EveAaA/DEBUG_SmartCar_main/DEBUG_SmartCar_PCB/DEBUG_DRV8701_MotorDriver/PCB参考布局布线图.jpg

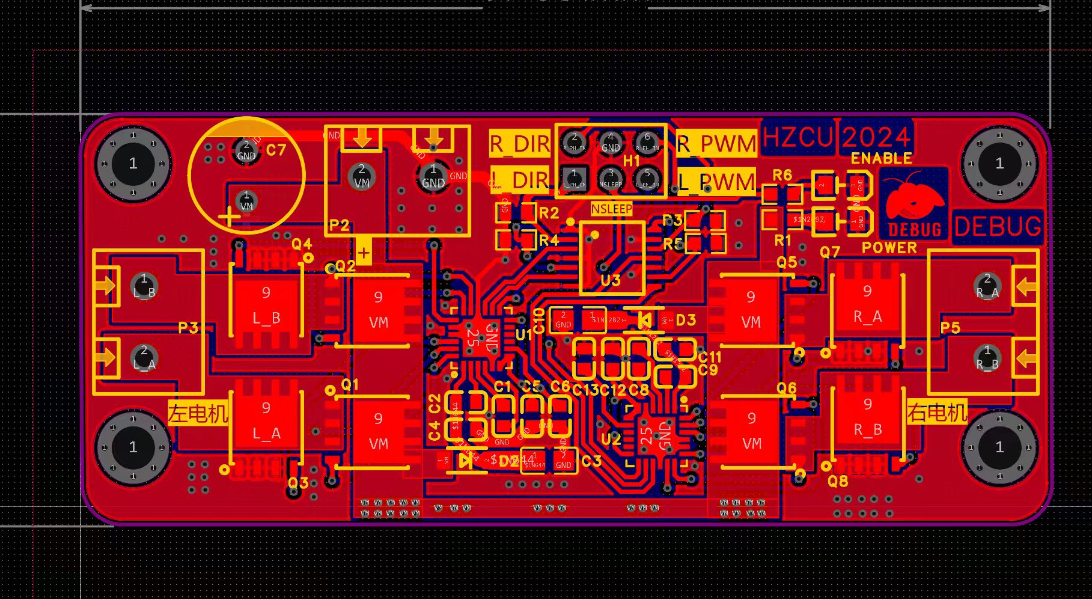
DEBUG_SmartCar_PCB/DEBUG_DRV8701_MotorDriver/PCB参考布局布线图.jpg
