EveAaA/DEBUG_SmartCar_main/DEBUG_SmartCar_PCB/DEBUG_SmartCar_MotherBoard_V4/引脚分配v1.3.xlsx

总钻风摄像头 | TXD | C29 | 3.3v
 | RXD | C28
 | PCLK | B20
 | VSY | B22
 | D0-D7 | B31-B24
正交编码器LF | A相 | C2 | 3.3v
 | B相 | C24
正交编码器LB | A相 | B16 | 3.3v
 | B相 | B17
正交编码器RF | A相 | C0 | 3.3v
 | B相 | C1
正交编码器RB | A相 | C3 | 3.3v
 | B相 | C25
IMU660RA | SCK | C23 | 3.3v
 | MOSI | C22
 | MISO | C21
 | CS | C20
 | INT | 悬空
 | NC | 悬空
单排针TFT1.8屏幕 | SCK | B0 | 3.3v
 | MOSI | B1
 | RST | B2
 | DC | C19
 | CS | B3
 | BL | C18
电机LF | DIR | C11
 | PWM | D12
电机RF | DIR | C31
 | PWM | D13
电机LB | DIR | C30
 | PWM | D15
电机RB | DIR | C27
 | PWM | D14
蓝牙模块 | TX(UART8) | D17 | 5v
 | RX | D16
 | RTS | D26
openart mini 1 | TX(UART1) | B13 | 5v
 | RX | B12
openart mini 2 | TX(UART4) | C17
 | RX | C16
openart mini 3 | TX(UART2) | B19
 | RX | B18
openart mini 4 | TX(UART3) | C9
 | RX | C8
DLB | SCL | B9 | 5v
 | SDA | B10
 | XS | D4
 | INT | B15
舵机1 左边 | PWM | D0 | 8v
舵机2 右边 | PWM | D1
舵机3 机械臂 | PWM | D2
舵机4 机械臂 | PWM | D3
舵机5 旋转 | PWM | B11
舵机6 开门 | PWM | C6
旋转编码器 A | INPUT | B23
旋转编码器 B | INPUT | B14
旋转编码器 D | INPUT | C26
有源蜂鸣器 | OUTPUT | B21 | 5v
电磁铁 1 | OUTPUT | C26
电磁铁 2 | OUTPUT | C12
电磁铁 3 | OUTPUT | C14
电磁铁 4 | OUTPUT | C15
电磁铁 5 | OUTPUT | C13
电磁铁 6 | OUTPUT | D27
