EveAaA/DEBUG_SmartCar_main/DEBUG_SmartCar_Vision/Src/PLAN_A_MT9V034/README.md

总钻风图像像素148 * 80

基本思路
1.高斯滤波
2.sobel边缘梯度提取
2.对梯度高斯加权 (harris角点检测思路)
3.非极大值抑制
4.对超过阈值角点做标记

算法未优化, 未整合

####
总风钻总体思路

实时检测获取跑道两侧图像梯度信息
若有多个置信度高的角点在某一侧, 即
小车往某一侧跑(也需要跑个死距离)

####
