EveAaA/DEBUG_SmartCar_main/DEBUG_SmartCar_Vision/MCX_DEBUG/project/mdk/Objects/mcx_vision_board.htm

# Static Call Graph for image .\Objects\mcx_vision_board.axf

#<CALLGRAPH># ARM Linker, 6190004: Last Updated: Tue Aug 6 01:49:51 2024

### Maximum Stack Usage = 1968 bytes + Unknown(Functions without stacksize, Cycles, Untraceable Function Pointers)

### Call chain for Maximum Stack Depth:

_printf_f ⇒ _printf_fp_dec ⇒ _printf_fp_dec_real ⇒ _fp_digits ⇒ _btod_main ⇒ _btod_common ⇒ _btod_pow ⇒ _btod_mul

### Functions with no stack information

- Reset_Handler
- ADC0_DriverIRQHandler
- ADC1_DriverIRQHandler
- BSP32_DriverIRQHandler
- BusFault_Handler
- CAN0_DriverIRQHandler
- CAN1_DriverIRQHandler
- CDOG0_DriverIRQHandler
- CDOG1_DriverIRQHandler
- CMC0_DriverIRQHandler
- CTI0_DriverIRQHandler
- DAC0_DriverIRQHandler
- DAC1_DriverIRQHandler
- DAC2_DriverIRQHandler
- DebugMon_Handler
- DefaultISR
- ELS_DriverIRQHandler
- ELS_ERR_DriverIRQHandler
- EMVSIM0_DriverIRQHandler
- EMVSIM1_DriverIRQHandler
- ENC0_COMPARE_DriverIRQHandler
- ENC0_HOME_DriverIRQHandler
- ENC0_IDX_DriverIRQHandler
- ENC0_WDG_SAB_DriverIRQHandler
- ENC1_COMPARE_DriverIRQHandler
- ENC1_HOME_DriverIRQHandler
- ENC1_IDX_DriverIRQHandler
- ENC1_WDG_SAB_DriverIRQHandler
- ERM_MULTI_BIT_ERROR_DriverIRQHandler
- ERM_SINGLE_BIT_ERROR_DriverIRQHandler
- ETB0_DriverIRQHandler
- ETHERNET_DriverIRQHandler
- ETHERNET_MACLP_DriverIRQHandler
- ETHERNET_PMT_DriverIRQHandler
- EWM0_DriverIRQHandler
- FLEXPWM0_FAULT_DriverIRQHandler
- FLEXPWM0_RELOAD_ERROR_DriverIRQHandler
- FLEXPWM0_SUBMODULE0_DriverIRQHandler
- FLEXPWM0_SUBMODULE1_DriverIRQHandler
- FLEXPWM0_SUBMODULE2_DriverIRQHandler
- FLEXPWM0_SUBMODULE3_DriverIRQHandler
- FLEXPWM1_FAULT_DriverIRQHandler
- FLEXPWM1_RELOAD_ERROR_DriverIRQHandler
- FLEXPWM1_SUBMODULE0_DriverIRQHandler
- FLEXPWM1_SUBMODULE1_DriverIRQHandler
- FLEXPWM1_SUBMODULE2_DriverIRQHandler
- FLEXPWM1_SUBMODULE3_DriverIRQHandler
- FLEXSPI0_DriverIRQHandler
- FMU0_DriverIRQHandler
- Freqme_DriverIRQHandler
- GDET_DriverIRQHandler
- GPIO00_DriverIRQHandler
- GPIO01_DriverIRQHandler
- GPIO10_DriverIRQHandler
- GPIO11_DriverIRQHandler
- GPIO20_DriverIRQHandler
- GPIO21_DriverIRQHandler
- GPIO30_DriverIRQHandler
- GPIO31_DriverIRQHandler
- GPIO40_DriverIRQHandler
- GPIO41_DriverIRQHandler
- GPIO50_DriverIRQHandler
- GPIO51_DriverIRQHandler
- HSCMP0_DriverIRQHandler
- HSCMP1_DriverIRQHandler
- HSCMP2_DriverIRQHandler
- I3C0_DriverIRQHandler
- I3C1_DriverIRQHandler
- ITRC0_DriverIRQHandler
- LPTMR0_DriverIRQHandler
- LPTMR1_DriverIRQHandler
- MAILBOX_DriverIRQHandler
- MRT0_DriverIRQHandler
- MemManage_Handler
- NPU_DriverIRQHandler
- OR_DriverIRQHandler
- OS_EVENT_DriverIRQHandler
- PDM_EVENT_DriverIRQHandler
- PINT0_DriverIRQHandler
- PKC_DriverIRQHandler
- PKC_ERR_DriverIRQHandler
- PORT_EFT_DriverIRQHandler
- PQ_DriverIRQHandler
- PUF_DriverIRQHandler
- RTC_DriverIRQHandler
- Reserved65_DriverIRQHandler
- Reserved80_DriverIRQHandler
- Reserved81_DriverIRQHandler
- Reserved85_DriverIRQHandler
- SAI0_DriverIRQHandler
- SAI1_DriverIRQHandler
- SCG_DriverIRQHandler
- SCT0_DriverIRQHandler
- SEC_HYPERVISOR_CALL_DriverIRQHandler
- SEC_VIO_DriverIRQHandler
- SINC_FILTER_DriverIRQHandler
- SM3_DriverIRQHandler
- SMARTDMA_DriverIRQHandler
- SPC_DriverIRQHandler
- SecureFault_Handler
- TRNG0_DriverIRQHandler
- TSI_END_OF_SCAN_DriverIRQHandler
- TSI_OUT_OF_SCAN_DriverIRQHandler
- USB0_DCD_DriverIRQHandler
- USB0_FS_DriverIRQHandler
- USB1_HS_DriverIRQHandler
- USB1_HS_PHY_DriverIRQHandler
- UTICK0_DriverIRQHandler
- UsageFault_Handler
- VBAT0_DriverIRQHandler
- WUU_DriverIRQHandler
- WWDT0_DriverIRQHandler
- WWDT1_DriverIRQHandler
- NMI_Handler
- SVC_Handler
- PendSV_Handler
- SysTick_Handler
- OR_IRQHandler
- EDMA_0_CH0_IRQHandler
- EDMA_0_CH1_IRQHandler
- EDMA_0_CH2_IRQHandler
- EDMA_0_CH3_IRQHandler
- EDMA_0_CH4_IRQHandler
- EDMA_0_CH5_IRQHandler
- EDMA_0_CH6_IRQHandler
- EDMA_0_CH7_IRQHandler
- EDMA_0_CH8_IRQHandler
- EDMA_0_CH9_IRQHandler
- EDMA_0_CH10_IRQHandler
- EDMA_0_CH11_IRQHandler
- EDMA_0_CH12_IRQHandler
- EDMA_0_CH13_IRQHandler
- EDMA_0_CH14_IRQHandler
- EDMA_0_CH15_IRQHandler
- UTICK0_IRQHandler
- MRT0_IRQHandler
- CTIMER0_IRQHandler
- CTIMER1_IRQHandler
- SCT0_IRQHandler
- CTIMER2_IRQHandler
- LP_FLEXCOMM0_IRQHandler
- LP_FLEXCOMM1_IRQHandler
- LP_FLEXCOMM2_IRQHandler
- LP_FLEXCOMM3_IRQHandler
- LP_FLEXCOMM6_IRQHandler
- LP_FLEXCOMM7_IRQHandler
- LP_FLEXCOMM8_IRQHandler
- LP_FLEXCOMM9_IRQHandler
- ADC0_IRQHandler
- ADC1_IRQHandler
- PINT0_IRQHandler
- PDM_EVENT_IRQHandler
- Reserved65_IRQHandler
- USB0_FS_IRQHandler
- USB0_DCD_IRQHandler
- RTC_IRQHandler
- MAILBOX_IRQHandler
- CTIMER3_IRQHandler
- CTIMER4_IRQHandler
- OS_EVENT_IRQHandler
- FLEXSPI0_IRQHandler
- SAI0_IRQHandler
- SAI1_IRQHandler
- USDHC0_IRQHandler
- CAN0_IRQHandler
- CAN1_IRQHandler
- Reserved80_IRQHandler
- Reserved81_IRQHandler
- USB1_HS_PHY_IRQHandler
- USB1_HS_IRQHandler
- SEC_HYPERVISOR_CALL_IRQHandler
- Reserved85_IRQHandler
- PLU_IRQHandler
- Freqme_IRQHandler
- SEC_VIO_IRQHandler
- ELS_IRQHandler
- PKC_IRQHandler
- PUF_IRQHandler
- PQ_IRQHandler
- EDMA_1_CH0_IRQHandler
- EDMA_1_CH1_IRQHandler
- EDMA_1_CH2_IRQHandler
- EDMA_1_CH3_IRQHandler
- EDMA_1_CH4_IRQHandler
- EDMA_1_CH5_IRQHandler
- EDMA_1_CH6_IRQHandler
- EDMA_1_CH7_IRQHandler
- EDMA_1_CH8_IRQHandler
- EDMA_1_CH9_IRQHandler
- EDMA_1_CH10_IRQHandler
- EDMA_1_CH11_IRQHandler
- EDMA_1_CH12_IRQHandler
- EDMA_1_CH13_IRQHandler
- EDMA_1_CH14_IRQHandler
- EDMA_1_CH15_IRQHandler
- CDOG0_IRQHandler
- CDOG1_IRQHandler
- I3C0_IRQHandler
- I3C1_IRQHandler
- NPU_IRQHandler
- GDET_IRQHandler
- VBAT0_IRQHandler
- EWM0_IRQHandler
- TSI_END_OF_SCAN_IRQHandler
- TSI_OUT_OF_SCAN_IRQHandler
- EMVSIM0_IRQHandler
- EMVSIM1_IRQHandler
- FLEXIO_IRQHandler
- DAC0_IRQHandler
- DAC1_IRQHandler
- DAC2_IRQHandler
- HSCMP0_IRQHandler
- HSCMP1_IRQHandler
- HSCMP2_IRQHandler
- FLEXPWM0_RELOAD_ERROR_IRQHandler
- FLEXPWM0_FAULT_IRQHandler
- FLEXPWM0_SUBMODULE0_IRQHandler
- FLEXPWM0_SUBMODULE1_IRQHandler
- FLEXPWM0_SUBMODULE2_IRQHandler
- FLEXPWM0_SUBMODULE3_IRQHandler
- FLEXPWM1_RELOAD_ERROR_IRQHandler
- FLEXPWM1_FAULT_IRQHandler
- FLEXPWM1_SUBMODULE0_IRQHandler
- FLEXPWM1_SUBMODULE1_IRQHandler
- FLEXPWM1_SUBMODULE2_IRQHandler
- FLEXPWM1_SUBMODULE3_IRQHandler
- ENC0_COMPARE_IRQHandler
- ENC0_HOME_IRQHandler
- ENC0_WDG_SAB_IRQHandler
- ENC0_IDX_IRQHandler
- ENC1_COMPARE_IRQHandler
- ENC1_HOME_IRQHandler
- ENC1_WDG_SAB_IRQHandler
- ENC1_IDX_IRQHandler
- ITRC0_IRQHandler
- BSP32_IRQHandler
- ELS_ERR_IRQHandler
- PKC_ERR_IRQHandler
- ERM_SINGLE_BIT_ERROR_IRQHandler
- ERM_MULTI_BIT_ERROR_IRQHandler
- FMU0_IRQHandler
- ETHERNET_IRQHandler
- ETHERNET_PMT_IRQHandler
- ETHERNET_MACLP_IRQHandler
- SINC_FILTER_IRQHandler
- LPTMR0_IRQHandler
- LPTMR1_IRQHandler
- SCG_IRQHandler
- SPC_IRQHandler
- WUU_IRQHandler
- PORT_EFT_IRQHandler
- ETB0_IRQHandler
- SM3_IRQHandler
- TRNG0_IRQHandler
- WWDT0_IRQHandler
- WWDT1_IRQHandler
- CMC0_IRQHandler
- CTI0_IRQHandler
- Abs
- Activation
- Add
- BatchMulAdd
- BitTransformation
- CallKernel
- CallKernelWrapper
- CastInt16ToInt8
- CastInt8ToInt16
- Conv1DStandard
- Conv2DAtrous
- Conv2DDepthwiseNeutron16x16Kernel3x3
- Conv2DDepthwiseV1
- Conv2DDepthwiseV2
- Conv2DPointwise
- Conv2DStandardV1
- Conv2DStandardV2
- Conv2DStandardV3
- DebugLog
- EXEC
- FullyConnected
- GetKernelArgSz
- GetKernelArgSzWrapper
- GetMaxArgSz
- GlobalAvgPool
- GlobalMaxPool
- InvokeDebugLogCallback
- MaxPool
- MemCpy
- MirrorPad
- MulInt16
- NeutronFirmwareTraceInit
- NeutronMicroInstrPost
- NeutronMicroInstrPre
- Pad
- Sequence
- Slice
- TfLiteIntArrayEqual
- TfLiteIntArrayGetSizeInBytes
- TfLiteTypeGetName
- Upsample2DV1
- MicroPrintf(char const*, ...)
- VMicroPrintf(char const*, std::__va_list)
- AbortImpl()
- flatbuffers::Vector⟨long⟩ const* flatbuffers::Table::GetPointer⟨flatbuffers::Vector⟨long⟩ const*⟩(unsigned short)
- tflite::PadPrepare(TfLiteContext*, TfLiteNode*)
- tflite::ParseSlice(tflite::Operator const*, tflite::ErrorReporter*, tflite::BuiltinDataAllocator*, void**)
- tflite::PrepareAdd(TfLiteContext*, TfLiteNode*)
- tflite::AlignSizeUp(unsigned int, unsigned int)
- tflite::ParseConv2D(tflite::Operator const*, tflite::ErrorReporter*, tflite::BuiltinDataAllocator*, void**)
- tflite::ElementCount(TfLiteIntArray const&)
- tflite::MicroContext::AllocateTempInputTensor(TfLiteNode const*, int)
- tflite::MicroContext::AllocateTempOutputTensor(TfLiteNode const*, int)
- tflite::ParseSoftmax(tflite::Operator const*, tflite::ErrorReporter*, tflite::BuiltinDataAllocator*, void**)
- tflite::Register_ADD()
- tflite::Register_PAD()
- tflite::tensor_utils::UnpackDenseInt4IntoInt8(signed char const*, int, signed char*)
- tflite::ErrorReporter::Report(char const*, ...)
- tflite::ParseQuantize(tflite::Operator const*, tflite::ErrorReporter*, tflite::BuiltinDataAllocator*, void**)
- tflite::reference_ops::ProcessBroadcastShapes(tflite::RuntimeShape const&, tflite::RuntimeShape const&, tflite::ArithmeticParams*)
- void tflite::reference_ops::BroadcastAddRecursiveDimensions⟨float⟩(int, unsigned int*, unsigned int*, unsigned int*, unsigned int*, unsigned int*, unsigned int*, float, float, float const*, float const*, float*)
- void tflite::reference_ops::BroadcastAddRecursiveDimensions⟨long⟩(int, unsigned int*, unsigned int*, unsigned int*, unsigned int*, unsigned int*, unsigned int*, long, long, long const*, long const*, long*)
- void tflite::reference_ops::BroadcastAddRecursiveDimensions⟨short⟩(tflite::ArithmeticParams const&, int, unsigned int*, unsigned int*, unsigned int*, unsigned int*, unsigned int*, unsigned int*, short const*, short const*, short*)
- tflite::reference_ops::MaxPool(tflite::PoolParams const&, tflite::RuntimeShape const&, float const*, tflite::RuntimeShape const&, float*)
- void tflite::reference_ops::PadImpl⟨signed char, signed char⟩(tflite::PadParams const&, tflite::RuntimeShape const&, signed char const*, signed char const*, tflite::RuntimeShape const&, signed char*)
- void tflite::reference_ops::PadImpl⟨float, float⟩(tflite::PadParams const&, tflite::RuntimeShape const&, float const*, float const*, tflite::RuntimeShape const&, float*)
- void tflite::reference_ops::PadImpl⟨long, long⟩(tflite::PadParams const&, tflite::RuntimeShape const&, long const*, long const*, tflite::RuntimeShape const&, long*)
- void tflite::reference_ops::PadImpl⟨short, short⟩(tflite::PadParams const&, tflite::RuntimeShape const&, short const*, short const*, tflite::RuntimeShape const&, short*)
- tflite::AlignPointerUp(unsigned char*, unsigned int)
- tflite::DequantizeEval(TfLiteContext*, TfLiteNode*)
- tflite::DequantizeInit(TfLiteContext*, char const*, unsigned int)
- tflite::GetBuiltinCode(tflite::OperatorCode const*)
- tflite::GetTensorShape(TfLiteTensor const*)
- tflite::HaveSameShapes(TfLiteTensor const*, TfLiteTensor const*)
- tflite::MicroAllocator::AllocateVariables(tflite::SubGraph const*, TfLiteEvalTensor*, long const*)
- tflite::MicroAllocator::AllocateTempBuffer(unsigned int, unsigned int)
- tflite::MicroAllocator::DeallocateTempBuffer(unsigned char*)
- tflite::MicroAllocator::IsAllTempDeallocated()
- tflite::MicroAllocator::ResetTempAllocations()
- tflite::MicroAllocator::StartModelAllocation(tflite::Model const*)
- tflite::MicroAllocator::FinishModelAllocation(tflite::Model const*, tflite::SubgraphAllocations*, tflite::ScratchBufferHandle**)
- tflite::MicroAllocator::InitScratchBufferData()
- tflite::MicroAllocator::CommitStaticMemoryPlan(tflite::Model const*, tflite::SubgraphAllocations*, tflite::ScratchBufferHandle*)
- tflite::MicroAllocator::GetBuiltinDataAllocator()
- tflite::MicroAllocator::AllocatePersistentBuffer(unsigned int)
- tflite::MicroAllocator::AllocateTempTfLiteTensor(tflite::Model const*, tflite::SubgraphAllocations const*, int, int)
- tflite::MicroAllocator::GetScratchBufferRequests()
- tflite::MicroAllocator::AllocateTfLiteEvalTensors(tflite::Model const*, tflite::SubgraphAllocations*)
- tflite::MicroAllocator::DeallocateTempTfLiteTensor(TfLiteTensor*)
- tflite::MicroAllocator::RequestScratchBufferInArena(unsigned int, int, int*)
- tflite::MicroAllocator::AllocateNodeAndRegistrations(tflite::Model const*, tflite::SubgraphAllocations*)
- tflite::MicroAllocator::AllocateScratchBufferHandles(tflite::ScratchBufferHandle**, unsigned int)
- tflite::MicroAllocator::FinishPrepareNodeAllocations(int)
- tflite::MicroAllocator::AllocatePersistentTfLiteTensor(tflite::Model const*, tflite::SubgraphAllocations const*, int, int)
- tflite::MicroAllocator::PopulateTfLiteTensorFromFlatbuffer(tflite::Model const*, TfLiteTensor*, int, int, bool)
- tflite::MicroAllocator::AllocatePersistentTfLiteTensorInternal()
- tflite::MicroAllocator::Create(tflite::SingleArenaBufferAllocator*, tflite::MicroMemoryPlanner*)
- tflite::MicroAllocator::Create(unsigned char*, unsigned int, tflite::MemoryPlannerType)
- tflite::MicroAllocator::~MicroAllocator__deallocating()
- tflite::MicroAllocator::~MicroAllocator()
- tflite::MicroAllocator::~MicroAllocator__sub_object()
- tflite::PoolingPrepare(TfLiteContext*, TfLiteNode*)
- tflite::Register_SLICE()
- tflite::ConvParamsFloat(TfLiteConvParams const&, tflite::OpDataConv const&)
- tflite::ParseDequantize(tflite::Operator const*, tflite::ErrorReporter*, tflite::BuiltinDataAllocator*, void**)
- tflite::AlignPointerDown(unsigned char*, unsigned int)
- tflite::MicroInterpreter::AllocateTensors()
- tflite::MicroInterpreter::PrepareNodeAndRegistrationDataFromFlatbuffer()
- tflite::MicroInterpreter::Init(tflite::MicroProfilerInterface*)
- tflite::MicroInterpreter::Reset()
- tflite::MicroInterpreter::input(unsigned int)
- tflite::MicroInterpreter::Invoke()
- tflite::MicroInterpreter::output(unsigned int)
- tflite::MicroInterpreter::MicroInterpreter(tflite::Model const*, tflite::MicroOpResolver const&, unsigned char*, unsigned int, tflite::MicroResourceVariables*, tflite::MicroProfilerInterface*, bool)
- tflite::MicroInterpreter::MicroInterpreter__sub_object(tflite::Model const*, tflite::MicroOpResolver const&, unsigned char*, unsigned int, tflite::MicroResourceVariables*, tflite::MicroProfilerInterface*, bool)
- tflite::MicroInterpreter::~MicroInterpreter()
- tflite::MicroInterpreter::~MicroInterpreter__sub_object()
- tflite::Register_CONV_2D()
- tflite::Register_SOFTMAX()
- tflite::TfLiteTypeSizeOf(TfLiteType, unsigned int*)
- tflite::ConvertTensorType(tflite::TensorType, TfLiteType*)
- tflite::ConvertTensorType(tflite::TensorType, TfLiteType*, tflite::ErrorReporter*)
- tflite::DequantizePrepare(TfLiteContext*, TfLiteNode*)
- tflite::Register_QUANTIZE()
- tflite::MicroErrorReporter::Report(char const*, std::__va_list)
- tflite::MicroErrorReporter::~MicroErrorReporter__deallocating()
- tflite::MicroErrorReporter::~MicroErrorReporter()
- tflite::MicroErrorReporter::~MicroErrorReporter__sub_object()
- tflite::MicroMemoryPlanner::PrintMemoryPlan()
- tflite::MicroMemoryPlanner::Init(unsigned char*, int)
- tflite::MicroMemoryPlanner::AddBuffer(int, int, int, int)
- tflite::ParseConcatenation(tflite::Operator const*, tflite::ErrorReporter*, tflite::BuiltinDataAllocator*, void**)
- tflite::QuantizeMultiplier(double, long*, int*)
- tflite::ReverseSortInPlace(int*, int*, int)
- tflite::CalculateOpDataConv(TfLiteContext*, TfLiteNode*, TfLiteConvParams const&, int, int, int, int, int, int, TfLiteType, tflite::OpDataConv*)
- tflite::ConvParamsQuantized(TfLiteConvParams const&, tflite::OpDataConv const&)
- tflite::GreedyMemoryPlanner::GetBufferCount()
- tflite::GreedyMemoryPlanner::PrintMemoryPlan()
- tflite::GreedyMemoryPlanner::GetOffsetForBuffer(int, int*)
- tflite::GreedyMemoryPlanner::GetMaximumMemorySize()
- tflite::GreedyMemoryPlanner::CalculateOffsetsIfNeeded()
- tflite::GreedyMemoryPlanner::NextSimultaneouslyActiveBuffer(tflite::GreedyMemoryPlanner::ListEntry const*, int, int)
- tflite::GreedyMemoryPlanner::Init(unsigned char*, int)
- tflite::GreedyMemoryPlanner::AddBuffer(int, int, int)
- tflite::GreedyMemoryPlanner::AddBuffer(int, int, int, int)
- tflite::GreedyMemoryPlanner::GreedyMemoryPlanner()
- tflite::GreedyMemoryPlanner::GreedyMemoryPlanner__sub_object()
- tflite::GreedyMemoryPlanner::~GreedyMemoryPlanner__deallocating()
- tflite::GreedyMemoryPlanner::~GreedyMemoryPlanner()
- tflite::GreedyMemoryPlanner::~GreedyMemoryPlanner__sub_object()
- tflite::LinearMemoryPlanner::GetBufferCount()
- tflite::LinearMemoryPlanner::GetOffsetForBuffer(int, int*)
- tflite::LinearMemoryPlanner::GetMaximumMemorySize()
- tflite::LinearMemoryPlanner::AddBuffer(int, int, int)
- tflite::LinearMemoryPlanner::LinearMemoryPlanner()
- tflite::LinearMemoryPlanner::LinearMemoryPlanner__sub_object()
- tflite::LinearMemoryPlanner::~LinearMemoryPlanner__deallocating()
- tflite::LinearMemoryPlanner::~LinearMemoryPlanner()
- tflite::LinearMemoryPlanner::~LinearMemoryPlanner__sub_object()
- tflite::MaxPoolingEvalFloat(TfLiteContext*, TfLiteNode*, TfLitePoolParams*, tflite::OpDataPooling const*, TfLiteEvalTensor const*, TfLiteEvalTensor*)
- tflite::Register_DEQUANTIZE()
- tflite::ScopedMicroProfiler::~ScopedMicroProfiler()
- tflite::ScopedMicroProfiler::~ScopedMicroProfiler__sub_object()
- tflite::CalculateInputRadius(int, int, int)
- tflite::NumSubgraphOperators(tflite::Model const*, int)
- tflite::NumSubgraphOperators(tflite::SubGraph const*)
- tflite::ParseDepthwiseConv2D(tflite::Operator const*, tflite::ErrorReporter*, tflite::BuiltinDataAllocator*, void**)
- tflite::Register_MAX_POOL_2D()
- tflite::AllocationInfoBuilder::ValidateSubgraph(tflite::SubGraph const*, TfLiteEvalTensor*)
- tflite::AllocationInfoBuilder::FreeAllocationInfo()
- tflite::AllocationInfoBuilder::CreateAllocationInfo(int)
- tflite::AllocationInfoBuilder::MarkAllocationLifetimes(int, tflite::internal::ScratchBufferRequest*, tflite::ScratchBufferHandle*, tflite::SubgraphAllocations*)
- tflite::AllocationInfoBuilder::GetOfflinePlannedOffsets(long const**)
- tflite::AllocationInfoBuilder::InitializeAllocationInfo(long const*, tflite::SubgraphAllocations*)
- tflite::AllocationInfoBuilder::MarkSubgraphLifetimesIfNecessary(tflite::Operator const*, tflite::internal::ScratchBufferRequest*, tflite::ScratchBufferHandle*, tflite::SubgraphAllocations*)
- tflite::EvalQuantizeReference(TfLiteContext*, TfLiteNode*)
- tflite::GetMicroErrorReporter()
- tflite::MicroContextGetTensor(TfLiteContext const*, int)
- tflite::MicroInterpreterGraph::NumSubgraphs()
- tflite::MicroInterpreterGraph::FreeSubgraphs()
- tflite::MicroInterpreterGraph::InitSubgraphs()
- tflite::MicroInterpreterGraph::InvokeSubgraph(int)
- tflite::MicroInterpreterGraph::ResetSubgraphs()
- tflite::MicroInterpreterGraph::GetSubgraphInput(int, int)
- tflite::MicroInterpreterGraph::PrepareSubgraphs()
- tflite::MicroInterpreterGraph::GetSubgraphOutput(int, int)
- tflite::MicroInterpreterGraph::NumSubgraphInputs(int)
- tflite::MicroInterpreterGraph::NumSubgraphOutputs(int)
- tflite::MicroInterpreterGraph::GetResourceVariables()
- tflite::MicroInterpreterGraph::ResetVariableTensors()
- tflite::MicroInterpreterGraph::SetSubgraphAllocations(tflite::SubgraphAllocations*)
- tflite::MicroInterpreterGraph::MicroInterpreterGraph(TfLiteContext*, tflite::Model const*, tflite::MicroAllocator*, tflite::MicroResourceVariables*)
- tflite::MicroInterpreterGraph::MicroInterpreterGraph__sub_object(TfLiteContext*, tflite::Model const*, tflite::MicroAllocator*, tflite::MicroResourceVariables*)
- tflite::MicroInterpreterGraph::~MicroInterpreterGraph__deallocating()
- tflite::MicroInterpreterGraph::~MicroInterpreterGraph()
- tflite::MicroInterpreterGraph::~MicroInterpreterGraph__sub_object()
- tflite::reference_integer_ops::AddFunc(signed char, signed char, tflite::ArithmeticParams const&)
- tflite::BytesRequiredForTensor(tflite::Tensor const&, unsigned int*, unsigned int*)
- tflite::CalculateOpDataPooling(TfLiteContext const*, TfLitePoolParams const*, TfLiteTensor const*, TfLiteTensor const*, tflite::OpDataPooling*)
- tflite::CalculateSoftmaxParams(TfLiteContext*, TfLiteTensor const*, TfLiteTensor*, TfLiteSoftmaxParams const*, tflite::SoftmaxParams*)
- tflite::MicroResourceVariables::ResetAll()
- tflite::Register_CONCATENATION()
- tflite::EnumNameBuiltinOperator(tflite::BuiltinOperator)
- tflite::MicroInterpreterContext::GetEvalTensor(int)
- tflite::MicroInterpreterContext::GetScratchBuffer(int)
- tflite::MicroInterpreterContext::external_context()
- tflite::MicroInterpreterContext::AllocateTempBuffer(unsigned int, unsigned int)
- tflite::MicroInterpreterContext::SetInterpreterState(tflite::MicroInterpreterContext::InterpreterState)
- tflite::MicroInterpreterContext::DeallocateTempBuffer(unsigned char*)
- tflite::MicroInterpreterContext::set_external_context(void*)
- tflite::MicroInterpreterContext::SetScratchBufferHandles(tflite::ScratchBufferHandle*)
- tflite::MicroInterpreterContext::AllocatePersistentBuffer(unsigned int)
- tflite::MicroInterpreterContext::AllocateTempTfLiteTensor(int)
- tflite::MicroInterpreterContext::DeallocateTempTfLiteTensor(TfLiteTensor*)
- tflite::MicroInterpreterContext::RequestScratchBufferInArena(unsigned int, int*)
- tflite::MicroInterpreterContext::graph()
- tflite::MicroInterpreterContext::MicroInterpreterContext(tflite::MicroAllocator*, tflite::Model const*, tflite::MicroInterpreterGraph*)
- tflite::MicroInterpreterContext::MicroInterpreterContext__sub_object(tflite::MicroAllocator*, tflite::Model const*, tflite::MicroInterpreterGraph*)
- tflite::MicroInterpreterContext::~MicroInterpreterContext__deallocating()
- tflite::MicroInterpreterContext::~MicroInterpreterContext()
- tflite::MicroInterpreterContext::~MicroInterpreterContext__sub_object()
- tflite::CallBuiltinParseFunction(TfLiteStatus (*)(tflite::Operator const*, tflite::ErrorReporter*, tflite::BuiltinDataAllocator*, void**), tflite::Operator const*, tflite::BuiltinDataAllocator*, void**)
- tflite::DepthwiseConvParamsFloat(TfLiteDepthwiseConvParams const&, tflite::OpDataConv const&)
- tflite::PrepareQuantizeReference(TfLiteContext*, TfLiteNode*)
- tflite::PreprocessSoftmaxScaling(double, double, int, long*, int*)
- tflite::GetRegistrationFromOpCode(tflite::OperatorCode const*, tflite::MicroOpResolver const&, TFLMRegistration const**)
- tflite::MicroContextGetEvalTensor(TfLiteContext const*, int)
- tflite::MicroContextReportOpError(TfLiteContext*, char const*, ...)
- tflite::ParseResizeNearestNeighbor(tflite::Operator const*, tflite::ErrorReporter*, tflite::BuiltinDataAllocator*, void**)
- tflite::Register_DEPTHWISE_CONV_2D()
- tflite::SingleArenaBufferAllocator::AllocateTemp(unsigned int, unsigned int)
- tflite::SingleArenaBufferAllocator::ResizeBuffer(unsigned char*, unsigned int, unsigned int)
- tflite::SingleArenaBufferAllocator::DeallocateTemp(unsigned char*)
- tflite::SingleArenaBufferAllocator::IsAllTempDeallocated()
- tflite::SingleArenaBufferAllocator::ResetTempAllocations()
- tflite::SingleArenaBufferAllocator::AllocateResizableBuffer(unsigned int, unsigned int)
- tflite::SingleArenaBufferAllocator::AllocatePersistentBuffer(unsigned int, unsigned int)
- tflite::SingleArenaBufferAllocator::DeallocateResizableBuffer(unsigned char*)
- tflite::SingleArenaBufferAllocator::ReserveNonPersistentOverlayMemory(unsigned int, unsigned int)
- tflite::SingleArenaBufferAllocator::Create(unsigned char*, unsigned int)
- tflite::SingleArenaBufferAllocator::SingleArenaBufferAllocator(unsigned char*, unsigned char*)
- tflite::SingleArenaBufferAllocator::SingleArenaBufferAllocator__sub_object(unsigned char*, unsigned char*)
- tflite::SingleArenaBufferAllocator::SingleArenaBufferAllocator(unsigned char*, unsigned int)
- tflite::SingleArenaBufferAllocator::SingleArenaBufferAllocator__sub_object(unsigned char*, unsigned int)
- tflite::SingleArenaBufferAllocator::~SingleArenaBufferAllocator__deallocating()
- tflite::SingleArenaBufferAllocator::~SingleArenaBufferAllocator()
- tflite::SingleArenaBufferAllocator::~SingleArenaBufferAllocator__sub_object()
- tflite::TfLiteEvalTensorByteLength(TfLiteEvalTensor const*, unsigned int*)
- tflite::CalculateOpDataDepthwiseConv(TfLiteContext*, TfLiteNode*, TfLiteDepthwiseConvParams const&, int, int, int, int, int, int, TfLiteType, tflite::OpDataConv*)
- tflite::MicroContextGetScratchBuffer(TfLiteContext*, int)
- bool tflite::ReduceDimensionsForBroadcast⟨6⟩(tflite::RuntimeShape const&, tflite::RuntimeShape const&, unsigned int*, unsigned int*, unsigned int*)
- tflite::MultiplyByQuantizedMultiplier(long, long, int)
- tflite::MicroContextGetExternalContext(TfLiteContext*, TfLiteExternalContextType)
- tflite::GetQuantizedConvolutionMultipler(TfLiteContext*, TfLiteTensor const*, TfLiteTensor const*, TfLiteTensor*, double*)
- tflite::GetQuantizedConvolutionMultipler(TfLiteContext*, TfLiteTensor const*, TfLiteTensor const*, TfLiteTensor const*, TfLiteTensor*, double*)
- tflite::QuantizeMultiplierGreaterThanOne(double, long*, int*)
- tflite::Register_RESIZE_NEAREST_NEIGHBOR()
- tflite::CalculateActivationRangeQuantized(TfLiteContext*, TfLiteFusedActivation, TfLiteTensor*, long*, long*)
- tflite::FlatBufferVectorToTfLiteTypeArray(flatbuffers::Vector⟨float⟩ const*)
- tflite::FlatBufferVectorToTfLiteTypeArray(flatbuffers::Vector⟨long⟩ const*)
- tflite::QuantizeMultiplierSmallerThanOneExp(double, long*, int*)
- tflite::MicroContextAllocatePersistentBuffer(TfLiteContext*, unsigned int)
- tflite::PopulateConvolutionQuantizationParams(TfLiteContext*, TfLiteTensor const*, TfLiteTensor const*, TfLiteTensor const*, TfLiteTensor*, TfLiteFusedActivation const&, long*, int*, long*, long*, long*, long*, int)
- tflite::MicroContextRequestScratchBufferInArena(TfLiteContext*, unsigned int, int*)
- tflite::micro::RegisterOp(void* (*)(TfLiteContext*, char const*, unsigned int), TfLiteStatus (*)(TfLiteContext*, TfLiteNode*), TfLiteStatus (*)(TfLiteContext*, TfLiteNode*), void (*)(TfLiteContext*, void*), void (*)(TfLiteContext*, void*))
- tflite::micro::GetEvalInput(TfLiteContext const*, TfLiteNode const*, int)
- tflite::micro::GetEvalOutput(TfLiteContext const*, TfLiteNode const*, int)
- tflite::micro::GetTensorShape(TfLiteEvalTensor const*)
- tflite::micro::RuntimePaddingType(TfLitePadding)
- tflite::micro::MakeUnpackedInt4Tensor(TfLiteContext*, int, TfLiteEvalTensor const*)
- tflite::EvalAdd(TfLiteContext*, TfLiteNode*)
- tflite::InitAdd(TfLiteContext*, char const*, unsigned int)
- tflite::ParseAdd(tflite::Operator const*, tflite::ErrorReporter*, tflite::BuiltinDataAllocator*, void**)
- tflite::ParsePad(tflite::Operator const*, tflite::ErrorReporter*, tflite::BuiltinDataAllocator*, void**)
- tflite::internal::GetFlatbufferTensorBuffer(tflite::Tensor const&, flatbuffers::Vector⟨flatbuffers::Offset⟨tflite::Buffer⟩⟩ const*)
- tflite::internal::InitializeTfLiteTensorFromFlatbuffer(tflite::IPersistentBufferAllocator*, tflite::INonPersistentBufferAllocator*, bool, tflite::Tensor const&, flatbuffers::Vector⟨flatbuffers::Offset⟨tflite::Buffer⟩⟩ const*, TfLiteTensor*)
- tflite::internal::InitializeTfLiteEvalTensorFromFlatbuffer(tflite::Tensor const&, flatbuffers::Vector⟨flatbuffers::Offset⟨tflite::Buffer⟩⟩ const*, TfLiteEvalTensor*)
- tflite::ParsePool(tflite::Operator const*, tflite::ErrorReporter*, tflite::BuiltinDataAllocator*, void**)
- flatbuffers::Table::GetOptionalFieldOffset(unsigned short) const
- signed char flatbuffers::Table::GetField⟨signed char⟩(unsigned short, signed char) const
- float flatbuffers::Table::GetField⟨float⟩(unsigned short, float) const
- unsigned char flatbuffers::Table::GetField⟨unsigned char⟩(unsigned short, unsigned char) const
- long flatbuffers::Table::GetField⟨long⟩(unsigned short, long) const
- tflite::MicroAllocator::used_bytes() const
- tflite::GreedyMemoryPlanner::preserves_all_tensors() const
- tflite::GreedyMemoryPlanner::DoesEntryOverlapInTime(tflite::GreedyMemoryPlanner::ListEntry const*, int, int) const
- tflite::LinearMemoryPlanner::preserves_all_tensors() const
- tflite::QuantizationParameters::zero_point() const
- tflite::QuantizationParameters::scale() const
- tflite::SingleArenaBufferAllocator::GetAvailableMemory(unsigned int) const
- tflite::SingleArenaBufferAllocator::GetPersistentUsedBytes() const
- tflite::SingleArenaBufferAllocator::GetOverlayMemoryAddress() const
- tflite::SingleArenaBufferAllocator::GetNonPersistentUsedBytes() const
- tflite::Model::subgraphs() const
- tflite::Tensor::is_variable() const
- tflite::Tensor::type() const
- tflite::Operator::builtin_options() const
- tflite::Operator::builtin_options_type() const
- tflite::SubGraph::tensors() const
- non-virtual thunk to tflite::SingleArenaBufferAllocator::AllocatePersistentBuffer(unsigned int, unsigned int)
- non-virtual thunk to tflite::SingleArenaBufferAllocator::~SingleArenaBufferAllocator__deallocating()
- non-virtual thunk to tflite::SingleArenaBufferAllocator::~SingleArenaBufferAllocator()
- non-virtual thunk to tflite::SingleArenaBufferAllocator::GetPersistentUsedBytes() const
- __wfe
- addTraceToBuffer
- arm_convolve_1_x_n_s8
- arm_convolve_1_x_n_s8_get_buffer_size
- arm_convolve_1x1_s8
- arm_convolve_1x1_s8_fast
- arm_convolve_fast_s16
- arm_convolve_s16
- arm_convolve_s8
- arm_convolve_s8_get_buffer_size
- arm_convolve_wrapper_s16
- arm_convolve_wrapper_s16_get_buffer_size
- arm_convolve_wrapper_s8
- arm_convolve_wrapper_s8_get_buffer_size
- arm_depthwise_conv_3x3_s8
- arm_depthwise_conv_s16
- arm_depthwise_conv_s8
- arm_depthwise_conv_s8_opt
- arm_depthwise_conv_s8_opt_get_buffer_size
- arm_depthwise_conv_wrapper_s8
- arm_depthwise_conv_wrapper_s8_get_buffer_size
- arm_elementwise_add_s16
- arm_elementwise_add_s8
- arm_max_pool_s16
- arm_max_pool_s8
- arm_nn_mat_mult_kernel_s16
- arm_nn_mat_mult_kernel_s8_s16
- arm_nn_mat_mult_nt_t_s8
- arm_nn_softmax_common_s8
- arm_q7_to_q15_with_offset
- arm_s8_to_s16_unordered_with_offset
- arm_softmax_s16
- arm_softmax_s8
- arm_softmax_s8_s16
- driverAlloc
- driverFree
- getTime
- neutronDeinit
- neutronFwInit
- neutronFwInterpreter
- neutronInit
- neutronModelPrepare
- neutronModelUnprepare
- neutronRunBlocking
- neutronSetTrace
- neutron_done
- neutron_exec
- privateNeutronDeinit
- privateNeutronInit
- privateNeutronModelPrepare
- privateNeutronModelUnprepare
- privateNeutronRunBlocking
- privateNeutronSetTrace
- relocateData
- traceEvent
- validateArgsSz
- tflite::(anonymous namespace)::MicroBuiltinDataAllocator::Allocate(unsigned int, unsigned int)
- tflite::(anonymous namespace)::MicroBuiltinDataAllocator::Deallocate(void*)
- tflite::(anonymous namespace)::MicroBuiltinDataAllocator::~MicroBuiltinDataAllocator__deallocating()
- tflite::(anonymous namespace)::MicroBuiltinDataAllocator::~MicroBuiltinDataAllocator()
- tflite::MicroInterpreter::inputs_size() const (.isra.0)
- tflite::MicroInterpreter::outputs_size() const (.isra.0)
- (anonymous namespace)::VDebugLog(char const*, ...) (.constprop.0)
- tflite::(anonymous namespace)::ConvertPadding(tflite::Padding)
- tflite::(anonymous namespace)::SafeBuiltinDataAllocator::BuiltinDataDeleter::operator()(void*) (.isra.0)
- void tflite::reference_integer_ops::BroadcastAddRecursiveDimensions⟨signed char⟩(tflite::ArithmeticParams const&, int, unsigned int*, unsigned int*, unsigned int*, unsigned int*, unsigned int*, unsigned int*, signed char const*, signed char const*, signed char*, void (*)(tflite::ArithmeticParams const&), signed char (*)(signed char, signed char, tflite::ArithmeticParams const&)) (.isra.0)
- tflite::(anonymous namespace)::EvalAddQuantizedInt8(TfLiteContext*, TfLiteNode*, TfLiteAddParams*, tflite::(anonymous namespace)::OpData const*, TfLiteEvalTensor const*, TfLiteEvalTensor const*, TfLiteEvalTensor*) (.constprop.0)
- tflite::(anonymous namespace)::EvalAddQuantizedInt16(TfLiteContext*, TfLiteNode*, TfLiteAddParams*, tflite::(anonymous namespace)::OpData const*, TfLiteEvalTensor const*, TfLiteEvalTensor const*, TfLiteEvalTensor*) (.constprop.0)
- tflite::(anonymous namespace)::EvalAdd(TfLiteContext*, TfLiteNode*, TfLiteAddParams*, tflite::(anonymous namespace)::OpData const*, TfLiteEvalTensor const*, TfLiteEvalTensor const*, TfLiteEvalTensor*) (.constprop.0)
- tflite::(anonymous namespace)::Init(TfLiteContext*, char const*, unsigned int)
- tflite::(anonymous namespace)::Prepare(TfLiteContext*, TfLiteNode*)
- void tflite::(anonymous namespace)::EvalUnquantized⟨long long⟩(TfLiteContext*, TfLiteNode*)
- void tflite::(anonymous namespace)::EvalUnquantized⟨bool⟩(TfLiteContext*, TfLiteNode*)
- void tflite::(anonymous namespace)::EvalUnquantized⟨signed char⟩(TfLiteContext*, TfLiteNode*)
- void tflite::(anonymous namespace)::EvalUnquantized⟨short⟩(TfLiteContext*, TfLiteNode*)
- void tflite::(anonymous namespace)::EvalUnquantized⟨long⟩(TfLiteContext*, TfLiteNode*)
- void tflite::(anonymous namespace)::EvalUnquantized⟨float⟩(TfLiteContext*, TfLiteNode*)
- tflite::(anonymous namespace)::Eval(TfLiteContext*, TfLiteNode*)
- tflite::(anonymous namespace)::Init(TfLiteContext*, char const*, unsigned int)
- tflite::(anonymous namespace)::Prepare(TfLiteContext*, TfLiteNode*)
- tflite::(anonymous namespace)::EvalQuantizedPerChannel16x8(TfLiteContext*, TfLiteNode*, TfLiteConvParams const&, tflite::(anonymous namespace)::OpData const&, TfLiteEvalTensor const*, TfLiteEvalTensor const*, TfLiteEvalTensor const*, TfLiteEvalTensor*) (.constprop.0)
- tflite::(anonymous namespace)::EvalQuantizedPerChannel(TfLiteContext*, TfLiteNode*, TfLiteConvParams const&, tflite::(anonymous namespace)::OpData const&, TfLiteEvalTensor const*, TfLiteEvalTensor const*, TfLiteEvalTensor const*, TfLiteEvalTensor*) (.constprop.0)
- void tflite::reference_integer_ops::ConvPerChannel⟨long⟩(tflite::ConvParams const&, long const*, long const*, tflite::RuntimeShape const&, short const*, tflite::RuntimeShape const&, signed char const*, tflite::RuntimeShape const&, long const*, tflite::RuntimeShape const&, short*) (.isra.0)
- tflite::(anonymous namespace)::Eval(TfLiteContext*, TfLiteNode*)
- tflite::(anonymous namespace)::Init(TfLiteContext*, char const*, unsigned int)
- tflite::(anonymous namespace)::Prepare(TfLiteContext*, TfLiteNode*)
- tflite::(anonymous namespace)::EvalQuantizedPerChannel16x8(TfLiteContext*, TfLiteNode*, TfLiteDepthwiseConvParams const&, tflite::(anonymous namespace)::OpData const&, TfLiteEvalTensor const*, TfLiteEvalTensor const*, TfLiteEvalTensor const*, TfLiteEvalTensor*) (.constprop.0)
- tflite::(anonymous namespace)::EvalQuantizedPerChannel(TfLiteContext*, TfLiteNode*, TfLiteDepthwiseConvParams const&, tflite::(anonymous namespace)::OpData const&, TfLiteEvalTensor const*, TfLiteEvalTensor const*, TfLiteEvalTensor const*, TfLiteEvalTensor*) (.constprop.0)
- tflite::(anonymous namespace)::Eval(TfLiteContext*, TfLiteNode*)
- tflite::(anonymous namespace)::Init(TfLiteContext*, char const*, unsigned int)
- tflite::(anonymous namespace)::Eval(TfLiteContext*, TfLiteNode*)
- tflite::(anonymous namespace)::Init(TfLiteContext*, char const*, unsigned int)
- tflite::(anonymous namespace)::MaxPrepare(TfLiteContext*, TfLiteNode*)
- tflite::(anonymous namespace)::MaxEvalQuantized(TfLiteContext*, TfLiteNode const*, TfLitePoolParams const*, tflite::(anonymous namespace)::OpData const&, TfLiteEvalTensor const*, TfLiteEvalTensor*) (.constprop.0.isra.0)
- tflite::(anonymous namespace)::MaxEval(TfLiteContext*, TfLiteNode*)
- tflite::(anonymous namespace)::Init(TfLiteContext*, char const*, unsigned int)
- tflite::(anonymous namespace)::Prepare(TfLiteContext*, TfLiteNode*)
- tflite::(anonymous namespace)::Eval(TfLiteContext*, TfLiteNode*)
- tflite::(anonymous namespace)::Prepare(TfLiteContext*, TfLiteNode*)
- tflite::(anonymous namespace)::Eval(TfLiteContext*, TfLiteNode*)
- tflite::(anonymous namespace)::Init(TfLiteContext*, char const*, unsigned int)
- tflite::(anonymous namespace)::SoftmaxEval(TfLiteContext*, TfLiteNode*)
- tflite::(anonymous namespace)::Prepare(TfLiteContext*, TfLiteNode*)
- tflite::(anonymous namespace)::OpNameFromRegistration(TFLMRegistration const*)
- .LTHUNK3
- .LTHUNK2
- tflite::(anonymous namespace)::Quantize(TfLiteContext*, float, long, float, long&)
- tflite::CalculateSoftmaxParams(TfLiteContext*, TfLiteTensor const*, TfLiteTensor*, TfLiteSoftmaxParams const*, tflite::SoftmaxParams*) (.part.0)
- tflite::(anonymous namespace)::InitializeLutForInt16(TfLiteContext*, TfLiteTensor const*, TfLiteTensor*, tflite::SoftmaxParams*)

### Mutually Recursive functions

- std::__2::__forward_list_node⟨yolo::image::Detection, void*⟩* std::__2::forward_list⟨yolo::image::Detection, std::__2::allocator⟨yolo::image::Detection⟩⟩::__sort⟨yolo::DetectorPostProcess::GetNetworkBoxes(yolo::object_detection::Network&, int, int, float, std::__2::forward_list⟨yolo::image::Detection, std::__2::allocator⟨yolo::image::Detection⟩⟩&)::$_1⟩(std::__2::__forward_list_node⟨yolo::image::Detection, void*⟩*, int, yolo::DetectorPostProcess::GetNetworkBoxes(yolo::object_detection::Network&, int, int, float, std::__2::forward_list⟨yolo::image::Detection, std::__2::allocator⟨yolo::image::Detection⟩⟩&)::$_1&) ⇒ std::__2::__forward_list_node⟨yolo::image::Detection, void*⟩* std::__2::forward_list⟨yolo::image::Detection, std::__2::allocator⟨yolo::image::Detection⟩⟩::__sort⟨yolo::DetectorPostProcess::GetNetworkBoxes(yolo::object_detection::Network&, int, int, float, std::__2::forward_list⟨yolo::image::Detection, std::__2::allocator⟨yolo::image::Detection⟩⟩&)::$_1⟩(std::__2::__forward_list_node⟨yolo::image::Detection, void*⟩*, int, yolo::DetectorPostProcess::GetNetworkBoxes(yolo::object_detection::Network&, int, int, float, std::__2::forward_list⟨yolo::image::Detection, std::__2::allocator⟨yolo::image::Detection⟩⟩&)::$_1&)
- std::__2::__forward_list_node⟨yolo::image::Detection, void*⟩* std::__2::forward_list⟨yolo::image::Detection, std::__2::allocator⟨yolo::image::Detection⟩⟩::__sort⟨yolo::image::CalculateNMS(std::__2::forward_list⟨yolo::image::Detection, std::__2::allocator⟨yolo::image::Detection⟩⟩&, int, float)::$_0⟩(std::__2::__forward_list_node⟨yolo::image::Detection, void*⟩*, int, yolo::image::CalculateNMS(std::__2::forward_list⟨yolo::image::Detection, std::__2::allocator⟨yolo::image::Detection⟩⟩&, int, float)::$_0&) ⇒ std::__2::__forward_list_node⟨yolo::image::Detection, void*⟩* std::__2::forward_list⟨yolo::image::Detection, std::__2::allocator⟨yolo::image::Detection⟩⟩::__sort⟨yolo::image::CalculateNMS(std::__2::forward_list⟨yolo::image::Detection, std::__2::allocator⟨yolo::image::Detection⟩⟩&, int, float)::$_0⟩(std::__2::__forward_list_node⟨yolo::image::Detection, void*⟩*, int, yolo::image::CalculateNMS(std::__2::forward_list⟨yolo::image::Detection, std::__2::allocator⟨yolo::image::Detection⟩⟩&, int, float)::$_0&)
- tflite::AllocationInfoBuilder::MarkSubgraphLifetimesIfNecessary(tflite::Operator const*, tflite::internal::ScratchBufferRequest*, tflite::ScratchBufferHandle*, tflite::SubgraphAllocations*) ⇒ tflite::AllocationInfoBuilder::MarkAllocationLifetimes(int, tflite::internal::ScratchBufferRequest*, tflite::ScratchBufferHandle*, tflite::SubgraphAllocations*)
- void tflite::reference_ops::BroadcastAddRecursiveDimensions⟨long⟩(int, unsigned int*, unsigned int*, unsigned int*, unsigned int*, unsigned int*, unsigned int*, long, long, long const*, long const*, long*) ⇒ void tflite::reference_ops::BroadcastAddRecursiveDimensions⟨long⟩(int, unsigned int*, unsigned int*, unsigned int*, unsigned int*, unsigned int*, unsigned int*, long, long, long const*, long const*, long*)
- void tflite::reference_ops::BroadcastAddRecursiveDimensions⟨float⟩(int, unsigned int*, unsigned int*, unsigned int*, unsigned int*, unsigned int*, unsigned int*, float, float, float const*, float const*, float*) ⇒ void tflite::reference_ops::BroadcastAddRecursiveDimensions⟨float⟩(int, unsigned int*, unsigned int*, unsigned int*, unsigned int*, unsigned int*, unsigned int*, float, float, float const*, float const*, float*)
- void tflite::reference_ops::BroadcastAddRecursiveDimensions⟨short⟩(tflite::ArithmeticParams const&, int, unsigned int*, unsigned int*, unsigned int*, unsigned int*, unsigned int*, unsigned int*, short const*, short const*, short*) ⇒ void tflite::reference_ops::BroadcastAddRecursiveDimensions⟨short⟩(tflite::ArithmeticParams const&, int, unsigned int*, unsigned int*, unsigned int*, unsigned int*, unsigned int*, unsigned int*, short const*, short const*, short*)
- void tflite::reference_integer_ops::BroadcastAddRecursiveDimensions⟨signed char⟩(tflite::ArithmeticParams const&, int, unsigned int*, unsigned int*, unsigned int*, unsigned int*, unsigned int*, unsigned int*, signed char const*, signed char const*, signed char*, void (*)(tflite::ArithmeticParams const&), signed char (*)(signed char, signed char, tflite::ArithmeticParams const&)) (.isra.0) ⇒ void tflite::reference_integer_ops::BroadcastAddRecursiveDimensions⟨signed char⟩(tflite::ArithmeticParams const&, int, unsigned int*, unsigned int*, unsigned int*, unsigned int*, unsigned int*, unsigned int*, signed char const*, signed char const*, signed char*, void (*)(tflite::ArithmeticParams const&), signed char (*)(signed char, signed char, tflite::ArithmeticParams const&)) (.isra.0)
- LPUART_Deinit ⇒ LPUART_Deinit

### Function Pointers

- ADC0_DriverIRQHandler from startup_mcxn947_cm33_core0.o(.text) referenced from startup_mcxn947_cm33_core0.o(.text)
- ADC0_IRQHandler from startup_mcxn947_cm33_core0.o(.text) referenced from startup_mcxn947_cm33_core0.o(.isr_vector)
- ADC1_DriverIRQHandler from startup_mcxn947_cm33_core0.o(.text) referenced from startup_mcxn947_cm33_core0.o(.text)
- ADC1_IRQHandler from startup_mcxn947_cm33_core0.o(.text) referenced from startup_mcxn947_cm33_core0.o(.isr_vector)
- BOARD_SDCardGetDetectStatus from sdmmc_config.o(.text.BOARD_SDCardGetDetectStatus) referenced 2 times from sdmmc_config.o(.text.BOARD_SD_Config)
- BOARD_SDCardPowerControl from sdmmc_config.o(.text.BOARD_SDCardPowerControl) referenced 2 times from sdmmc_config.o(.text.BOARD_SD_Config)
- BSP32_DriverIRQHandler from startup_mcxn947_cm33_core0.o(.text) referenced from startup_mcxn947_cm33_core0.o(.text)
- BSP32_IRQHandler from startup_mcxn947_cm33_core0.o(.text) referenced from startup_mcxn947_cm33_core0.o(.isr_vector)
- BusFault_Handler from startup_mcxn947_cm33_core0.o(.text) referenced from startup_mcxn947_cm33_core0.o(.isr_vector)
- CAN0_DriverIRQHandler from startup_mcxn947_cm33_core0.o(.text) referenced from startup_mcxn947_cm33_core0.o(.text)
- CAN0_IRQHandler from startup_mcxn947_cm33_core0.o(.text) referenced from startup_mcxn947_cm33_core0.o(.isr_vector)
- CAN1_DriverIRQHandler from startup_mcxn947_cm33_core0.o(.text) referenced from startup_mcxn947_cm33_core0.o(.text)
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
- I3C0_IRQHandler from startup_mcxn947_cm33_core0.o(.text) referenced from startup_mcxn947_cm33_core0.o(.isr_vector)
- I3C1_DriverIRQHandler from startup_mcxn947_cm33_core0.o(.text) referenced from startup_mcxn947_cm33_core0.o(.text)
- I3C1_IRQHandler from startup_mcxn947_cm33_core0.o(.text) referenced from startup_mcxn947_cm33_core0.o(.isr_vector)
- ITRC0_DriverIRQHandler from startup_mcxn947_cm33_core0.o(.text) referenced from startup_mcxn947_cm33_core0.o(.text)
- ITRC0_IRQHandler from startup_mcxn947_cm33_core0.o(.text) referenced from startup_mcxn947_cm33_core0.o(.isr_vector)
- LPSPI_MasterUserCallback from zf_device_ips200.o(.text.LPSPI_MasterUserCallback) referenced 2 times from zf_device_ips200.o(.text.ips200_init)
- LPTMR0_DriverIRQHandler from startup_mcxn947_cm33_core0.o(.text) referenced from startup_mcxn947_cm33_core0.o(.text)
- LPTMR0_IRQHandler from startup_mcxn947_cm33_core0.o(.text) referenced from startup_mcxn947_cm33_core0.o(.isr_vector)
- LPTMR1_DriverIRQHandler from startup_mcxn947_cm33_core0.o(.text) referenced from startup_mcxn947_cm33_core0.o(.text)
- LPTMR1_IRQHandler from startup_mcxn947_cm33_core0.o(.text) referenced from startup_mcxn947_cm33_core0.o(.isr_vector)
- LP_FLEXCOMM0_DriverIRQHandler from fsl_lpflexcomm.o(.text.LP_FLEXCOMM0_DriverIRQHandler) referenced from startup_mcxn947_cm33_core0.o(.text)
- LP_FLEXCOMM0_IRQHandler from startup_mcxn947_cm33_core0.o(.text) referenced from startup_mcxn947_cm33_core0.o(.isr_vector)
- LP_FLEXCOMM1_DriverIRQHandler from fsl_lpflexcomm.o(.text.LP_FLEXCOMM1_DriverIRQHandler) referenced from startup_mcxn947_cm33_core0.o(.text)
- LP_FLEXCOMM1_IRQHandler from startup_mcxn947_cm33_core0.o(.text) referenced from startup_mcxn947_cm33_core0.o(.isr_vector)
- LP_FLEXCOMM2_DriverIRQHandler from fsl_lpflexcomm.o(.text.LP_FLEXCOMM2_DriverIRQHandler) referenced from startup_mcxn947_cm33_core0.o(.text)
- LP_FLEXCOMM2_IRQHandler from startup_mcxn947_cm33_core0.o(.text) referenced from startup_mcxn947_cm33_core0.o(.isr_vector)
- LP_FLEXCOMM3_DriverIRQHandler from fsl_lpflexcomm.o(.text.LP_FLEXCOMM3_DriverIRQHandler) referenced from startup_mcxn947_cm33_core0.o(.text)
- LP_FLEXCOMM3_IRQHandler from startup_mcxn947_cm33_core0.o(.text) referenced from startup_mcxn947_cm33_core0.o(.isr_vector)
- LP_FLEXCOMM4_DriverIRQHandler from fsl_lpflexcomm.o(.text.LP_FLEXCOMM4_DriverIRQHandler) referenced from startup_mcxn947_cm33_core0.o(.text)
- LP_FLEXCOMM4_IRQHandler from zf_board_init.o(.text.LP_FLEXCOMM4_IRQHandler) referenced from startup_mcxn947_cm33_core0.o(.isr_vector)
- LP_FLEXCOMM5_DriverIRQHandler from fsl_lpflexcomm.o(.text.LP_FLEXCOMM5_DriverIRQHandler) referenced from startup_mcxn947_cm33_core0.o(.text)
- LP_FLEXCOMM5_IRQHandler from zf_driver_uart.o(.text.LP_FLEXCOMM5_IRQHandler) referenced from startup_mcxn947_cm33_core0.o(.isr_vector)
- LP_FLEXCOMM6_DriverIRQHandler from fsl_lpflexcomm.o(.text.LP_FLEXCOMM6_DriverIRQHandler) referenced from startup_mcxn947_cm33_core0.o(.text)
- LP_FLEXCOMM6_IRQHandler from startup_mcxn947_cm33_core0.o(.text) referenced from startup_mcxn947_cm33_core0.o(.isr_vector)
- LP_FLEXCOMM7_DriverIRQHandler from fsl_lpflexcomm.o(.text.LP_FLEXCOMM7_DriverIRQHandler) referenced from startup_mcxn947_cm33_core0.o(.text)
- LP_FLEXCOMM7_IRQHandler from startup_mcxn947_cm33_core0.o(.text) referenced from startup_mcxn947_cm33_core0.o(.isr_vector)
- LP_FLEXCOMM8_DriverIRQHandler from fsl_lpflexcomm.o(.text.LP_FLEXCOMM8_DriverIRQHandler) referenced from startup_mcxn947_cm33_core0.o(.text)
- LP_FLEXCOMM8_IRQHandler from startup_mcxn947_cm33_core0.o(.text) referenced from startup_mcxn947_cm33_core0.o(.isr_vector)
- LP_FLEXCOMM9_DriverIRQHandler from fsl_lpflexcomm.o(.text.LP_FLEXCOMM9_DriverIRQHandler) referenced from startup_mcxn947_cm33_core0.o(.text)
- LP_FLEXCOMM9_IRQHandler from startup_mcxn947_cm33_core0.o(.text) referenced from startup_mcxn947_cm33_core0.o(.isr_vector)
- MAILBOX_DriverIRQHandler from startup_mcxn947_cm33_core0.o(.text) referenced from startup_mcxn947_cm33_core0.o(.text)
- MAILBOX_IRQHandler from startup_mcxn947_cm33_core0.o(.text) referenced from startup_mcxn947_cm33_core0.o(.isr_vector)
- MRT0_DriverIRQHandler from startup_mcxn947_cm33_core0.o(.text) referenced from startup_mcxn947_cm33_core0.o(.text)
- MRT0_IRQHandler from startup_mcxn947_cm33_core0.o(.text) referenced from startup_mcxn947_cm33_core0.o(.isr_vector)
- MemManage_Handler from startup_mcxn947_cm33_core0.o(.text) referenced from startup_mcxn947_cm33_core0.o(.isr_vector)
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
- WUU_DriverIRQHandler from startup_mcxn947_cm33_core0.o(.text) referenced from startup_mcxn947_cm33_core0.o(.text)
- WUU_IRQHandler from startup_mcxn947_cm33_core0.o(.text) referenced from startup_mcxn947_cm33_core0.o(.isr_vector)
- WWDT0_DriverIRQHandler from startup_mcxn947_cm33_core0.o(.text) referenced from startup_mcxn947_cm33_core0.o(.text)
- WWDT0_IRQHandler from startup_mcxn947_cm33_core0.o(.text) referenced from startup_mcxn947_cm33_core0.o(.isr_vector)
- WWDT1_DriverIRQHandler from startup_mcxn947_cm33_core0.o(.text) referenced from startup_mcxn947_cm33_core0.o(.text)
- WWDT1_IRQHandler from startup_mcxn947_cm33_core0.o(.text) referenced from startup_mcxn947_cm33_core0.o(.isr_vector)
- _GLOBAL__sub_I_zf_model_process.cpp from zf_model_process.o(.text._GLOBAL__sub_I_zf_model_process.cpp) referenced from zf_model_process.o(.init_array)
- yolo::DetectorPostProcess::DoPostProcess() from yolo_post_processing.o(.text._ZN4yolo19DetectorPostProcess13DoPostProcessEv) referenced from yolo_post_processing.o(.rodata._ZTVN4yolo19DetectorPostProcessE)
- yolo::DetectorPostProcess::~DetectorPostProcess__deallocating() from yolo_post_processing.o(.text._ZN4yolo19DetectorPostProcessD0Ev) referenced from yolo_post_processing.o(.rodata._ZTVN4yolo19DetectorPostProcessE)
- yolo::DetectorPostProcess::~DetectorPostProcess__sub_object() from yolo_post_processing.o(.text._ZN4yolo19DetectorPostProcessD2Ev) referenced from yolo_post_processing.o(.rodata._ZTVN4yolo19DetectorPostProcessE)
- tflite::PadPrepare(TfLiteContext*, TfLiteNode*) from pad.o(.text._ZN6tflite10PadPrepareEP13TfLiteContextP10TfLiteNode) referenced from pad.o(.text._ZN6tflite12Register_PADEv)
- tflite::ParseSlice(tflite::Operator const*, tflite::ErrorReporter*, tflite::BuiltinDataAllocator*, void**) from flatbuffer_conversions.o(.text._ZN6tflite10ParseSliceEPKNS_8OperatorEPNS_13ErrorReporterEPNS_20BuiltinDataAllocatorEPPv) referenced 2 times from model_ops_npu.o(.text._Z20MODEL_GetOpsResolverv)
- tflite::PrepareAdd(TfLiteContext*, TfLiteNode*) from add.o(.text._ZN6tflite10PrepareAddEP13TfLiteContextP10TfLiteNode) referenced from add.o(.text._ZN6tflite12Register_ADDEv)
- tflite::ParseConv2D(tflite::Operator const*, tflite::ErrorReporter*, tflite::BuiltinDataAllocator*, void**) from flatbuffer_conversions.o(.text._ZN6tflite11ParseConv2DEPKNS_8OperatorEPNS_13ErrorReporterEPNS_20BuiltinDataAllocatorEPPv) referenced 2 times from model_ops_npu.o(.text._Z20MODEL_GetOpsResolverv)
- tflite::ParseSoftmax(tflite::Operator const*, tflite::ErrorReporter*, tflite::BuiltinDataAllocator*, void**) from flatbuffer_conversions.o(.text._ZN6tflite12ParseSoftmaxEPKNS_8OperatorEPNS_13ErrorReporterEPNS_20BuiltinDataAllocatorEPPv) referenced 2 times from model_ops_npu.o(.text._Z20MODEL_GetOpsResolverv)
- tflite::(anonymous namespace)::MaxPrepare(TfLiteContext*, TfLiteNode*) from pooling.o(.text._ZN6tflite12_GLOBAL__N_110MaxPrepareEP13TfLiteContextP10TfLiteNode) referenced from pooling.o(.text._ZN6tflite20Register_MAX_POOL_2DEv)
- tflite::(anonymous namespace)::SoftmaxEval(TfLiteContext*, TfLiteNode*) from softmax.o(.text._ZN6tflite12_GLOBAL__N_111SoftmaxEvalEP13TfLiteContextP10TfLiteNode) referenced from softmax.o(.text._ZN6tflite16Register_SOFTMAXEv)
- tflite::(anonymous namespace)::MicroBuiltinDataAllocator::Deallocate(void*) from micro_allocator.o(.text._ZN6tflite12_GLOBAL__N_125MicroBuiltinDataAllocator10DeallocateEPv) referenced from micro_allocator.o(.rodata._ZTVN6tflite12_GLOBAL__N_125MicroBuiltinDataAllocatorE)
- tflite::(anonymous namespace)::MicroBuiltinDataAllocator::Allocate(unsigned int, unsigned int) from micro_allocator.o(.text._ZN6tflite12_GLOBAL__N_125MicroBuiltinDataAllocator8AllocateEjj) referenced from micro_allocator.o(.rodata._ZTVN6tflite12_GLOBAL__N_125MicroBuiltinDataAllocatorE)
- tflite::(anonymous namespace)::MicroBuiltinDataAllocator::~MicroBuiltinDataAllocator__deallocating() from micro_allocator.o(.text._ZN6tflite12_GLOBAL__N_125MicroBuiltinDataAllocatorD0Ev) referenced from micro_allocator.o(.rodata._ZTVN6tflite12_GLOBAL__N_125MicroBuiltinDataAllocatorE)
- tflite::(anonymous namespace)::MicroBuiltinDataAllocator::~MicroBuiltinDataAllocator() from micro_allocator.o(.text._ZN6tflite12_GLOBAL__N_125MicroBuiltinDataAllocatorD0Ev) referenced from micro_allocator.o(.rodata._ZTVN6tflite12_GLOBAL__N_125MicroBuiltinDataAllocatorE)
- tflite::(anonymous namespace)::Eval(TfLiteContext*, TfLiteNode*) from pad.o(.text._ZN6tflite12_GLOBAL__N_14EvalEP13TfLiteContextP10TfLiteNode) referenced from pad.o(.text._ZN6tflite12Register_PADEv)
- tflite::(anonymous namespace)::Eval(TfLiteContext*, TfLiteNode*) from slice.o(.text._ZN6tflite12_GLOBAL__N_14EvalEP13TfLiteContextP10TfLiteNode) referenced from slice.o(.text._ZN6tflite14Register_SLICEEv)
- tflite::(anonymous namespace)::Eval(TfLiteContext*, TfLiteNode*) from conv.o(.text._ZN6tflite12_GLOBAL__N_14EvalEP13TfLiteContextP10TfLiteNode) referenced from conv.o(.text._ZN6tflite16Register_CONV_2DEv)
- tflite::(anonymous namespace)::Eval(TfLiteContext*, TfLiteNode*) from concatenation.o(.text._ZN6tflite12_GLOBAL__N_14EvalEP13TfLiteContextP10TfLiteNode) referenced from concatenation.o(.text._ZN6tflite22Register_CONCATENATIONEv)
- tflite::(anonymous namespace)::Eval(TfLiteContext*, TfLiteNode*) from neutron.o(.text._ZN6tflite12_GLOBAL__N_14EvalEP13TfLiteContextP10TfLiteNode) referenced 2 times from neutron.o(.text._ZN6tflite22Register_NEUTRON_GRAPHEv)
- tflite::(anonymous namespace)::Eval(TfLiteContext*, TfLiteNode*) from depthwise_conv.o(.text._ZN6tflite12_GLOBAL__N_14EvalEP13TfLiteContextP10TfLiteNode) referenced from depthwise_conv.o(.text._ZN6tflite26Register_DEPTHWISE_CONV_2DEv)
- tflite::(anonymous namespace)::Eval(TfLiteContext*, TfLiteNode*) from resize_nearest_neighbor.o(.text._ZN6tflite12_GLOBAL__N_14EvalEP13TfLiteContextP10TfLiteNode) referenced from resize_nearest_neighbor.o(.text._ZN6tflite32Register_RESIZE_NEAREST_NEIGHBOREv)
- tflite::(anonymous namespace)::Free(TfLiteContext*, void*) from neutron.o(.text._ZN6tflite12_GLOBAL__N_14FreeEP13TfLiteContextPv) referenced 2 times from neutron.o(.text._ZN6tflite22Register_NEUTRON_GRAPHEv)
- tflite::(anonymous namespace)::Init(TfLiteContext*, char const*, unsigned int) from pad.o(.text._ZN6tflite12_GLOBAL__N_14InitEP13TfLiteContextPKcj) referenced from pad.o(.text._ZN6tflite12Register_PADEv)
- tflite::(anonymous namespace)::Init(TfLiteContext*, char const*, unsigned int) from conv.o(.text._ZN6tflite12_GLOBAL__N_14InitEP13TfLiteContextPKcj) referenced from conv.o(.text._ZN6tflite16Register_CONV_2DEv)
- tflite::(anonymous namespace)::Init(TfLiteContext*, char const*, unsigned int) from softmax.o(.text._ZN6tflite12_GLOBAL__N_14InitEP13TfLiteContextPKcj) referenced from softmax.o(.text._ZN6tflite16Register_SOFTMAXEv)
- tflite::(anonymous namespace)::Init(TfLiteContext*, char const*, unsigned int) from quantize.o(.text._ZN6tflite12_GLOBAL__N_14InitEP13TfLiteContextPKcj) referenced from quantize.o(.text._ZN6tflite17Register_QUANTIZEEv)
- tflite::(anonymous namespace)::Init(TfLiteContext*, char const*, unsigned int) from pooling.o(.text._ZN6tflite12_GLOBAL__N_14InitEP13TfLiteContextPKcj) referenced from pooling.o(.text._ZN6tflite20Register_MAX_POOL_2DEv)
- tflite::(anonymous namespace)::Init(TfLiteContext*, char const*, unsigned int) from concatenation.o(.text._ZN6tflite12_GLOBAL__N_14InitEP13TfLiteContextPKcj) referenced from concatenation.o(.text._ZN6tflite22Register_CONCATENATIONEv)
- tflite::(anonymous namespace)::Init(TfLiteContext*, char const*, unsigned int) from neutron.o(.text._ZN6tflite12_GLOBAL__N_14InitEP13TfLiteContextPKcj) referenced 2 times from neutron.o(.text._ZN6tflite22Register_NEUTRON_GRAPHEv)
- tflite::(anonymous namespace)::Init(TfLiteContext*, char const*, unsigned int) from depthwise_conv.o(.text._ZN6tflite12_GLOBAL__N_14InitEP13TfLiteContextPKcj) referenced from depthwise_conv.o(.text._ZN6tflite26Register_DEPTHWISE_CONV_2DEv)
- tflite::(anonymous namespace)::MaxEval(TfLiteContext*, TfLiteNode*) from pooling.o(.text._ZN6tflite12_GLOBAL__N_17MaxEvalEP13TfLiteContextP10TfLiteNode) referenced from pooling.o(.text._ZN6tflite20Register_MAX_POOL_2DEv)
- tflite::(anonymous namespace)::Prepare(TfLiteContext*, TfLiteNode*) from slice.o(.text._ZN6tflite12_GLOBAL__N_17PrepareEP13TfLiteContextP10TfLiteNode) referenced from slice.o(.text._ZN6tflite14Register_SLICEEv)
- tflite::(anonymous namespace)::Prepare(TfLiteContext*, TfLiteNode*) from conv.o(.text._ZN6tflite12_GLOBAL__N_17PrepareEP13TfLiteContextP10TfLiteNode) referenced from conv.o(.text._ZN6tflite16Register_CONV_2DEv)
- tflite::(anonymous namespace)::Prepare(TfLiteContext*, TfLiteNode*) from softmax.o(.text._ZN6tflite12_GLOBAL__N_17PrepareEP13TfLiteContextP10TfLiteNode) referenced from softmax.o(.text._ZN6tflite16Register_SOFTMAXEv)
- tflite::(anonymous namespace)::Prepare(TfLiteContext*, TfLiteNode*) from concatenation.o(.text._ZN6tflite12_GLOBAL__N_17PrepareEP13TfLiteContextP10TfLiteNode) referenced from concatenation.o(.text._ZN6tflite22Register_CONCATENATIONEv)
- tflite::(anonymous namespace)::Prepare(TfLiteContext*, TfLiteNode*) from neutron.o(.text._ZN6tflite12_GLOBAL__N_17PrepareEP13TfLiteContextP10TfLiteNode) referenced 2 times from neutron.o(.text._ZN6tflite22Register_NEUTRON_GRAPHEv)
- tflite::(anonymous namespace)::Prepare(TfLiteContext*, TfLiteNode*) from depthwise_conv.o(.text._ZN6tflite12_GLOBAL__N_17PrepareEP13TfLiteContextP10TfLiteNode) referenced from depthwise_conv.o(.text._ZN6tflite26Register_DEPTHWISE_CONV_2DEv)
- tflite::(anonymous namespace)::Prepare(TfLiteContext*, TfLiteNode*) from resize_nearest_neighbor.o(.text._ZN6tflite12_GLOBAL__N_17PrepareEP13TfLiteContextP10TfLiteNode) referenced from resize_nearest_neighbor.o(.text._ZN6tflite32Register_RESIZE_NEAREST_NEIGHBOREv)
- tflite::ParseQuantize(tflite::Operator const*, tflite::ErrorReporter*, tflite::BuiltinDataAllocator*, void**) from flatbuffer_conversions.o(.text._ZN6tflite13ParseQuantizeEPKNS_8OperatorEPNS_13ErrorReporterEPNS_20BuiltinDataAllocatorEPPv) referenced 2 times from model_ops_npu.o(.text._Z20MODEL_GetOpsResolverv)
- tflite::DequantizeEval(TfLiteContext*, TfLiteNode*) from dequantize.o(.text._ZN6tflite14DequantizeEvalEP13TfLiteContextP10TfLiteNode) referenced from dequantize.o(.text._ZN6tflite19Register_DEQUANTIZEEv)
- tflite::DequantizeInit(TfLiteContext*, char const*, unsigned int) from dequantize.o(.text._ZN6tflite14DequantizeInitEP13TfLiteContextPKcj) referenced from dequantize.o(.text._ZN6tflite19Register_DEQUANTIZEEv)
- tflite::MicroAllocator::AllocateVariables(tflite::SubGraph const*, TfLiteEvalTensor*, long const*) from micro_allocator.o(.text._ZN6tflite14MicroAllocator17AllocateVariablesEPKNS_8SubGraphEP16TfLiteEvalTensorPKl) referenced from micro_allocator.o(.rodata._ZTVN6tflite14MicroAllocatorE)
- tflite::MicroAllocator::AllocateTempBuffer(unsigned int, unsigned int) from micro_allocator.o(.text._ZN6tflite14MicroAllocator18AllocateTempBufferEjj) referenced from micro_allocator.o(.rodata._ZTVN6tflite14MicroAllocatorE)
- tflite::MicroAllocator::DeallocateTempBuffer(unsigned char*) from micro_allocator.o(.text._ZN6tflite14MicroAllocator20DeallocateTempBufferEPh) referenced from micro_allocator.o(.rodata._ZTVN6tflite14MicroAllocatorE)
- tflite::MicroAllocator::IsAllTempDeallocated() from micro_allocator.o(.text._ZN6tflite14MicroAllocator20IsAllTempDeallocatedEv) referenced from micro_allocator.o(.rodata._ZTVN6tflite14MicroAllocatorE)
- tflite::MicroAllocator::ResetTempAllocations() from micro_allocator.o(.text._ZN6tflite14MicroAllocator20ResetTempAllocationsEv) referenced from micro_allocator.o(.rodata._ZTVN6tflite14MicroAllocatorE)
- tflite::MicroAllocator::CommitStaticMemoryPlan(tflite::Model const*, tflite::SubgraphAllocations*, tflite::ScratchBufferHandle*) from micro_allocator.o(.text._ZN6tflite14MicroAllocator22CommitStaticMemoryPlanEPKNS_5ModelEPNS_19SubgraphAllocationsEPNS_19ScratchBufferHandleE) referenced from micro_allocator.o(.rodata._ZTVN6tflite14MicroAllocatorE)
- tflite::MicroAllocator::AllocatePersistentBuffer(unsigned int) from micro_allocator.o(.text._ZN6tflite14MicroAllocator24AllocatePersistentBufferEj) referenced from micro_allocator.o(.rodata._ZTVN6tflite14MicroAllocatorE)
- tflite::MicroAllocator::AllocateTempTfLiteTensor(tflite::Model const*, tflite::SubgraphAllocations const*, int, int) from micro_allocator.o(.text._ZN6tflite14MicroAllocator24AllocateTempTfLiteTensorEPKNS_5ModelEPKNS_19SubgraphAllocationsEii) referenced from micro_allocator.o(.rodata._ZTVN6tflite14MicroAllocatorE)
- tflite::MicroAllocator::AllocateTfLiteEvalTensors(tflite::Model const*, tflite::SubgraphAllocations*) from micro_allocator.o(.text._ZN6tflite14MicroAllocator25AllocateTfLiteEvalTensorsEPKNS_5ModelEPNS_19SubgraphAllocationsE) referenced from micro_allocator.o(.rodata._ZTVN6tflite14MicroAllocatorE)
- tflite::MicroAllocator::DeallocateTempTfLiteTensor(TfLiteTensor*) from micro_allocator.o(.text._ZN6tflite14MicroAllocator26DeallocateTempTfLiteTensorEP12TfLiteTensor) referenced from micro_allocator.o(.rodata._ZTVN6tflite14MicroAllocatorE)
- tflite::MicroAllocator::AllocateNodeAndRegistrations(tflite::Model const*, tflite::SubgraphAllocations*) from micro_allocator.o(.text._ZN6tflite14MicroAllocator28AllocateNodeAndRegistrationsEPKNS_5ModelEPNS_19SubgraphAllocationsE) referenced from micro_allocator.o(.rodata._ZTVN6tflite14MicroAllocatorE)
- tflite::MicroAllocator::AllocateScratchBufferHandles(tflite::ScratchBufferHandle**, unsigned int) from micro_allocator.o(.text._ZN6tflite14MicroAllocator28AllocateScratchBufferHandlesEPPNS_19ScratchBufferHandleEj) referenced from micro_allocator.o(.rodata._ZTVN6tflite14MicroAllocatorE)
- tflite::MicroAllocator::AllocatePersistentTfLiteTensor(tflite::Model const*, tflite::SubgraphAllocations const*, int, int) from micro_allocator.o(.text._ZN6tflite14MicroAllocator30AllocatePersistentTfLiteTensorEPKNS_5ModelEPKNS_19SubgraphAllocationsEii) referenced from micro_allocator.o(.rodata._ZTVN6tflite14MicroAllocatorE)
- tflite::MicroAllocator::PopulateTfLiteTensorFromFlatbuffer(tflite::Model const*, TfLiteTensor*, int, int, bool) from micro_allocator.o(.text._ZN6tflite14MicroAllocator34PopulateTfLiteTensorFromFlatbufferEPKNS_5ModelEP12TfLiteTensoriib) referenced from micro_allocator.o(.rodata._ZTVN6tflite14MicroAllocatorE)
- tflite::MicroAllocator::AllocatePersistentTfLiteTensorInternal() from micro_allocator.o(.text._ZN6tflite14MicroAllocator38AllocatePersistentTfLiteTensorInternalEv) referenced from micro_allocator.o(.rodata._ZTVN6tflite14MicroAllocatorE)
- tflite::MicroAllocator::~MicroAllocator__deallocating() from micro_allocator.o(.text._ZN6tflite14MicroAllocatorD0Ev) referenced from micro_allocator.o(.rodata._ZTVN6tflite14MicroAllocatorE)
- tflite::MicroAllocator::~MicroAllocator() from micro_allocator.o(.text._ZN6tflite14MicroAllocatorD0Ev) referenced from micro_allocator.o(.rodata._ZTVN6tflite14MicroAllocatorE)
- tflite::MicroOpResolver::~MicroOpResolver__sub_object() from model_ops_npu.o(.text._ZN6tflite15MicroOpResolverD2Ev) referenced from model_ops_npu.o(.rodata._ZTVN6tflite22MicroMutableOpResolverILj12EEE)
- tflite::MicroOpResolver::~MicroOpResolver__sub_object() from model_ops_npu.o(.text._ZN6tflite15MicroOpResolverD2Ev) referenced 2 times from model_ops_npu.o(.text._Z20MODEL_GetOpsResolverv)
- tflite::ParseDequantize(tflite::Operator const*, tflite::ErrorReporter*, tflite::BuiltinDataAllocator*, void**) from flatbuffer_conversions.o(.text._ZN6tflite15ParseDequantizeEPKNS_8OperatorEPNS_13ErrorReporterEPNS_20BuiltinDataAllocatorEPPv) referenced 2 times from model_ops_npu.o(.text._Z20MODEL_GetOpsResolverv)
- tflite::MicroInterpreter::~MicroInterpreter() from micro_interpreter.o(.text._ZN6tflite16MicroInterpreterD2Ev) referenced 2 times from model.o(.text.MODEL_Init)
- tflite::DequantizePrepare(TfLiteContext*, TfLiteNode*) from dequantize_common.o(.text._ZN6tflite17DequantizePrepareEP13TfLiteContextP10TfLiteNode) referenced from dequantize.o(.text._ZN6tflite19Register_DEQUANTIZEEv)
- tflite::MicroErrorReporter::Report(char const*, std::__va_list) from micro_error_reporter.o(.text._ZN6tflite18MicroErrorReporter6ReportEPKcSt9__va_list) referenced from micro_error_reporter.o(.rodata._ZTVN6tflite18MicroErrorReporterE)
- tflite::MicroErrorReporter::~MicroErrorReporter__deallocating() from micro_error_reporter.o(.text._ZN6tflite18MicroErrorReporterD0Ev) referenced from micro_error_reporter.o(.rodata._ZTVN6tflite18MicroErrorReporterE)
- tflite::MicroErrorReporter::~MicroErrorReporter() from micro_error_reporter.o(.text._ZN6tflite18MicroErrorReporterD0Ev) referenced from micro_error_reporter.o(.rodata._ZTVN6tflite18MicroErrorReporterE)
- tflite::MicroMemoryPlanner::PrintMemoryPlan() from linear_memory_planner.o(.text._ZN6tflite18MicroMemoryPlanner15PrintMemoryPlanEv) referenced from linear_memory_planner.o(.rodata._ZTVN6tflite19LinearMemoryPlannerE)
- tflite::MicroMemoryPlanner::Init(unsigned char*, int) from linear_memory_planner.o(.text._ZN6tflite18MicroMemoryPlanner4InitEPhi) referenced from linear_memory_planner.o(.rodata._ZTVN6tflite19LinearMemoryPlannerE)
- tflite::MicroMemoryPlanner::AddBuffer(int, int, int, int) from linear_memory_planner.o(.text._ZN6tflite18MicroMemoryPlanner9AddBufferEiiii) referenced from linear_memory_planner.o(.rodata._ZTVN6tflite19LinearMemoryPlannerE)
- tflite::ParseConcatenation(tflite::Operator const*, tflite::ErrorReporter*, tflite::BuiltinDataAllocator*, void**) from flatbuffer_conversions.o(.text._ZN6tflite18ParseConcatenationEPKNS_8OperatorEPNS_13ErrorReporterEPNS_20BuiltinDataAllocatorEPPv) referenced 2 times from model_ops_npu.o(.text._Z20MODEL_GetOpsResolverv)
- tflite::GreedyMemoryPlanner::GetBufferCount() from greedy_memory_planner.o(.text._ZN6tflite19GreedyMemoryPlanner14GetBufferCountEv) referenced from greedy_memory_planner.o(.rodata._ZTVN6tflite19GreedyMemoryPlannerE)
- tflite::GreedyMemoryPlanner::PrintMemoryPlan() from greedy_memory_planner.o(.text._ZN6tflite19GreedyMemoryPlanner15PrintMemoryPlanEv) referenced from greedy_memory_planner.o(.rodata._ZTVN6tflite19GreedyMemoryPlannerE)
- tflite::GreedyMemoryPlanner::GetOffsetForBuffer(int, int*) from greedy_memory_planner.o(.text._ZN6tflite19GreedyMemoryPlanner18GetOffsetForBufferEiPi) referenced from greedy_memory_planner.o(.rodata._ZTVN6tflite19GreedyMemoryPlannerE)
- tflite::GreedyMemoryPlanner::GetMaximumMemorySize() from greedy_memory_planner.o(.text._ZN6tflite19GreedyMemoryPlanner20GetMaximumMemorySizeEv) referenced from greedy_memory_planner.o(.rodata._ZTVN6tflite19GreedyMemoryPlannerE)
- tflite::GreedyMemoryPlanner::Init(unsigned char*, int) from greedy_memory_planner.o(.text._ZN6tflite19GreedyMemoryPlanner4InitEPhi) referenced from greedy_memory_planner.o(.rodata._ZTVN6tflite19GreedyMemoryPlannerE)
- tflite::GreedyMemoryPlanner::AddBuffer(int, int, int) from greedy_memory_planner.o(.text._ZN6tflite19GreedyMemoryPlanner9AddBufferEiii) referenced from greedy_memory_planner.o(.rodata._ZTVN6tflite19GreedyMemoryPlannerE)
- tflite::GreedyMemoryPlanner::AddBuffer(int, int, int, int) from greedy_memory_planner.o(.text._ZN6tflite19GreedyMemoryPlanner9AddBufferEiiii) referenced from greedy_memory_planner.o(.rodata._ZTVN6tflite19GreedyMemoryPlannerE)
- tflite::GreedyMemoryPlanner::~GreedyMemoryPlanner__deallocating() from greedy_memory_planner.o(.text._ZN6tflite19GreedyMemoryPlannerD0Ev) referenced from greedy_memory_planner.o(.rodata._ZTVN6tflite19GreedyMemoryPlannerE)
- tflite::GreedyMemoryPlanner::~GreedyMemoryPlanner() from greedy_memory_planner.o(.text._ZN6tflite19GreedyMemoryPlannerD0Ev) referenced from greedy_memory_planner.o(.rodata._ZTVN6tflite19GreedyMemoryPlannerE)
- tflite::LinearMemoryPlanner::GetBufferCount() from linear_memory_planner.o(.text._ZN6tflite19LinearMemoryPlanner14GetBufferCountEv) referenced from linear_memory_planner.o(.rodata._ZTVN6tflite19LinearMemoryPlannerE)
- tflite::LinearMemoryPlanner::GetOffsetForBuffer(int, int*) from linear_memory_planner.o(.text._ZN6tflite19LinearMemoryPlanner18GetOffsetForBufferEiPi) referenced from linear_memory_planner.o(.rodata._ZTVN6tflite19LinearMemoryPlannerE)
- tflite::LinearMemoryPlanner::GetMaximumMemorySize() from linear_memory_planner.o(.text._ZN6tflite19LinearMemoryPlanner20GetMaximumMemorySizeEv) referenced from linear_memory_planner.o(.rodata._ZTVN6tflite19LinearMemoryPlannerE)
- tflite::LinearMemoryPlanner::AddBuffer(int, int, int) from linear_memory_planner.o(.text._ZN6tflite19LinearMemoryPlanner9AddBufferEiii) referenced from linear_memory_planner.o(.rodata._ZTVN6tflite19LinearMemoryPlannerE)
- tflite::LinearMemoryPlanner::~LinearMemoryPlanner__deallocating() from linear_memory_planner.o(.text._ZN6tflite19LinearMemoryPlannerD0Ev) referenced from linear_memory_planner.o(.rodata._ZTVN6tflite19LinearMemoryPlannerE)
- tflite::LinearMemoryPlanner::~LinearMemoryPlanner() from linear_memory_planner.o(.text._ZN6tflite19LinearMemoryPlannerD0Ev) referenced from linear_memory_planner.o(.rodata._ZTVN6tflite19LinearMemoryPlannerE)
- tflite::ParseDepthwiseConv2D(tflite::Operator const*, tflite::ErrorReporter*, tflite::BuiltinDataAllocator*, void**) from flatbuffer_conversions.o(.text._ZN6tflite20ParseDepthwiseConv2DEPKNS_8OperatorEPNS_13ErrorReporterEPNS_20BuiltinDataAllocatorEPPv) referenced 2 times from model_ops_npu.o(.text._Z20MODEL_GetOpsResolverv)
- tflite::EvalQuantizeReference(TfLiteContext*, TfLiteNode*) from quantize_common.o(.text._ZN6tflite21EvalQuantizeReferenceEP13TfLiteContextP10TfLiteNode) referenced from quantize.o(.text._ZN6tflite17Register_QUANTIZEEv)
- tflite::MicroContextGetTensor(TfLiteContext const*, int) from micro_interpreter.o(.text._ZN6tflite21MicroContextGetTensorEPK13TfLiteContexti) referenced from micro_interpreter.o(.text._ZN6tflite16MicroInterpreter4InitEPNS_22MicroProfilerInterfaceE)
- tflite::MicroInterpreterGraph::NumSubgraphs() from micro_interpreter_graph.o(.text._ZN6tflite21MicroInterpreterGraph12NumSubgraphsEv) referenced from micro_interpreter_graph.o(.rodata._ZTVN6tflite21MicroInterpreterGraphE)
- tflite::MicroInterpreterGraph::FreeSubgraphs() from micro_interpreter_graph.o(.text._ZN6tflite21MicroInterpreterGraph13FreeSubgraphsEv) referenced from micro_interpreter_graph.o(.rodata._ZTVN6tflite21MicroInterpreterGraphE)
- tflite::MicroInterpreterGraph::InitSubgraphs() from micro_interpreter_graph.o(.text._ZN6tflite21MicroInterpreterGraph13InitSubgraphsEv) referenced from micro_interpreter_graph.o(.rodata._ZTVN6tflite21MicroInterpreterGraphE)
- tflite::MicroInterpreterGraph::InvokeSubgraph(int) from micro_interpreter_graph.o(.text._ZN6tflite21MicroInterpreterGraph14InvokeSubgraphEi) referenced from micro_interpreter_graph.o(.rodata._ZTVN6tflite21MicroInterpreterGraphE)
- tflite::MicroInterpreterGraph::ResetSubgraphs() from micro_interpreter_graph.o(.text._ZN6tflite21MicroInterpreterGraph14ResetSubgraphsEv) referenced from micro_interpreter_graph.o(.rodata._ZTVN6tflite21MicroInterpreterGraphE)
- tflite::MicroInterpreterGraph::GetSubgraphInput(int, int) from micro_interpreter_graph.o(.text._ZN6tflite21MicroInterpreterGraph16GetSubgraphInputEii) referenced from micro_interpreter_graph.o(.rodata._ZTVN6tflite21MicroInterpreterGraphE)
- tflite::MicroInterpreterGraph::PrepareSubgraphs() from micro_interpreter_graph.o(.text._ZN6tflite21MicroInterpreterGraph16PrepareSubgraphsEv) referenced from micro_interpreter_graph.o(.rodata._ZTVN6tflite21MicroInterpreterGraphE)
- tflite::MicroInterpreterGraph::GetSubgraphOutput(int, int) from micro_interpreter_graph.o(.text._ZN6tflite21MicroInterpreterGraph17GetSubgraphOutputEii) referenced from micro_interpreter_graph.o(.rodata._ZTVN6tflite21MicroInterpreterGraphE)
- tflite::MicroInterpreterGraph::NumSubgraphInputs(int) from micro_interpreter_graph.o(.text._ZN6tflite21MicroInterpreterGraph17NumSubgraphInputsEi) referenced from micro_interpreter_graph.o(.rodata._ZTVN6tflite21MicroInterpreterGraphE)
- tflite::MicroInterpreterGraph::NumSubgraphOutputs(int) from micro_interpreter_graph.o(.text._ZN6tflite21MicroInterpreterGraph18NumSubgraphOutputsEi) referenced from micro_interpreter_graph.o(.rodata._ZTVN6tflite21MicroInterpreterGraphE)
- tflite::MicroInterpreterGraph::GetResourceVariables() from micro_interpreter_graph.o(.text._ZN6tflite21MicroInterpreterGraph20GetResourceVariablesEv) referenced from micro_interpreter_graph.o(.rodata._ZTVN6tflite21MicroInterpreterGraphE)
- tflite::MicroInterpreterGraph::ResetVariableTensors() from micro_interpreter_graph.o(.text._ZN6tflite21MicroInterpreterGraph20ResetVariableTensorsEv) referenced from micro_interpreter_graph.o(.rodata._ZTVN6tflite21MicroInterpreterGraphE)
- tflite::MicroInterpreterGraph::~MicroInterpreterGraph__deallocating() from micro_interpreter_graph.o(.text._ZN6tflite21MicroInterpreterGraphD0Ev) referenced from micro_interpreter_graph.o(.rodata._ZTVN6tflite21MicroInterpreterGraphE)
- tflite::MicroInterpreterGraph::~MicroInterpreterGraph() from micro_interpreter_graph.o(.text._ZN6tflite21MicroInterpreterGraphD0Ev) referenced from micro_interpreter_graph.o(.rodata._ZTVN6tflite21MicroInterpreterGraphE)
- tflite::reference_integer_ops::AddFunc(signed char, signed char, tflite::ArithmeticParams const&) from add.o(.text._ZN6tflite21reference_integer_ops7AddFuncEaaRKNS_16ArithmeticParamsE) referenced from add.o(.text._ZN6tflite12_GLOBAL__N_120EvalAddQuantizedInt8EP13TfLiteContextP10TfLiteNodeP15TfLiteAddParamsPKNS0_6OpDataEPK16TfLiteEvalTensorSC_PSA_.constprop.0)
- tflite::MicroMutableOpResolver⟨12u⟩::~MicroMutableOpResolver__deallocating() from model_ops_npu.o(.text._ZN6tflite22MicroMutableOpResolverILj12EED0Ev) referenced from model_ops_npu.o(.rodata._ZTVN6tflite22MicroMutableOpResolverILj12EEE)
- tflite::MicroInterpreterContext::GetEvalTensor(int) from micro_interpreter_context.o(.text._ZN6tflite23MicroInterpreterContext13GetEvalTensorEi) referenced from micro_interpreter_context.o(.rodata._ZTVN6tflite23MicroInterpreterContextE)
- tflite::MicroInterpreterContext::GetScratchBuffer(int) from micro_interpreter_context.o(.text._ZN6tflite23MicroInterpreterContext16GetScratchBufferEi) referenced from micro_interpreter_context.o(.rodata._ZTVN6tflite23MicroInterpreterContextE)
- tflite::MicroInterpreterContext::external_context() from micro_interpreter_context.o(.text._ZN6tflite23MicroInterpreterContext16external_contextEv) referenced from micro_interpreter_context.o(.rodata._ZTVN6tflite23MicroInterpreterContextE)
- tflite::MicroInterpreterContext::AllocateTempBuffer(unsigned int, unsigned int) from micro_interpreter_context.o(.text._ZN6tflite23MicroInterpreterContext18AllocateTempBufferEjj) referenced from micro_interpreter_context.o(.rodata._ZTVN6tflite23MicroInterpreterContextE)
- tflite::MicroInterpreterContext::DeallocateTempBuffer(unsigned char*) from micro_interpreter_context.o(.text._ZN6tflite23MicroInterpreterContext20DeallocateTempBufferEPh) referenced from micro_interpreter_context.o(.rodata._ZTVN6tflite23MicroInterpreterContextE)
- tflite::MicroInterpreterContext::set_external_context(void*) from micro_interpreter_context.o(.text._ZN6tflite23MicroInterpreterContext20set_external_contextEPv) referenced from micro_interpreter_context.o(.rodata._ZTVN6tflite23MicroInterpreterContextE)
- tflite::MicroInterpreterContext::AllocatePersistentBuffer(unsigned int) from micro_interpreter_context.o(.text._ZN6tflite23MicroInterpreterContext24AllocatePersistentBufferEj) referenced from micro_interpreter_context.o(.rodata._ZTVN6tflite23MicroInterpreterContextE)
- tflite::MicroInterpreterContext::AllocateTempTfLiteTensor(int) from micro_interpreter_context.o(.text._ZN6tflite23MicroInterpreterContext24AllocateTempTfLiteTensorEi) referenced from micro_interpreter_context.o(.rodata._ZTVN6tflite23MicroInterpreterContextE)
- tflite::MicroInterpreterContext::DeallocateTempTfLiteTensor(TfLiteTensor*) from micro_interpreter_context.o(.text._ZN6tflite23MicroInterpreterContext26DeallocateTempTfLiteTensorEP12TfLiteTensor) referenced from micro_interpreter_context.o(.rodata._ZTVN6tflite23MicroInterpreterContextE)
- tflite::MicroInterpreterContext::RequestScratchBufferInArena(unsigned int, int*) from micro_interpreter_context.o(.text._ZN6tflite23MicroInterpreterContext27RequestScratchBufferInArenaEjPi) referenced from micro_interpreter_context.o(.rodata._ZTVN6tflite23MicroInterpreterContextE)
- tflite::MicroInterpreterContext::graph() from micro_interpreter_context.o(.text._ZN6tflite23MicroInterpreterContext5graphEv) referenced from micro_interpreter_context.o(.rodata._ZTVN6tflite23MicroInterpreterContextE)
- tflite::MicroInterpreterContext::~MicroInterpreterContext__deallocating() from micro_interpreter_context.o(.text._ZN6tflite23MicroInterpreterContextD0Ev) referenced from micro_interpreter_context.o(.rodata._ZTVN6tflite23MicroInterpreterContextE)
- tflite::MicroInterpreterContext::~MicroInterpreterContext() from micro_interpreter_context.o(.text._ZN6tflite23MicroInterpreterContextD0Ev) referenced from micro_interpreter_context.o(.rodata._ZTVN6tflite23MicroInterpreterContextE)
- tflite::PrepareQuantizeReference(TfLiteContext*, TfLiteNode*) from quantize_common.o(.text._ZN6tflite24PrepareQuantizeReferenceEP13TfLiteContextP10TfLiteNode) referenced from quantize.o(.text._ZN6tflite17Register_QUANTIZEEv)
- tflite::MicroContextGetEvalTensor(TfLiteContext const*, int) from micro_interpreter.o(.text._ZN6tflite25MicroContextGetEvalTensorEPK13TfLiteContexti) referenced from micro_interpreter.o(.text._ZN6tflite16MicroInterpreter4InitEPNS_22MicroProfilerInterfaceE)
- tflite::MicroContextReportOpError(TfLiteContext*, char const*, ...) from micro_context.o(.text._ZN6tflite25MicroContextReportOpErrorEP13TfLiteContextPKcz) referenced from micro_interpreter.o(.text._ZN6tflite16MicroInterpreter4InitEPNS_22MicroProfilerInterfaceE)
- tflite::ParseResizeNearestNeighbor(tflite::Operator const*, tflite::ErrorReporter*, tflite::BuiltinDataAllocator*, void**) from flatbuffer_conversions.o(.text._ZN6tflite26ParseResizeNearestNeighborEPKNS_8OperatorEPNS_13ErrorReporterEPNS_20BuiltinDataAllocatorEPPv) referenced 2 times from model_ops_npu.o(.text._Z20MODEL_GetOpsResolverv)
- tflite::SingleArenaBufferAllocator::AllocateTemp(unsigned int, unsigned int) from single_arena_buffer_allocator.o(.text._ZN6tflite26SingleArenaBufferAllocator12AllocateTempEjj) referenced from single_arena_buffer_allocator.o(.rodata._ZTVN6tflite26SingleArenaBufferAllocatorE)
- tflite::SingleArenaBufferAllocator::ResizeBuffer(unsigned char*, unsigned int, unsigned int) from single_arena_buffer_allocator.o(.text._ZN6tflite26SingleArenaBufferAllocator12ResizeBufferEPhjj) referenced from single_arena_buffer_allocator.o(.rodata._ZTVN6tflite26SingleArenaBufferAllocatorE)
- tflite::SingleArenaBufferAllocator::DeallocateTemp(unsigned char*) from single_arena_buffer_allocator.o(.text._ZN6tflite26SingleArenaBufferAllocator14DeallocateTempEPh) referenced from single_arena_buffer_allocator.o(.rodata._ZTVN6tflite26SingleArenaBufferAllocatorE)
- tflite::SingleArenaBufferAllocator::IsAllTempDeallocated() from single_arena_buffer_allocator.o(.text._ZN6tflite26SingleArenaBufferAllocator20IsAllTempDeallocatedEv) referenced from single_arena_buffer_allocator.o(.rodata._ZTVN6tflite26SingleArenaBufferAllocatorE)
- tflite::SingleArenaBufferAllocator::ResetTempAllocations() from single_arena_buffer_allocator.o(.text._ZN6tflite26SingleArenaBufferAllocator20ResetTempAllocationsEv) referenced from single_arena_buffer_allocator.o(.rodata._ZTVN6tflite26SingleArenaBufferAllocatorE)
- tflite::SingleArenaBufferAllocator::AllocateResizableBuffer(unsigned int, unsigned int) from single_arena_buffer_allocator.o(.text._ZN6tflite26SingleArenaBufferAllocator23AllocateResizableBufferEjj) referenced from single_arena_buffer_allocator.o(.rodata._ZTVN6tflite26SingleArenaBufferAllocatorE)
- tflite::SingleArenaBufferAllocator::AllocatePersistentBuffer(unsigned int, unsigned int) from single_arena_buffer_allocator.o(.text._ZN6tflite26SingleArenaBufferAllocator24AllocatePersistentBufferEjj) referenced from single_arena_buffer_allocator.o(.rodata._ZTVN6tflite26SingleArenaBufferAllocatorE)
- tflite::SingleArenaBufferAllocator::DeallocateResizableBuffer(unsigned char*) from single_arena_buffer_allocator.o(.text._ZN6tflite26SingleArenaBufferAllocator25DeallocateResizableBufferEPh) referenced from single_arena_buffer_allocator.o(.rodata._ZTVN6tflite26SingleArenaBufferAllocatorE)
- tflite::SingleArenaBufferAllocator::ReserveNonPersistentOverlayMemory(unsigned int, unsigned int) from single_arena_buffer_allocator.o(.text._ZN6tflite26SingleArenaBufferAllocator33ReserveNonPersistentOverlayMemoryEjj) referenced from single_arena_buffer_allocator.o(.rodata._ZTVN6tflite26SingleArenaBufferAllocatorE)
- tflite::SingleArenaBufferAllocator::~SingleArenaBufferAllocator__deallocating() from single_arena_buffer_allocator.o(.text._ZN6tflite26SingleArenaBufferAllocatorD0Ev) referenced from single_arena_buffer_allocator.o(.rodata._ZTVN6tflite26SingleArenaBufferAllocatorE)
- tflite::SingleArenaBufferAllocator::~SingleArenaBufferAllocator() from single_arena_buffer_allocator.o(.text._ZN6tflite26SingleArenaBufferAllocatorD0Ev) referenced from single_arena_buffer_allocator.o(.rodata._ZTVN6tflite26SingleArenaBufferAllocatorE)
- tflite::MicroContextGetScratchBuffer(TfLiteContext*, int) from micro_interpreter.o(.text._ZN6tflite28MicroContextGetScratchBufferEP13TfLiteContexti) referenced from micro_interpreter.o(.text._ZN6tflite16MicroInterpreter4InitEPNS_22MicroProfilerInterfaceE)
- tflite::MicroContextGetExternalContext(TfLiteContext*, TfLiteExternalContextType) from micro_interpreter.o(.text._ZN6tflite30MicroContextGetExternalContextEP13TfLiteContext25TfLiteExternalContextType) referenced from micro_interpreter.o(.text._ZN6tflite16MicroInterpreter4InitEPNS_22MicroProfilerInterfaceE)
- tflite::MicroContextAllocatePersistentBuffer(TfLiteContext*, unsigned int) from micro_interpreter.o(.text._ZN6tflite36MicroContextAllocatePersistentBufferEP13TfLiteContextj) referenced from micro_interpreter.o(.text._ZN6tflite16MicroInterpreter4InitEPNS_22MicroProfilerInterfaceE)
- tflite::MicroContextRequestScratchBufferInArena(TfLiteContext*, unsigned int, int*) from micro_interpreter.o(.text._ZN6tflite39MicroContextRequestScratchBufferInArenaEP13TfLiteContextjPi) referenced from micro_interpreter.o(.text._ZN6tflite16MicroInterpreter4InitEPNS_22MicroProfilerInterfaceE)
- tflite::EvalAdd(TfLiteContext*, TfLiteNode*) from add.o(.text._ZN6tflite7EvalAddEP13TfLiteContextP10TfLiteNode) referenced from add.o(.text._ZN6tflite12Register_ADDEv)
- tflite::InitAdd(TfLiteContext*, char const*, unsigned int) from add.o(.text._ZN6tflite7InitAddEP13TfLiteContextPKcj) referenced from add.o(.text._ZN6tflite12Register_ADDEv)
- tflite::ParseAdd(tflite::Operator const*, tflite::ErrorReporter*, tflite::BuiltinDataAllocator*, void**) from flatbuffer_conversions.o(.text._ZN6tflite8ParseAddEPKNS_8OperatorEPNS_13ErrorReporterEPNS_20BuiltinDataAllocatorEPPv) referenced 2 times from model_ops_npu.o(.text._Z20MODEL_GetOpsResolverv)
- tflite::ParsePad(tflite::Operator const*, tflite::ErrorReporter*, tflite::BuiltinDataAllocator*, void**) from flatbuffer_conversions.o(.text._ZN6tflite8ParsePadEPKNS_8OperatorEPNS_13ErrorReporterEPNS_20BuiltinDataAllocatorEPPv) referenced 2 times from model_ops_npu.o(.text._Z20MODEL_GetOpsResolverv)
- tflite::ParsePool(tflite::Operator const*, tflite::ErrorReporter*, tflite::BuiltinDataAllocator*, void**) from flatbuffer_conversions.o(.text._ZN6tflite9ParsePoolEPKNS_8OperatorEPNS_13ErrorReporterEPNS_20BuiltinDataAllocatorEPPv) referenced 2 times from model_ops_npu.o(.text._Z20MODEL_GetOpsResolverv)
- tflite::GreedyMemoryPlanner::preserves_all_tensors() const from greedy_memory_planner.o(.text._ZNK6tflite19GreedyMemoryPlanner21preserves_all_tensorsEv) referenced from greedy_memory_planner.o(.rodata._ZTVN6tflite19GreedyMemoryPlannerE)
- tflite::LinearMemoryPlanner::preserves_all_tensors() const from linear_memory_planner.o(.text._ZNK6tflite19LinearMemoryPlanner21preserves_all_tensorsEv) referenced from linear_memory_planner.o(.rodata._ZTVN6tflite19LinearMemoryPlannerE)
- tflite::MicroMutableOpResolver⟨12u⟩::GetOpDataParser(tflite::BuiltinOperator) const from model_ops_npu.o(.text._ZNK6tflite22MicroMutableOpResolverILj12EE15GetOpDataParserENS_15BuiltinOperatorE) referenced from model_ops_npu.o(.rodata._ZTVN6tflite22MicroMutableOpResolverILj12EEE)
- tflite::MicroMutableOpResolver⟨12u⟩::FindOp(tflite::BuiltinOperator) const from model_ops_npu.o(.text._ZNK6tflite22MicroMutableOpResolverILj12EE6FindOpENS_15BuiltinOperatorE) referenced from model_ops_npu.o(.rodata._ZTVN6tflite22MicroMutableOpResolverILj12EEE)
- tflite::MicroMutableOpResolver⟨12u⟩::FindOp(char const*) const from model_ops_npu.o(.text._ZNK6tflite22MicroMutableOpResolverILj12EE6FindOpEPKc) referenced from model_ops_npu.o(.rodata._ZTVN6tflite22MicroMutableOpResolverILj12EEE)
- tflite::SingleArenaBufferAllocator::GetAvailableMemory(unsigned int) const from single_arena_buffer_allocator.o(.text._ZNK6tflite26SingleArenaBufferAllocator18GetAvailableMemoryEj) referenced from single_arena_buffer_allocator.o(.rodata._ZTVN6tflite26SingleArenaBufferAllocatorE)
- tflite::SingleArenaBufferAllocator::GetPersistentUsedBytes() const from single_arena_buffer_allocator.o(.text._ZNK6tflite26SingleArenaBufferAllocator22GetPersistentUsedBytesEv) referenced from single_arena_buffer_allocator.o(.rodata._ZTVN6tflite26SingleArenaBufferAllocatorE)
- tflite::SingleArenaBufferAllocator::GetOverlayMemoryAddress() const from single_arena_buffer_allocator.o(.text._ZNK6tflite26SingleArenaBufferAllocator23GetOverlayMemoryAddressEv) referenced from single_arena_buffer_allocator.o(.rodata._ZTVN6tflite26SingleArenaBufferAllocatorE)
- tflite::SingleArenaBufferAllocator::GetNonPersistentUsedBytes() const from single_arena_buffer_allocator.o(.text._ZNK6tflite26SingleArenaBufferAllocator25GetNonPersistentUsedBytesEv) referenced from single_arena_buffer_allocator.o(.rodata._ZTVN6tflite26SingleArenaBufferAllocatorE)
- std::__2::vector⟨yolo::object_detection::DetectionResult, std::__2::allocator⟨yolo::object_detection::DetectionResult⟩⟩::~vector__sub_object[abi:v16000]() from zf_model_process.o(.text._ZNSt3__26vectorIN4yolo16object_detection15DetectionResultENS_9allocatorIS3_EEED2B6v16000Ev) referenced 2 times from zf_model_process.o(.text._GLOBAL__sub_I_zf_model_process.cpp)
- non-virtual thunk to tflite::SingleArenaBufferAllocator::AllocatePersistentBuffer(unsigned int, unsigned int) from single_arena_buffer_allocator.o(.text._ZThn4_N6tflite26SingleArenaBufferAllocator24AllocatePersistentBufferEjj) referenced from single_arena_buffer_allocator.o(.rodata._ZTVN6tflite26SingleArenaBufferAllocatorE)
- non-virtual thunk to tflite::SingleArenaBufferAllocator::~SingleArenaBufferAllocator__deallocating() from single_arena_buffer_allocator.o(.text._ZThn4_N6tflite26SingleArenaBufferAllocatorD0Ev) referenced from single_arena_buffer_allocator.o(.rodata._ZTVN6tflite26SingleArenaBufferAllocatorE)
- non-virtual thunk to tflite::SingleArenaBufferAllocator::~SingleArenaBufferAllocator() from single_arena_buffer_allocator.o(.text._ZThn4_N6tflite26SingleArenaBufferAllocatorD1Ev) referenced from single_arena_buffer_allocator.o(.rodata._ZTVN6tflite26SingleArenaBufferAllocatorE)
- non-virtual thunk to tflite::SingleArenaBufferAllocator::GetPersistentUsedBytes() const from single_arena_buffer_allocator.o(.text._ZThn4_NK6tflite26SingleArenaBufferAllocator22GetPersistentUsedBytesEv) referenced from single_arena_buffer_allocator.o(.rodata._ZTVN6tflite26SingleArenaBufferAllocatorE)
- __main from __main.o(!!!main) referenced from startup_mcxn947_cm33_core0.o(.text)
- _get_lc_ctype from lc_ctype_c.o(locale$$code) referenced from rt_ctype_table.o(.text)
- _printf_input_char from _printf_char_common.o(.text) referenced from _printf_char_common.o(.text)
- _snputc from _snputc.o(.text) referenced from vsnprintf.o(.text)
- ezh_camera_callback from zf_driver_ezh.o(.text.ezh_camera_callback) referenced 2 times from zf_driver_ezh.o(.text.ezh_start)

### Global Symbols

__main (Thumb, 8 bytes, Stack size 0 bytes, __main.o(!!!main))

[Calls]

- >> __rt_entry
- >> __scatterload

[Address Reference Count : 1]

- startup_mcxn947_cm33_core0.o(.text)

__scatterload (Thumb, 0 bytes, Stack size unknown bytes, __scatter.o(!!!scatter))

[Called By]

- >> __main

__scatterload_rt2 (Thumb, 44 bytes, Stack size unknown bytes, __scatter.o(!!!scatter), UNUSED)

[Calls]

- >> __rt_entry

__scatterload_rt2_thumb_only (Thumb, 0 bytes, Stack size unknown bytes, __scatter.o(!!!scatter), UNUSED)

__scatterload_null (Thumb, 0 bytes, Stack size unknown bytes, __scatter.o(!!!scatter), UNUSED)

__decompress (Thumb, 58 bytes, Stack size unknown bytes, __dczerorl.o(!!dczerorl), UNUSED)

__decompress0 (Thumb, 0 bytes, Stack size unknown bytes, __dczerorl.o(!!dczerorl), UNUSED)

__scatterload_zeroinit (Thumb, 28 bytes, Stack size unknown bytes, __scatter_zi.o(!!handler_zi), UNUSED)

_printf_n (Thumb, 0 bytes, Stack size unknown bytes, _printf_n.o(.ARM.Collect$$_printf_percent$$00000001))

[Calls]

- >> _printf_charcount

_printf_percent (Thumb, 0 bytes, Stack size unknown bytes, _printf_percent.o(.ARM.Collect$$_printf_percent$$00000000))

[Called By]

- >> __printf

_printf_p (Thumb, 0 bytes, Stack size unknown bytes, _printf_p.o(.ARM.Collect$$_printf_percent$$00000002))

[Stack]

- Max Depth = 64 + Unknown Stack Size
- Call Chain = _printf_p ⇒ _printf_hex_ptr ⇒ _printf_longlong_hex ⇒ _printf_int_common ⇒ _printf_post_padding

[Calls]

- >> _printf_hex_ptr

_printf_f (Thumb, 0 bytes, Stack size unknown bytes, _printf_f.o(.ARM.Collect$$_printf_percent$$00000003))

[Stack]

- Max Depth = 1968 + Unknown Stack Size
- Call Chain = _printf_f ⇒ _printf_fp_dec ⇒ _printf_fp_dec_real ⇒ _fp_digits ⇒ _btod_main ⇒ _btod_common ⇒ _btod_pow ⇒ _btod_mul

[Calls]

- >> _printf_fp_dec

_printf_e (Thumb, 0 bytes, Stack size unknown bytes, _printf_e.o(.ARM.Collect$$_printf_percent$$00000004))

[Stack]

- Max Depth = 1968 + Unknown Stack Size
- Call Chain = _printf_e ⇒ _printf_fp_dec ⇒ _printf_fp_dec_real ⇒ _fp_digits ⇒ _btod_main ⇒ _btod_common ⇒ _btod_pow ⇒ _btod_mul

[Calls]

- >> _printf_fp_dec

_printf_g (Thumb, 0 bytes, Stack size unknown bytes, _printf_g.o(.ARM.Collect$$_printf_percent$$00000005))

[Stack]

- Max Depth = 1968 + Unknown Stack Size
- Call Chain = _printf_g ⇒ _printf_fp_dec ⇒ _printf_fp_dec_real ⇒ _fp_digits ⇒ _btod_main ⇒ _btod_common ⇒ _btod_pow ⇒ _btod_mul

[Calls]

- >> _printf_fp_dec

_printf_a (Thumb, 0 bytes, Stack size unknown bytes, _printf_a.o(.ARM.Collect$$_printf_percent$$00000006))

[Stack]

- Max Depth = 112 + Unknown Stack Size
- Call Chain = _printf_a ⇒ _printf_fp_hex ⇒ _printf_fp_hex_real ⇒ _printf_fp_infnan ⇒ _printf_post_padding

[Calls]

- >> _printf_fp_hex

_printf_ll (Thumb, 0 bytes, Stack size unknown bytes, _printf_ll.o(.ARM.Collect$$_printf_percent$$00000007))

_printf_i (Thumb, 0 bytes, Stack size unknown bytes, _printf_i.o(.ARM.Collect$$_printf_percent$$00000008))

[Stack]

- Max Depth = 72 + Unknown Stack Size
- Call Chain = _printf_i ⇒ _printf_int_dec ⇒ _printf_int_common ⇒ _printf_post_padding

[Calls]

- >> _printf_int_dec

_printf_d (Thumb, 0 bytes, Stack size unknown bytes, _printf_d.o(.ARM.Collect$$_printf_percent$$00000009))

[Stack]

- Max Depth = 72 + Unknown Stack Size
- Call Chain = _printf_d ⇒ _printf_int_dec ⇒ _printf_int_common ⇒ _printf_post_padding

[Calls]

- >> _printf_int_dec

_printf_u (Thumb, 0 bytes, Stack size unknown bytes, _printf_u.o(.ARM.Collect$$_printf_percent$$0000000A))

[Stack]

- Max Depth = 72 + Unknown Stack Size
- Call Chain = _printf_u ⇒ _printf_int_dec ⇒ _printf_int_common ⇒ _printf_post_padding

[Calls]

- >> _printf_int_dec

_printf_o (Thumb, 0 bytes, Stack size unknown bytes, _printf_o.o(.ARM.Collect$$_printf_percent$$0000000B))

[Stack]

- Max Depth = 64 + Unknown Stack Size
- Call Chain = _printf_o ⇒ _printf_int_oct ⇒ _printf_longlong_oct ⇒ _printf_int_common ⇒ _printf_post_padding

[Calls]

- >> _printf_int_oct

_printf_x (Thumb, 0 bytes, Stack size unknown bytes, _printf_x.o(.ARM.Collect$$_printf_percent$$0000000C))

[Stack]

- Max Depth = 80 + Unknown Stack Size
- Call Chain = _printf_x ⇒ _printf_int_hex ⇒ _printf_longlong_hex ⇒ _printf_int_common ⇒ _printf_post_padding

[Calls]

- >> _printf_int_hex

_printf_lli (Thumb, 0 bytes, Stack size unknown bytes, _printf_lli.o(.ARM.Collect$$_printf_percent$$0000000D))

[Stack]

- Max Depth = 72 + Unknown Stack Size
- Call Chain = _printf_lli ⇒ _printf_longlong_dec ⇒ _printf_int_common ⇒ _printf_post_padding

[Calls]

- >> _printf_longlong_dec

_printf_lld (Thumb, 0 bytes, Stack size unknown bytes, _printf_lld.o(.ARM.Collect$$_printf_percent$$0000000E))

[Stack]

- Max Depth = 72 + Unknown Stack Size
- Call Chain = _printf_lld ⇒ _printf_longlong_dec ⇒ _printf_int_common ⇒ _printf_post_padding

[Calls]

- >> _printf_longlong_dec

_printf_llu (Thumb, 0 bytes, Stack size unknown bytes, _printf_llu.o(.ARM.Collect$$_printf_percent$$0000000F))

[Stack]

- Max Depth = 72 + Unknown Stack Size
- Call Chain = _printf_llu ⇒ _printf_longlong_dec ⇒ _printf_int_common ⇒ _printf_post_padding

[Calls]

- >> _printf_longlong_dec

_printf_llo (Thumb, 0 bytes, Stack size unknown bytes, _printf_llo.o(.ARM.Collect$$_printf_percent$$00000010))

[Stack]

- Max Depth = 56 + Unknown Stack Size
- Call Chain = _printf_llo ⇒ _printf_ll_oct ⇒ _printf_longlong_oct ⇒ _printf_int_common ⇒ _printf_post_padding

[Calls]

- >> _printf_ll_oct

_printf_llx (Thumb, 0 bytes, Stack size unknown bytes, _printf_llx.o(.ARM.Collect$$_printf_percent$$00000011))

[Stack]

- Max Depth = 64 + Unknown Stack Size
- Call Chain = _printf_llx ⇒ _printf_ll_hex ⇒ _printf_longlong_hex ⇒ _printf_int_common ⇒ _printf_post_padding

[Calls]

- >> _printf_ll_hex

_printf_l (Thumb, 0 bytes, Stack size unknown bytes, _printf_l.o(.ARM.Collect$$_printf_percent$$00000012))

_printf_c (Thumb, 0 bytes, Stack size unknown bytes, _printf_c.o(.ARM.Collect$$_printf_percent$$00000013))

[Stack]

- Max Depth = 40 + Unknown Stack Size
- Call Chain = _printf_c ⇒ _printf_char ⇒ _printf_cs_common ⇒ _printf_str ⇒ _printf_post_padding

[Calls]

- >> _printf_char

_printf_s (Thumb, 0 bytes, Stack size unknown bytes, _printf_s.o(.ARM.Collect$$_printf_percent$$00000014))

[Stack]

- Max Depth = 40 + Unknown Stack Size
- Call Chain = _printf_s ⇒ _printf_string ⇒ _printf_cs_common ⇒ _printf_str ⇒ _printf_post_padding

[Calls]

- >> _printf_string

_printf_lc (Thumb, 0 bytes, Stack size unknown bytes, _printf_lc.o(.ARM.Collect$$_printf_percent$$00000015))

[Stack]

- Max Depth = 88 + Unknown Stack Size
- Call Chain = _printf_lc ⇒ _printf_wchar ⇒ _printf_lcs_common ⇒ _printf_wctomb ⇒ _wcrtomb

[Calls]

- >> _printf_wchar

_printf_ls (Thumb, 0 bytes, Stack size unknown bytes, _printf_ls.o(.ARM.Collect$$_printf_percent$$00000016))

[Stack]

- Max Depth = 88 + Unknown Stack Size
- Call Chain = _printf_ls ⇒ _printf_wstring ⇒ _printf_lcs_common ⇒ _printf_wctomb ⇒ _wcrtomb

[Calls]

- >> _printf_wstring

_printf_percent_end (Thumb, 0 bytes, Stack size unknown bytes, _printf_percent_end.o(.ARM.Collect$$_printf_percent$$00000017))

__rt_lib_init (Thumb, 0 bytes, Stack size unknown bytes, libinit.o(.ARM.Collect$$libinit$$00000000))

[Called By]

- >> __rt_entry_li

__rt_lib_init_fp_1 (Thumb, 0 bytes, Stack size unknown bytes, libinit2.o(.ARM.Collect$$libinit$$00000001))

[Calls]

- >> _fp_init

__rt_lib_init_heap_2 (Thumb, 0 bytes, Stack size unknown bytes, libinit5.o(.ARM.Collect$$libinit$$0000000A))

[Stack]

- Max Depth = 64 + Unknown Stack Size
- Call Chain = __rt_lib_init_heap_2 ⇒ _init_alloc ⇒ __rt_SIGRTMEM ⇒ __rt_SIGRTMEM_inner ⇒ __default_signal_display ⇒ _ttywrch

[Calls]

- >> _init_alloc

__rt_lib_init_preinit_1 (Thumb, 0 bytes, Stack size unknown bytes, libinit2.o(.ARM.Collect$$libinit$$00000006))

__rt_lib_init_relocate_pie_1 (Thumb, 0 bytes, Stack size unknown bytes, libinit2.o(.ARM.Collect$$libinit$$00000004))

__rt_lib_init_heap_1 (Thumb, 0 bytes, Stack size unknown bytes, libinit2.o(.ARM.Collect$$libinit$$0000000C))

__rt_lib_init_lc_common (Thumb, 0 bytes, Stack size unknown bytes, libinit2.o(.ARM.Collect$$libinit$$00000011))

[Calls]

- >> __rt_locale

__rt_lib_init_rand_1 (Thumb, 0 bytes, Stack size unknown bytes, libinit2.o(.ARM.Collect$$libinit$$00000010))

__rt_lib_init_user_alloc_1 (Thumb, 0 bytes, Stack size unknown bytes, libinit2.o(.ARM.Collect$$libinit$$0000000E))

__rt_lib_init_lc_collate_1 (Thumb, 0 bytes, Stack size unknown bytes, libinit2.o(.ARM.Collect$$libinit$$00000013))

__rt_lib_init_lc_ctype_2 (Thumb, 0 bytes, Stack size unknown bytes, libinit2.o(.ARM.Collect$$libinit$$00000014))

[Stack]

- Max Depth = 16 + Unknown Stack Size
- Call Chain = __rt_lib_init_lc_ctype_2 ⇒ _get_lc_ctype ⇒ strcmp

[Calls]

- >> _get_lc_ctype

__rt_lib_init_lc_ctype_1 (Thumb, 0 bytes, Stack size unknown bytes, libinit2.o(.ARM.Collect$$libinit$$00000015))

__rt_lib_init_lc_monetary_1 (Thumb, 0 bytes, Stack size unknown bytes, libinit2.o(.ARM.Collect$$libinit$$00000017))

__rt_lib_init_lc_numeric_2 (Thumb, 0 bytes, Stack size unknown bytes, libinit2.o(.ARM.Collect$$libinit$$00000018))

[Stack]

- Max Depth = 16 + Unknown Stack Size
- Call Chain = __rt_lib_init_lc_numeric_2 ⇒ _get_lc_numeric ⇒ strcmp

[Calls]

- >> _get_lc_numeric

__rt_lib_init_alloca_1 (Thumb, 0 bytes, Stack size unknown bytes, libinit2.o(.ARM.Collect$$libinit$$00000030))

__rt_lib_init_argv_1 (Thumb, 0 bytes, Stack size unknown bytes, libinit2.o(.ARM.Collect$$libinit$$0000002E))

__rt_lib_init_atexit_1 (Thumb, 0 bytes, Stack size unknown bytes, libinit2.o(.ARM.Collect$$libinit$$0000001D))

__rt_lib_init_clock_1 (Thumb, 0 bytes, Stack size unknown bytes, libinit2.o(.ARM.Collect$$libinit$$00000023))

__rt_lib_init_cpp_2 (Thumb, 0 bytes, Stack size unknown bytes, libinit2.o(.ARM.Collect$$libinit$$00000033))

[Stack]

- Max Depth = 16 + Unknown Stack Size
- Call Chain = __rt_lib_init_cpp_2 ⇒ __cpp_initialize__aeabi_

[Calls]

- >> __cpp_initialize__aeabi_

__rt_lib_init_exceptions_1 (Thumb, 0 bytes, Stack size unknown bytes, libinit2.o(.ARM.Collect$$libinit$$00000032))

__rt_lib_init_fp_trap_1 (Thumb, 0 bytes, Stack size unknown bytes, libinit2.o(.ARM.Collect$$libinit$$00000021))

__rt_lib_init_getenv_1 (Thumb, 0 bytes, Stack size unknown bytes, libinit2.o(.ARM.Collect$$libinit$$00000025))

__rt_lib_init_lc_numeric_1 (Thumb, 0 bytes, Stack size unknown bytes, libinit2.o(.ARM.Collect$$libinit$$00000019))

__rt_lib_init_lc_time_1 (Thumb, 0 bytes, Stack size unknown bytes, libinit2.o(.ARM.Collect$$libinit$$0000001B))

__rt_lib_init_signal_1 (Thumb, 0 bytes, Stack size unknown bytes, libinit2.o(.ARM.Collect$$libinit$$0000001F))

__rt_lib_init_stdio_1 (Thumb, 0 bytes, Stack size unknown bytes, libinit2.o(.ARM.Collect$$libinit$$00000027))

__rt_lib_init_cpp_1 (Thumb, 0 bytes, Stack size unknown bytes, libinit2.o(.ARM.Collect$$libinit$$00000034))

__rt_lib_init_return (Thumb, 0 bytes, Stack size unknown bytes, libinit2.o(.ARM.Collect$$libinit$$00000035))

__rt_lib_shutdown (Thumb, 0 bytes, Stack size unknown bytes, libshutdown.o(.ARM.Collect$$libshutdown$$00000000))

[Called By]

- >> abort
- >> __rt_exit_ls

__rt_lib_shutdown_cpp_2 (Thumb, 0 bytes, Stack size unknown bytes, libshutdown2.o(.ARM.Collect$$libshutdown$$00000001))

[Stack]

- Max Depth = 40 + Unknown Stack Size
- Call Chain = __rt_lib_shutdown_cpp_2 ⇒ __cxa_finalize ⇒ free

[Calls]

- >> __cxa_finalize

__rt_lib_shutdown_cpp_1 (Thumb, 0 bytes, Stack size unknown bytes, libshutdown2.o(.ARM.Collect$$libshutdown$$00000002))

__rt_lib_shutdown_fp_trap_1 (Thumb, 0 bytes, Stack size unknown bytes, libshutdown2.o(.ARM.Collect$$libshutdown$$00000007))

__rt_lib_shutdown_heap_1 (Thumb, 0 bytes, Stack size unknown bytes, libshutdown2.o(.ARM.Collect$$libshutdown$$0000000F))

__rt_lib_shutdown_return (Thumb, 0 bytes, Stack size unknown bytes, libshutdown2.o(.ARM.Collect$$libshutdown$$00000010))

__rt_lib_shutdown_signal_1 (Thumb, 0 bytes, Stack size unknown bytes, libshutdown2.o(.ARM.Collect$$libshutdown$$0000000A))

__rt_lib_shutdown_stdio_1 (Thumb, 0 bytes, Stack size unknown bytes, libshutdown2.o(.ARM.Collect$$libshutdown$$00000004))

__rt_lib_shutdown_user_alloc_1 (Thumb, 0 bytes, Stack size unknown bytes, libshutdown2.o(.ARM.Collect$$libshutdown$$0000000C))

__rt_entry (Thumb, 0 bytes, Stack size unknown bytes, __rtentry.o(.ARM.Collect$$rtentry$$00000000))

[Called By]

- >> __main
- >> __scatterload_rt2

__rt_entry_presh_1 (Thumb, 0 bytes, Stack size unknown bytes, __rtentry2.o(.ARM.Collect$$rtentry$$00000002))

__rt_entry_sh (Thumb, 0 bytes, Stack size unknown bytes, __rtentry7.o(.ARM.Collect$$rtentry$$00000007))

__rt_entry_li (Thumb, 0 bytes, Stack size unknown bytes, __rtentry2.o(.ARM.Collect$$rtentry$$0000000A))

[Calls]

- >> __rt_lib_init

__rt_entry_postsh_1 (Thumb, 0 bytes, Stack size unknown bytes, __rtentry2.o(.ARM.Collect$$rtentry$$00000009))

__rt_entry_main (Thumb, 0 bytes, Stack size unknown bytes, __rtentry2.o(.ARM.Collect$$rtentry$$0000000D))

[Stack]

- Max Depth = 1184 + Unknown Stack Size
- Call Chain = __rt_entry_main ⇒ main ⇒ ips200_init ⇒ ips200_set_region ⇒ LPSPI_MasterTransferEDMA ⇒ LPSPI_MasterTransferEDMALite ⇒ EDMA_TcdSetTransferConfig ⇒ EDMA_ConfigChannelSoftwareTCD ⇒ __aeabi_assert ⇒ DbgConsole_Printf ⇒ DbgConsole_Vprintf ⇒ memcpy

[Calls]

- >> main
- >> exit

__rt_entry_postli_1 (Thumb, 0 bytes, Stack size unknown bytes, __rtentry2.o(.ARM.Collect$$rtentry$$0000000C))

__rt_exit (Thumb, 0 bytes, Stack size unknown bytes, rtexit.o(.ARM.Collect$$rtexit$$00000000))

[Called By]

- >> exit

__rt_exit_ls (Thumb, 0 bytes, Stack size unknown bytes, rtexit2.o(.ARM.Collect$$rtexit$$00000003))

[Calls]

- >> __rt_lib_shutdown

__rt_exit_prels_1 (Thumb, 0 bytes, Stack size unknown bytes, rtexit2.o(.ARM.Collect$$rtexit$$00000002))

__rt_exit_exit (Thumb, 0 bytes, Stack size unknown bytes, rtexit2.o(.ARM.Collect$$rtexit$$00000004))

[Calls]

- >> _sys_exit

Reset_Handler (Thumb, 52 bytes, Stack size unknown bytes, startup_mcxn947_cm33_core0.o(.text))
[Address Reference Count : 1]

- startup_mcxn947_cm33_core0.o(.isr_vector)

ADC0_DriverIRQHandler (Thumb, 4 bytes, Stack size unknown bytes, startup_mcxn947_cm33_core0.o(.text))

[Calls]

- >> DefaultISR

[Address Reference Count : 1]

- startup_mcxn947_cm33_core0.o(.text)

ADC1_DriverIRQHandler (Thumb, 4 bytes, Stack size unknown bytes, startup_mcxn947_cm33_core0.o(.text))
[Address Reference Count : 1]

- startup_mcxn947_cm33_core0.o(.text)

BSP32_DriverIRQHandler (Thumb, 4 bytes, Stack size unknown bytes, startup_mcxn947_cm33_core0.o(.text))
[Address Reference Count : 1]

- startup_mcxn947_cm33_core0.o(.text)

BusFault_Handler (Thumb, 4 bytes, Stack size unknown bytes, startup_mcxn947_cm33_core0.o(.text))
[Address Reference Count : 1]

- startup_mcxn947_cm33_core0.o(.isr_vector)

CAN0_DriverIRQHandler (Thumb, 4 bytes, Stack size unknown bytes, startup_mcxn947_cm33_core0.o(.text))
[Address Reference Count : 1]

- startup_mcxn947_cm33_core0.o(.text)

CAN1_DriverIRQHandler (Thumb, 4 bytes, Stack size unknown bytes, startup_mcxn947_cm33_core0.o(.text))
[Address Reference Count : 1]

- startup_mcxn947_cm33_core0.o(.text)

CDOG0_DriverIRQHandler (Thumb, 4 bytes, Stack size unknown bytes, startup_mcxn947_cm33_core0.o(.text))
[Address Reference Count : 1]

- startup_mcxn947_cm33_core0.o(.text)

CDOG1_DriverIRQHandler (Thumb, 4 bytes, Stack size unknown bytes, startup_mcxn947_cm33_core0.o(.text))
[Address Reference Count : 1]

- startup_mcxn947_cm33_core0.o(.text)

CMC0_DriverIRQHandler (Thumb, 4 bytes, Stack size unknown bytes, startup_mcxn947_cm33_core0.o(.text))
[Address Reference Count : 1]

- startup_mcxn947_cm33_core0.o(.text)

CTI0_DriverIRQHandler (Thumb, 4 bytes, Stack size unknown bytes, startup_mcxn947_cm33_core0.o(.text))
[Address Reference Count : 1]

- startup_mcxn947_cm33_core0.o(.text)

DAC0_DriverIRQHandler (Thumb, 4 bytes, Stack size unknown bytes, startup_mcxn947_cm33_core0.o(.text))
[Address Reference Count : 1]

- startup_mcxn947_cm33_core0.o(.text)

DAC1_DriverIRQHandler (Thumb, 4 bytes, Stack size unknown bytes, startup_mcxn947_cm33_core0.o(.text))
[Address Reference Count : 1]

- startup_mcxn947_cm33_core0.o(.text)

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
[Address Reference Count : 1]

- startup_mcxn947_cm33_core0.o(.isr_vector)

TRNG0_IRQHandler (Thumb, 4 bytes, Stack size unknown bytes, startup_mcxn947_cm33_core0.o(.text))
[Address Reference Count : 1]

- startup_mcxn947_cm33_core0.o(.isr_vector)

WWDT0_IRQHandler (Thumb, 4 bytes, Stack size unknown bytes, startup_mcxn947_cm33_core0.o(.text))
[Address Reference Count : 1]

- startup_mcxn947_cm33_core0.o(.isr_vector)

WWDT1_IRQHandler (Thumb, 4 bytes, Stack size unknown bytes, startup_mcxn947_cm33_core0.o(.text))
[Address Reference Count : 1]

- startup_mcxn947_cm33_core0.o(.isr_vector)

CMC0_IRQHandler (Thumb, 4 bytes, Stack size unknown bytes, startup_mcxn947_cm33_core0.o(.text))
[Address Reference Count : 1]

- startup_mcxn947_cm33_core0.o(.isr_vector)

CTI0_IRQHandler (Thumb, 4 bytes, Stack size unknown bytes, startup_mcxn947_cm33_core0.o(.text))
[Address Reference Count : 1]

- startup_mcxn947_cm33_core0.o(.isr_vector)

__aeabi_errno_addr (Thumb, 8 bytes, Stack size 0 bytes, rt_errno_addr_intlibspace.o(.text))

[Called By]

- >> __set_errno
- >> __read_errno

__errno$intlibspace (Thumb, 0 bytes, Stack size 0 bytes, rt_errno_addr_intlibspace.o(.text), UNUSED)

__rt_errno_addr$intlibspace (Thumb, 0 bytes, Stack size 0 bytes, rt_errno_addr_intlibspace.o(.text), UNUSED)

malloc (Thumb, 94 bytes, Stack size 16 bytes, h1_alloc.o(.text))

[Stack]

- Max Depth = 48
- Call Chain = malloc ⇒ __Heap_Full ⇒ __Heap_ProvideMemory ⇒ free

[Calls]

- >> __Heap_Full
- >> __rt_heap_descriptor

[Called By]

- >> operator new(unsigned int)
- >> __aeabi_atexit

free (Thumb, 78 bytes, Stack size 16 bytes, h1_free.o(.text))

[Stack]

- Max Depth = 16
- Call Chain = free

[Calls]

- >> __rt_heap_descriptor

[Called By]

- >> operator delete(void*)
- >> driverFree
- >> __Heap_ProvideMemory
- >> __cxa_finalize

posix_memalign (Thumb, 174 bytes, Stack size 32 bytes, h1_memalign.o(.text))

[Stack]

- Max Depth = 64
- Call Chain = posix_memalign ⇒ __Heap_Full ⇒ __Heap_ProvideMemory ⇒ free

[Calls]

- >> __Heap_Full
- >> __rt_heap_descriptor

[Called By]

- >> memalign

__aeabi_uldivmod (Thumb, 0 bytes, Stack size 48 bytes, lludivv7m.o(.text))

[Stack]

- Max Depth = 48
- Call Chain = __aeabi_uldivmod

[Called By]

- >> SDK_DelayAtLeastUs
- >> LPSPI_MasterInit
- >> LPSPI_MasterSetDelayTimes

_ll_udiv (Thumb, 240 bytes, Stack size 48 bytes, lludivv7m.o(.text), UNUSED)

vsnprintf (Thumb, 56 bytes, Stack size 24 bytes, vsnprintf.o(.text))

[Stack]

- Max Depth = 128 + Unknown Stack Size
- Call Chain = vsnprintf ⇒ _printf_char_common ⇒ __printf

[Calls]

- >> _printf_char_common

[Called By]

- >> DebugLog

abort (Thumb, 22 bytes, Stack size 8 bytes, abort.o(.text))

[Stack]

- Max Depth = 48 + Unknown Stack Size
- Call Chain = abort ⇒ __rt_SIGABRT ⇒ __rt_SIGABRT_inner ⇒ __default_signal_display ⇒ _ttywrch

[Calls]

- >> __rt_SIGABRT
- >> _sys_exit
- >> __rt_lib_shutdown

[Called By]

- >> yolo::DetectorPostProcess::DoPostProcess()
- >> yolo::DetectorPostProcess::DetectorPostProcess(TfLiteTensor const**, std::__2::vector⟨yolo::object_detection::DetectionResult, std::__2::allocator⟨yolo::object_detection::DetectionResult⟩⟩&, yolo::object_detection::PostProcessParams const&)
- >> tflite::(anonymous namespace)::Eval(TfLiteContext*, TfLiteNode*)
- >> tflite::(anonymous namespace)::Prepare(TfLiteContext*, TfLiteNode*)
- >> tflite::(anonymous namespace)::Init(TfLiteContext*, char const*, unsigned int)
- >> tflite::(anonymous namespace)::Free(TfLiteContext*, void*)
- >> yolo::DetectorPostProcess::GetNetworkBoxes(yolo::object_detection::Network&, int, int, float, std::__2::forward_list⟨yolo::image::Detection, std::__2::allocator⟨yolo::image::Detection⟩⟩&)
- >> std::__throw_bad_array_new_length[abi:v16000]()
- >> std::__2::enable_if⟨__is_cpp17_forward_iterator⟨yolo::object_detection::Branch*⟩::value && is_constructible⟨yolo::object_detection::Branch, std::__2::iterator_traits⟨yolo::object_detection::Branch*⟩::reference⟩::value, void⟩::type std::__2::vector⟨yolo::object_detection::Branch, std::__2::allocator⟨yolo::object_detection::Branch⟩⟩::assign⟨yolo::object_detection::Branch*⟩(yolo::object_detection::Branch*, yolo::object_detection::Branch*)
- >> tflite::MicroMutableOpResolver⟨12u⟩::GetOpDataParser(tflite::BuiltinOperator) const
- >> abort_message

__cxa_atexit (Thumb, 10 bytes, Stack size 0 bytes, cxa_atexit.o(.text))

[Stack]

- Max Depth = 72
- Call Chain = __cxa_atexit ⇒ __aeabi_atexit ⇒ malloc ⇒ __Heap_Full ⇒ __Heap_ProvideMemory ⇒ free

[Calls]

- >> __aeabi_atexit

[Called By]

- >> MODEL_Init
- >> _GLOBAL__sub_I_zf_model_process.cpp
- >> MODEL_GetOpsResolver()

memcmp (Thumb, 88 bytes, Stack size 8 bytes, memcmp.o(.text))

[Stack]

- Max Depth = 8
- Call Chain = memcmp

[Called By]

- >> TfLiteIntArrayEqual
- >> tflite::reference_ops::ProcessBroadcastShapes(tflite::RuntimeShape const&, tflite::RuntimeShape const&, tflite::ArithmeticParams*)

strlen (Thumb, 62 bytes, Stack size 8 bytes, strlen.o(.text))

[Stack]

- Max Depth = 8
- Call Chain = strlen

[Called By]

- >> DbgConsole_Vprintf
- >> float_to_str

strncmp (Thumb, 150 bytes, Stack size 16 bytes, strncmp.o(.text))

[Stack]

- Max Depth = 16
- Call Chain = strncmp

[Called By]

- >> tflite::AllocationInfoBuilder::GetOfflinePlannedOffsets(long const**)

memcpy (Thumb, 8 bytes, Stack size 8 bytes, memcpy.o(.text))

[Stack]

- Max Depth = 8
- Call Chain = memcpy

[Calls]

- >> __aeabi_memcpy

[Called By]

- >> DbgConsole_Vprintf
- >> SD_CardInit
- >> SD_ReadBlocks
- >> SD_WriteBlocks
- >> HAL_GpioInit
- >> rgb565stridedtorgb888(unsigned short const*, int, int, int, int, int, unsigned char*, int, unsigned char)
- >> zf_model_run
- >> SMARTDMA_Init
- >> tflite::(anonymous namespace)::Eval(TfLiteContext*, TfLiteNode*)
- >> tflite::(anonymous namespace)::Eval(TfLiteContext*, TfLiteNode*)
- >> arm_max_pool_s8
- >> arm_max_pool_s16
- >> void tflite::reference_ops::PadImpl⟨short, short⟩(tflite::PadParams const&, tflite::RuntimeShape const&, short const*, short const*, tflite::RuntimeShape const&, short*)
- >> void tflite::reference_ops::PadImpl⟨signed char, signed char⟩(tflite::PadParams const&, tflite::RuntimeShape const&, signed char const*, signed char const*, tflite::RuntimeShape const&, signed char*)
- >> void tflite::reference_ops::PadImpl⟨float, float⟩(tflite::PadParams const&, tflite::RuntimeShape const&, float const*, float const*, tflite::RuntimeShape const&, float*)
- >> void tflite::reference_ops::PadImpl⟨long, long⟩(tflite::PadParams const&, tflite::RuntimeShape const&, long const*, long const*, tflite::RuntimeShape const&, long*)
- >> tflite::(anonymous namespace)::Prepare(TfLiteContext*, TfLiteNode*)
- >> tflite::micro::MakeUnpackedInt4Tensor(TfLiteContext*, int, TfLiteEvalTensor const*)
- >> tflite::GetTensorShape(TfLiteTensor const*)
- >> tflite::(anonymous namespace)::Prepare(TfLiteContext*, TfLiteNode*)
- >> void tflite::(anonymous namespace)::EvalUnquantized⟨float⟩(TfLiteContext*, TfLiteNode*)
- >> void tflite::(anonymous namespace)::EvalUnquantized⟨long⟩(TfLiteContext*, TfLiteNode*)
- >> void tflite::(anonymous namespace)::EvalUnquantized⟨short⟩(TfLiteContext*, TfLiteNode*)
- >> void tflite::(anonymous namespace)::EvalUnquantized⟨signed char⟩(TfLiteContext*, TfLiteNode*)
- >> void tflite::(anonymous namespace)::EvalUnquantized⟨bool⟩(TfLiteContext*, TfLiteNode*)
- >> void tflite::(anonymous namespace)::EvalUnquantized⟨long long⟩(TfLiteContext*, TfLiteNode*)
- >> tflite::micro::GetTensorShape(TfLiteEvalTensor const*)
- >> tflite::reference_ops::ProcessBroadcastShapes(tflite::RuntimeShape const&, tflite::RuntimeShape const&, tflite::ArithmeticParams*)
- >> neutronFwInterpreter
- >> arm_convolve_fast_s16
- >> arm_convolve_s8

__aeabi_memmove4 (Thumb, 0 bytes, Stack size 8 bytes, rt_memmove_w.o(.text))

[Stack]

- Max Depth = 8
- Call Chain = __aeabi_memmove4

[Called By]

- >> yolo::DetectorPostProcess::DetectorPostProcess(TfLiteTensor const**, std::__2::vector⟨yolo::object_detection::DetectionResult, std::__2::allocator⟨yolo::object_detection::DetectionResult⟩⟩&, yolo::object_detection::PostProcessParams const&)
- >> yolo::DetectorPostProcess::GetNetworkBoxes(yolo::object_detection::Network&, int, int, float, std::__2::forward_list⟨yolo::image::Detection, std::__2::allocator⟨yolo::image::Detection⟩⟩&)
- >> std::__2::enable_if⟨__is_cpp17_forward_iterator⟨yolo::object_detection::Branch*⟩::value && is_constructible⟨yolo::object_detection::Branch, std::__2::iterator_traits⟨yolo::object_detection::Branch*⟩::reference⟩::value, void⟩::type std::__2::vector⟨yolo::object_detection::Branch, std::__2::allocator⟨yolo::object_detection::Branch⟩⟩::assign⟨yolo::object_detection::Branch*⟩(yolo::object_detection::Branch*, yolo::object_detection::Branch*)

__aeabi_memmove8 (Thumb, 0 bytes, Stack size 8 bytes, rt_memmove_w.o(.text))

[Stack]

- Max Depth = 8
- Call Chain = __aeabi_memmove8

[Called By]

- >> yolo::DetectorPostProcess::DoPostProcess()

__rt_memmove_w (Thumb, 122 bytes, Stack size 8 bytes, rt_memmove_w.o(.text), UNUSED)

[Calls]

- >> __aeabi_memcpy4

__memmove_aligned (Thumb, 0 bytes, Stack size unknown bytes, rt_memmove_w.o(.text), UNUSED)

__memmove_lastfew_aligned (Thumb, 0 bytes, Stack size unknown bytes, rt_memmove_w.o(.text), UNUSED)

memset (Thumb, 22 bytes, Stack size 8 bytes, memset.o(.text))

[Stack]

- Max Depth = 12
- Call Chain = memset ⇒ _memset ⇒ _memset_w

[Calls]

- >> _memset

[Called By]

- >> LPSPI_MasterTransferCreateHandleEDMA
- >> EDMA_CreateHandle
- >> LPSPI_MasterGetDefaultConfig
- >> EDMA_GetDefaultConfig
- >> ezh_start
- >> SD_ReadBlocks
- >> SD_WriteBlocks
- >> LPTMR_GetDefaultConfig
- >> LPUART_GetDefaultConfig
- >> ips200_show_float
- >> ips200_show_int
- >> draw_rect_on_slice_buffer(unsigned short*, int, int, int, tagodresult_t*, int, int)
- >> zf_model_run
- >> PARAM_init
- >> scc8660_init
- >> ips200_init
- >> tflite::MicroInterpreterGraph::ResetVariableTensors()
- >> tflite::MicroInterpreter::PrepareNodeAndRegistrationDataFromFlatbuffer()
- >> tflite::internal::InitializeTfLiteTensorFromFlatbuffer(tflite::IPersistentBufferAllocator*, tflite::INonPersistentBufferAllocator*, bool, tflite::Tensor const&, flatbuffers::Vector⟨flatbuffers::Offset⟨tflite::Buffer⟩⟩ const*, TfLiteTensor*)
- >> SD_ReadStatus
- >> SD_SendScr
- >> SD_SelectFunction
- >> SDMMCHOST_ExecuteTuning
- >> SDMMCHOST_TransferFunction
- >> tflite::ParsePool(tflite::Operator const*, tflite::ErrorReporter*, tflite::BuiltinDataAllocator*, void**)
- >> tflite::ParseDepthwiseConv2D(tflite::Operator const*, tflite::ErrorReporter*, tflite::BuiltinDataAllocator*, void**)
- >> tflite::ParseConv2D(tflite::Operator const*, tflite::ErrorReporter*, tflite::BuiltinDataAllocator*, void**)
- >> tflite::MicroInterpreter::MicroInterpreter(tflite::Model const*, tflite::MicroOpResolver const&, unsigned char*, unsigned int, tflite::MicroResourceVariables*, tflite::MicroProfilerInterface*, bool)
- >> tflite::GreedyMemoryPlanner::PrintMemoryPlan()
- >> tflite::MicroResourceVariables::ResetAll()
- >> arm_convolve_fast_s16
- >> arm_depthwise_conv_s8_opt
- >> arm_convolve_s8

__aeabi_memclr4 (Thumb, 0 bytes, Stack size unknown bytes, rt_memclr_w.o(.text))

[Called By]

- >> SD_CardInit
- >> SD_ReadBlocks
- >> SD_WriteBlocks
- >> ips200_init
- >> LPSPI_MasterTransferEDMALite
- >> SDMMC_SetBlockSize
- >> SDMMC_GoIdle
- >> SDMMC_SelectCard
- >> SDMMC_SendApplicationCommand
- >> SD_ReadStatus
- >> SD_PollingCardStatusBusy
- >> SD_SetDataBusWidth
- >> SD_SendScr
- >> SD_SelectFunction
- >> SD_Transfer
- >> SDMMCHOST_ExecuteTuning

__aeabi_memclr8 (Thumb, 0 bytes, Stack size unknown bytes, rt_memclr_w.o(.text), UNUSED)

__rt_memclr_w (Thumb, 0 bytes, Stack size unknown bytes, rt_memclr_w.o(.text), UNUSED)

_memset_w (Thumb, 74 bytes, Stack size 4 bytes, rt_memclr_w.o(.text))

[Stack]

- Max Depth = 4
- Call Chain = _memset_w

[Called By]

- >> _memset

strcmp (Thumb, 124 bytes, Stack size 8 bytes, strcmpv8m_maindsp.o(.text))

[Stack]

- Max Depth = 8
- Call Chain = strcmp

[Called By]

- >> tflite::MicroMutableOpResolver⟨12u⟩::FindOp(char const*) const
- >> _get_lc_numeric
- >> _get_lc_ctype

__cpp_initialize__aeabi_ (Thumb, 28 bytes, Stack size 16 bytes, init_aeabi.o(.text))

[Stack]

- Max Depth = 16
- Call Chain = __cpp_initialize__aeabi_

[Called By]

- >> __rt_lib_init_cpp_2

_sys_exit (Thumb, 8 bytes, Stack size 0 bytes, sys_exit.o(.text))

[Called By]

- >> abort
- >> __rt_exit_exit
- >> __sig_exit

__rt_ctype_table (Thumb, 16 bytes, Stack size 8 bytes, rt_ctype_table.o(.text), UNUSED)

[Calls]

- >> __rt_locale

[Called By]

- >> _c32rtomb

__rt_heap_descriptor (Thumb, 8 bytes, Stack size 0 bytes, rt_heap_descriptor_intlibspace.o(.text))

[Called By]

- >> posix_memalign
- >> free
- >> malloc
- >> _init_alloc

__use_no_heap (Thumb, 2 bytes, Stack size 0 bytes, hguard.o(.text), UNUSED)

__heap$guard (Thumb, 2 bytes, Stack size 0 bytes, hguard.o(.text), UNUSED)

_terminate_user_alloc (Thumb, 2 bytes, Stack size 0 bytes, init_alloc.o(.text), UNUSED)

_init_user_alloc (Thumb, 2 bytes, Stack size 0 bytes, init_alloc.o(.text), UNUSED)

__Heap_Full (Thumb, 34 bytes, Stack size 16 bytes, init_alloc.o(.text))

[Stack]

- Max Depth = 32
- Call Chain = __Heap_Full ⇒ __Heap_ProvideMemory ⇒ free

[Calls]

- >> __Heap_ProvideMemory

[Called By]

- >> posix_memalign
- >> malloc

__Heap_Broken (Thumb, 6 bytes, Stack size 0 bytes, init_alloc.o(.text), UNUSED)

[Calls]

- >> __rt_SIGRTMEM

_init_alloc (Thumb, 94 bytes, Stack size 24 bytes, init_alloc.o(.text))

[Stack]

- Max Depth = 64
- Call Chain = _init_alloc ⇒ __rt_SIGRTMEM ⇒ __rt_SIGRTMEM_inner ⇒ __default_signal_display ⇒ _ttywrch

[Calls]

- >> __Heap_ProvideMemory
- >> __Heap_Initialize
- >> __rt_heap_descriptor
- >> __rt_SIGRTMEM

[Called By]

- >> __rt_lib_init_heap_2

__Heap_Initialize (Thumb, 10 bytes, Stack size 0 bytes, h1_init.o(.text))

[Called By]

- >> _init_alloc

__Heap_DescSize (Thumb, 4 bytes, Stack size 0 bytes, h1_init.o(.text), UNUSED)

__read_errno (Thumb, 10 bytes, Stack size 8 bytes, _rserrno.o(.text), UNUSED)

[Calls]

- >> __aeabi_errno_addr

__set_errno (Thumb, 12 bytes, Stack size 8 bytes, _rserrno.o(.text))

[Stack]

- Max Depth = 8
- Call Chain = __set_errno

[Calls]

- >> __aeabi_errno_addr

[Called By]

- >> __hardfp_expf

_printf_pre_padding (Thumb, 44 bytes, Stack size 16 bytes, _printf_pad.o(.text))

[Stack]

- Max Depth = 16
- Call Chain = _printf_pre_padding

[Called By]

- >> _printf_fp_hex_real
- >> _printf_fp_dec_real
- >> _printf_int_common
- >> _printf_wctomb
- >> _printf_str
- >> _printf_fp_infnan

_printf_post_padding (Thumb, 34 bytes, Stack size 16 bytes, _printf_pad.o(.text))

[Stack]

- Max Depth = 16
- Call Chain = _printf_post_padding

[Called By]

- >> _printf_fp_hex_real
- >> _printf_fp_dec_real
- >> _printf_int_common
- >> _printf_wctomb
- >> _printf_str
- >> _printf_fp_infnan

_printf_truncate_signed (Thumb, 18 bytes, Stack size 0 bytes, _printf_truncate.o(.text))

[Called By]

- >> _printf_int_dec

_printf_truncate_unsigned (Thumb, 18 bytes, Stack size 0 bytes, _printf_truncate.o(.text))

[Called By]

- >> _printf_int_hex
- >> _printf_int_oct
- >> _printf_int_dec

_printf_str (Thumb, 82 bytes, Stack size 16 bytes, _printf_str.o(.text))

[Stack]

- Max Depth = 32
- Call Chain = _printf_str ⇒ _printf_post_padding

[Calls]

- >> _printf_post_padding
- >> _printf_pre_padding

[Called By]

- >> _printf_cs_common

_printf_int_dec (Thumb, 104 bytes, Stack size 24 bytes, _printf_dec.o(.text))

[Stack]

- Max Depth = 72
- Call Chain = _printf_int_dec ⇒ _printf_int_common ⇒ _printf_post_padding

[Calls]

- >> _printf_int_common
- >> _printf_truncate_unsigned
- >> _printf_truncate_signed

[Called By]

- >> _printf_u
- >> _printf_d
- >> _printf_i

_printf_charcount (Thumb, 40 bytes, Stack size 0 bytes, _printf_charcount.o(.text))

[Called By]

- >> _printf_n

_printf_char_common (Thumb, 32 bytes, Stack size 64 bytes, _printf_char_common.o(.text))

[Stack]

- Max Depth = 104 + Unknown Stack Size
- Call Chain = _printf_char_common ⇒ __printf

[Calls]

- >> __printf

[Called By]

- >> vsnprintf

_snputc (Thumb, 16 bytes, Stack size 0 bytes, _snputc.o(.text))
[Address Reference Count : 1]

- vsnprintf.o(.text)

_printf_wctomb (Thumb, 182 bytes, Stack size 56 bytes, _printf_wctomb.o(.text))

[Stack]

- Max Depth = 80
- Call Chain = _printf_wctomb ⇒ _wcrtomb

[Calls]

- >> _printf_post_padding
- >> _printf_pre_padding
- >> _wcrtomb

[Called By]

- >> _printf_lcs_common

_printf_longlong_dec (Thumb, 108 bytes, Stack size 24 bytes, _printf_longlong_dec.o(.text))

[Stack]

- Max Depth = 72
- Call Chain = _printf_longlong_dec ⇒ _printf_int_common ⇒ _printf_post_padding

[Calls]

- >> _printf_int_common
- >> _ll_udiv10

[Called By]

- >> _printf_llu
- >> _printf_lld
- >> _printf_lli

_printf_longlong_oct (Thumb, 68 bytes, Stack size 8 bytes, _printf_oct_int_ll.o(.text))

[Stack]

- Max Depth = 56
- Call Chain = _printf_longlong_oct ⇒ _printf_int_common ⇒ _printf_post_padding

[Calls]

- >> _printf_int_common

[Called By]

- >> _printf_ll_oct
- >> _printf_int_oct

_printf_int_oct (Thumb, 24 bytes, Stack size 8 bytes, _printf_oct_int_ll.o(.text))

[Stack]

- Max Depth = 64
- Call Chain = _printf_int_oct ⇒ _printf_longlong_oct ⇒ _printf_int_common ⇒ _printf_post_padding

[Calls]

- >> _printf_longlong_oct
- >> _printf_truncate_unsigned

[Called By]

- >> _printf_o

_printf_ll_oct (Thumb, 12 bytes, Stack size 0 bytes, _printf_oct_int_ll.o(.text))

[Stack]

- Max Depth = 56
- Call Chain = _printf_ll_oct ⇒ _printf_longlong_oct ⇒ _printf_int_common ⇒ _printf_post_padding

[Calls]

- >> _printf_longlong_oct

[Called By]

- >> _printf_llo

_printf_longlong_hex (Thumb, 86 bytes, Stack size 16 bytes, _printf_hex_int_ll_ptr.o(.text))

[Stack]

- Max Depth = 64
- Call Chain = _printf_longlong_hex ⇒ _printf_int_common ⇒ _printf_post_padding

[Calls]

- >> _printf_int_common

[Called By]

- >> _printf_hex_ptr
- >> _printf_ll_hex
- >> _printf_int_hex

_printf_int_hex (Thumb, 28 bytes, Stack size 16 bytes, _printf_hex_int_ll_ptr.o(.text))

[Stack]

- Max Depth = 80
- Call Chain = _printf_int_hex ⇒ _printf_longlong_hex ⇒ _printf_int_common ⇒ _printf_post_padding

[Calls]

- >> _printf_longlong_hex
- >> _printf_truncate_unsigned

[Called By]

- >> _printf_x

_printf_ll_hex (Thumb, 12 bytes, Stack size 0 bytes, _printf_hex_int_ll_ptr.o(.text))

[Stack]

- Max Depth = 64
- Call Chain = _printf_ll_hex ⇒ _printf_longlong_hex ⇒ _printf_int_common ⇒ _printf_post_padding

[Calls]

- >> _printf_longlong_hex

[Called By]

- >> _printf_llx

_printf_hex_ptr (Thumb, 18 bytes, Stack size 0 bytes, _printf_hex_int_ll_ptr.o(.text))

[Stack]

- Max Depth = 64
- Call Chain = _printf_hex_ptr ⇒ _printf_longlong_hex ⇒ _printf_int_common ⇒ _printf_post_padding

[Calls]

- >> _printf_longlong_hex

[Called By]

- >> _printf_p

__printf (Thumb, 388 bytes, Stack size 40 bytes, __printf_flags_ss_wp.o(.text))

[Stack]

- Max Depth = 40 + Unknown Stack Size
- Call Chain = __printf

[Calls]

- >> _printf_percent
- >> _is_digit

[Called By]

- >> _printf_char_common

__aeabi_atexit (Thumb, 46 bytes, Stack size 24 bytes, aeabi_atexit.o(.text))

[Stack]

- Max Depth = 72
- Call Chain = __aeabi_atexit ⇒ malloc ⇒ __Heap_Full ⇒ __Heap_ProvideMemory ⇒ free

[Calls]

- >> malloc
- >> __rt_ddtor_pointer_addr

[Called By]

- >> __cxa_atexit

__rt_SIGABRT (Thumb, 14 bytes, Stack size 8 bytes, defsig_abrt_outer.o(.text))

[Stack]

- Max Depth = 40
- Call Chain = __rt_SIGABRT ⇒ __rt_SIGABRT_inner ⇒ __default_signal_display ⇒ _ttywrch

[Calls]

- >> __rt_SIGABRT_inner
- >> __sig_exit

[Called By]

- >> abort

__aeabi_memcpy (Thumb, 0 bytes, Stack size 0 bytes, rt_memcpy_v6.o(.text))

[Called By]

- >> memcpy

__rt_memcpy (Thumb, 138 bytes, Stack size 0 bytes, rt_memcpy_v6.o(.text), UNUSED)

[Calls]

- >> __aeabi_memcpy4

_memcpy_lastbytes (Thumb, 0 bytes, Stack size unknown bytes, rt_memcpy_v6.o(.text), UNUSED)

__aeabi_memcpy4 (Thumb, 0 bytes, Stack size 8 bytes, rt_memcpy_w.o(.text), UNUSED)

[Called By]

- >> __rt_memmove_w
- >> __rt_memcpy

__aeabi_memcpy8 (Thumb, 0 bytes, Stack size 8 bytes, rt_memcpy_w.o(.text), UNUSED)

__rt_memcpy_w (Thumb, 100 bytes, Stack size 8 bytes, rt_memcpy_w.o(.text), UNUSED)

_memcpy_lastbytes_aligned (Thumb, 0 bytes, Stack size unknown bytes, rt_memcpy_w.o(.text), UNUSED)

__aeabi_memclr (Thumb, 0 bytes, Stack size unknown bytes, rt_memclr.o(.text), UNUSED)

__rt_memclr (Thumb, 0 bytes, Stack size unknown bytes, rt_memclr.o(.text), UNUSED)

_memset (Thumb, 64 bytes, Stack size 0 bytes, rt_memclr.o(.text))

[Stack]

- Max Depth = 4
- Call Chain = _memset ⇒ _memset_w

[Calls]

- >> _memset_w

[Called By]

- >> memset

__I$use$semihosting (Thumb, 0 bytes, Stack size 0 bytes, use_no_semi.o(.text), UNUSED)

__use_no_semihosting_swi (Thumb, 2 bytes, Stack size 0 bytes, use_no_semi.o(.text), UNUSED)

__rt_locale (Thumb, 8 bytes, Stack size 0 bytes, rt_locale_intlibspace.o(.text))

[Called By]

- >> _printf_fp_dec_real
- >> __rt_lib_init_lc_common
- >> __rt_ctype_table

__semihosting_library_function (Thumb, 0 bytes, Stack size 0 bytes, indicate_semi.o(.text), UNUSED)

__rt_ddtor_pointer_addr (Thumb, 8 bytes, Stack size 0 bytes, rt_ddtor_pointer_addr_intlibspace.o(.text))

[Called By]

- >> __aeabi_atexit
- >> __cxa_finalize

__Heap_ProvideMemory (Thumb, 52 bytes, Stack size 0 bytes, h1_extend.o(.text))

[Stack]

- Max Depth = 16
- Call Chain = __Heap_ProvideMemory ⇒ free

[Calls]

- >> free

[Called By]

- >> _init_alloc
- >> __Heap_Full

_maybe_terminate_alloc (Thumb, 0 bytes, Stack size 0 bytes, maybetermalloc1.o(.text), UNUSED)

_ll_udiv10 (Thumb, 138 bytes, Stack size 12 bytes, lludiv10.o(.text))

[Stack]

- Max Depth = 12
- Call Chain = _ll_udiv10

[Called By]

- >> _printf_longlong_dec

_fp_trap (Thumb, 44 bytes, Stack size 40 bytes, _fptrap.o(.text))

[Stack]

- Max Depth = 80
- Call Chain = _fp_trap ⇒ __rt_SIGFPE ⇒ __rt_SIGFPE_inner ⇒ __default_signal_display ⇒ _ttywrch

[Calls]

- >> __rt_SIGFPE

[Called By]

- >> _fp_trapveneer

_printf_int_common (Thumb, 178 bytes, Stack size 32 bytes, _printf_intcommon.o(.text))

[Stack]

- Max Depth = 48
- Call Chain = _printf_int_common ⇒ _printf_post_padding

[Calls]

- >> _printf_post_padding
- >> _printf_pre_padding

[Called By]

- >> _printf_longlong_hex
- >> _printf_longlong_oct
- >> _printf_longlong_dec
- >> _printf_int_dec

_printf_fp_dec_real (Thumb, 618 bytes, Stack size 832 bytes, _printf_fp_dec_accurate.o(.text))

[Stack]

- Max Depth = 1968
- Call Chain = _printf_fp_dec_real ⇒ _fp_digits ⇒ _btod_main ⇒ _btod_common ⇒ _btod_pow ⇒ _btod_mul

[Calls]

- >> _fp_digits
- >> __rt_locale
- >> _printf_post_padding
- >> _printf_pre_padding
- >> __ARM_fpclassify
- >> _printf_fp_infnan

[Called By]

- >> _printf_fp_dec

_printf_fp_hex_real (Thumb, 756 bytes, Stack size 72 bytes, _printf_fp_hex.o(.text))

[Stack]

- Max Depth = 112
- Call Chain = _printf_fp_hex_real ⇒ _printf_fp_infnan ⇒ _printf_post_padding

[Calls]

- >> _printf_post_padding
- >> _printf_pre_padding
- >> __ARM_fpclassify
- >> __ieee_status
- >> _printf_fp_infnan

[Called By]

- >> _printf_fp_hex

_printf_cs_common (Thumb, 20 bytes, Stack size 8 bytes, _printf_char.o(.text))

[Stack]

- Max Depth = 40
- Call Chain = _printf_cs_common ⇒ _printf_str ⇒ _printf_post_padding

[Calls]

- >> _printf_str

[Called By]

- >> _printf_string
- >> _printf_char

_printf_char (Thumb, 16 bytes, Stack size 0 bytes, _printf_char.o(.text))

[Stack]

- Max Depth = 40
- Call Chain = _printf_char ⇒ _printf_cs_common ⇒ _printf_str ⇒ _printf_post_padding

[Calls]

- >> _printf_cs_common

[Called By]

- >> _printf_c

_printf_string (Thumb, 8 bytes, Stack size 0 bytes, _printf_char.o(.text))

[Stack]

- Max Depth = 40
- Call Chain = _printf_string ⇒ _printf_cs_common ⇒ _printf_str ⇒ _printf_post_padding

[Calls]

- >> _printf_cs_common

[Called By]

- >> _printf_s

_printf_lcs_common (Thumb, 20 bytes, Stack size 8 bytes, _printf_wchar.o(.text))

[Stack]

- Max Depth = 88
- Call Chain = _printf_lcs_common ⇒ _printf_wctomb ⇒ _wcrtomb

[Calls]

- >> _printf_wctomb

[Called By]

- >> _printf_wstring
- >> _printf_wchar

_printf_wchar (Thumb, 16 bytes, Stack size 0 bytes, _printf_wchar.o(.text))

[Stack]

- Max Depth = 88
- Call Chain = _printf_wchar ⇒ _printf_lcs_common ⇒ _printf_wctomb ⇒ _wcrtomb

[Calls]

- >> _printf_lcs_common

[Called By]

- >> _printf_lc

_printf_wstring (Thumb, 8 bytes, Stack size 0 bytes, _printf_wchar.o(.text))

[Stack]

- Max Depth = 88
- Call Chain = _printf_wstring ⇒ _printf_lcs_common ⇒ _printf_wctomb ⇒ _wcrtomb

[Calls]

- >> _printf_lcs_common

[Called By]

- >> _printf_ls

_c32rtomb (Thumb, 72 bytes, Stack size 24 bytes, _c32rtomb.o(.text), UNUSED)

[Calls]

- >> __rt_ctype_table

_wcrtomb (Thumb, 0 bytes, Stack size 24 bytes, _c32rtomb.o(.text))

[Stack]

- Max Depth = 24
- Call Chain = _wcrtomb

[Called By]

- >> _printf_wctomb

__cxa_finalize (Thumb, 66 bytes, Stack size 24 bytes, cxa_finalize.o(.text))

[Stack]

- Max Depth = 40
- Call Chain = __cxa_finalize ⇒ free

[Calls]

- >> free
- >> __rt_ddtor_pointer_addr

[Called By]

- >> __rt_lib_shutdown_cpp_2

__sig_exit (Thumb, 10 bytes, Stack size 0 bytes, defsig_exit.o(.text))

[Calls]

- >> _sys_exit

[Called By]

- >> __rt_SIGABRT
- >> __rt_SIGFPE
- >> __rt_SIGRTMEM

__rt_SIGABRT_inner (Thumb, 14 bytes, Stack size 8 bytes, defsig_abrt_inner.o(.text))

[Stack]

- Max Depth = 32
- Call Chain = __rt_SIGABRT_inner ⇒ __default_signal_display ⇒ _ttywrch

[Calls]

- >> __default_signal_display

[Called By]

- >> __rt_SIGABRT

__rt_SIGRTMEM (Thumb, 14 bytes, Stack size 8 bytes, defsig_rtmem_outer.o(.text))

[Stack]

- Max Depth = 40
- Call Chain = __rt_SIGRTMEM ⇒ __rt_SIGRTMEM_inner ⇒ __default_signal_display ⇒ _ttywrch

[Calls]

- >> __rt_SIGRTMEM_inner
- >> __sig_exit

[Called By]

- >> _init_alloc
- >> __Heap_Broken

_printf_fp_infnan (Thumb, 112 bytes, Stack size 24 bytes, _printf_fp_infnan.o(.text))

[Stack]

- Max Depth = 40
- Call Chain = _printf_fp_infnan ⇒ _printf_post_padding

[Calls]

- >> _printf_post_padding
- >> _printf_pre_padding

[Called By]

- >> _printf_fp_hex_real
- >> _printf_fp_dec_real

_btod_main (Thumb, 422 bytes, Stack size 832 bytes, btod_accurate.o(.text))

[Stack]

- Max Depth = 1056
- Call Chain = _btod_main ⇒ _btod_common ⇒ _btod_pow ⇒ _btod_mul

[Calls]

- >> _btod_common

[Called By]

- >> _fp_digits

exit (Thumb, 18 bytes, Stack size 8 bytes, exit.o(.text))

[Stack]

- Max Depth = 8 + Unknown Stack Size
- Call Chain = exit

[Calls]

- >> __rt_exit

[Called By]

- >> __rt_entry_main

__default_signal_display (Thumb, 50 bytes, Stack size 16 bytes, defsig_general.o(.text))

[Stack]

- Max Depth = 24
- Call Chain = __default_signal_display ⇒ _ttywrch

[Calls]

- >> _ttywrch

[Called By]

- >> __rt_SIGFPE_inner
- >> __rt_SIGRTMEM_inner
- >> __rt_SIGABRT_inner

__rt_SIGFPE (Thumb, 14 bytes, Stack size 8 bytes, defsig_fpe_outer.o(.text))

[Stack]

- Max Depth = 40
- Call Chain = __rt_SIGFPE ⇒ __rt_SIGFPE_inner ⇒ __default_signal_display ⇒ _ttywrch

[Calls]

- >> __rt_SIGFPE_inner
- >> __sig_exit

[Called By]

- >> _fp_trap

__rt_SIGRTMEM_inner (Thumb, 22 bytes, Stack size 8 bytes, defsig_rtmem_inner.o(.text))

[Stack]

- Max Depth = 32
- Call Chain = __rt_SIGRTMEM_inner ⇒ __default_signal_display ⇒ _ttywrch

[Calls]

- >> __default_signal_display

[Called By]

- >> __rt_SIGRTMEM

_ttywrch (Thumb, 14 bytes, Stack size 8 bytes, sys_wrch.o(.text))

[Stack]

- Max Depth = 8
- Call Chain = _ttywrch

[Called By]

- >> __default_signal_display

_btod_approx_div10000 (Thumb, 20 bytes, Stack size 0 bytes, btod_accurate_common.o(.text))

[Called By]

- >> _btod_common
- >> _btod_mul

_btod_mul (Thumb, 120 bytes, Stack size 56 bytes, btod_accurate_common.o(.text))

[Stack]

- Max Depth = 56
- Call Chain = _btod_mul

[Calls]

- >> _btod_approx_div10000

[Called By]

- >> _btod_common
- >> _btod_pow

_btod_pow (Thumb, 332 bytes, Stack size 80 bytes, btod_accurate_common.o(.text))

[Stack]

- Max Depth = 136
- Call Chain = _btod_pow ⇒ _btod_mul

[Calls]

- >> _btod_mul

[Called By]

- >> _btod_common

_bcd2digits (Thumb, 88 bytes, Stack size 28 bytes, btod_accurate_common.o(.text))

[Stack]

- Max Depth = 28
- Call Chain = _bcd2digits

[Called By]

- >> _btod_common

_btod_common (Thumb, 238 bytes, Stack size 88 bytes, btod_accurate_common.o(.text))

[Stack]

- Max Depth = 224
- Call Chain = _btod_common ⇒ _btod_pow ⇒ _btod_mul

[Calls]

- >> __aeabi_llsr
- >> _bcd2digits
- >> _btod_pow
- >> _btod_mul
- >> _btod_approx_div10000

[Called By]

- >> _btod_main

__rt_SIGFPE_inner (Thumb, 62 bytes, Stack size 8 bytes, defsig_fpe_inner.o(.text))

[Stack]

- Max Depth = 32
- Call Chain = __rt_SIGFPE_inner ⇒ __default_signal_display ⇒ _ttywrch

[Calls]

- >> __default_signal_display

[Called By]

- >> __rt_SIGFPE

__aeabi_llsr (Thumb, 0 bytes, Stack size 0 bytes, llushr.o(.text))

[Called By]

- >> _btod_common

_ll_ushift_r (Thumb, 38 bytes, Stack size 0 bytes, llushr.o(.text), UNUSED)

Abs (Thumb, 288 bytes, Stack size unknown bytes, NeutronKernels.c.o(.text.Abs))

[Calls]

- >> EXEC

[Called By]

- >> CallKernel

Activation (Thumb, 464 bytes, Stack size unknown bytes, NeutronKernels.c.o(.text.Activation))

[Calls]

- >> EXEC

[Called By]

- >> CallKernel

Add (Thumb, 918 bytes, Stack size unknown bytes, NeutronKernels.c.o(.text.Add))

[Calls]

- >> EXEC

[Called By]

- >> CallKernel

BOARD_BootClockPLL150M (Thumb, 236 bytes, Stack size 56 bytes, clock_config.o(.text.BOARD_BootClockPLL150M))

[Stack]

- Max Depth = 192
- Call Chain = BOARD_BootClockPLL150M ⇒ SPC_SetActiveModeCoreLDORegulatorConfig ⇒ __aeabi_assert ⇒ DbgConsole_Printf ⇒ DbgConsole_Vprintf ⇒ memcpy

[Calls]

- >> CLOCK_SetClkDiv
- >> CLOCK_SetPll0MonitorMode
- >> CLOCK_SetPLL0Freq
- >> CLOCK_SetupFROHFClocking
- >> SPC_SetActiveModeCoreLDORegulatorConfig
- >> CLOCK_SetFLASHAccessCyclesForFreq
- >> CLOCK_AttachClk
- >> SPC_SetSRAMOperateVoltage
- >> SPC_SetActiveModeDCDCRegulatorConfig

[Called By]

- >> BOARD_InitBootClocks

BOARD_InitBootClocks (Thumb, 4 bytes, Stack size 0 bytes, clock_config.o(.text.BOARD_InitBootClocks))

[Stack]

- Max Depth = 192
- Call Chain = BOARD_InitBootClocks ⇒ BOARD_BootClockPLL150M ⇒ SPC_SetActiveModeCoreLDORegulatorConfig ⇒ __aeabi_assert ⇒ DbgConsole_Printf ⇒ DbgConsole_Vprintf ⇒ memcpy

[Calls]

- >> BOARD_BootClockPLL150M

[Called By]

- >> zf_board_init

BOARD_PowerMode_OD (Thumb, 48 bytes, Stack size 16 bytes, board.o(.text.BOARD_PowerMode_OD))

[Stack]

- Max Depth = 152
- Call Chain = BOARD_PowerMode_OD ⇒ SPC_SetSRAMOperateVoltage ⇒ __aeabi_assert ⇒ DbgConsole_Printf ⇒ DbgConsole_Vprintf ⇒ memcpy

[Calls]

- >> SPC_SetSRAMOperateVoltage
- >> SPC_SetActiveModeDCDCRegulatorConfig

[Called By]

- >> zf_board_init

BOARD_SDCardGetDetectStatus (Thumb, 36 bytes, Stack size 16 bytes, sdmmc_config.o(.text.BOARD_SDCardGetDetectStatus))

[Stack]

- Max Depth = 152
- Call Chain = BOARD_SDCardGetDetectStatus ⇒ HAL_GpioGetInput ⇒ __aeabi_assert ⇒ DbgConsole_Printf ⇒ DbgConsole_Vprintf ⇒ memcpy

[Calls]

- >> HAL_GpioGetInput

[Address Reference Count : 1]

- sdmmc_config.o(.text.BOARD_SD_Config)

BOARD_SDCardPowerControl (Thumb, 16 bytes, Stack size 0 bytes, sdmmc_config.o(.text.BOARD_SDCardPowerControl))

[Stack]

- Max Depth = 136
- Call Chain = BOARD_SDCardPowerControl ⇒ HAL_GpioSetOutput ⇒ __aeabi_assert ⇒ DbgConsole_Printf ⇒ DbgConsole_Vprintf ⇒ memcpy

[Calls]

- >> HAL_GpioSetOutput

[Address Reference Count : 1]

- sdmmc_config.o(.text.BOARD_SD_Config)

BOARD_SD_Config (Thumb, 268 bytes, Stack size 40 bytes, sdmmc_config.o(.text.BOARD_SD_Config))

[Stack]

- Max Depth = 192
- Call Chain = BOARD_SD_Config ⇒ HAL_GpioInit ⇒ GPIO_PinInit ⇒ __aeabi_assert ⇒ DbgConsole_Printf ⇒ DbgConsole_Vprintf ⇒ memcpy

[Calls]

- >> __aeabi_assert
- >> HAL_GpioInstallCallback
- >> HAL_GpioSetTriggerMode
- >> HAL_GpioInit
- >> HAL_GpioGetInput
- >> CLOCK_GetUsdhcClkFreq
- >> CLOCK_SetClkDiv
- >> CLOCK_AttachClk

[Called By]

- >> sd_card_init

BatchMulAdd (Thumb, 456 bytes, Stack size unknown bytes, NeutronKernels.c.o(.text.BatchMulAdd))

[Calls]

- >> EXEC

[Called By]

- >> CallKernel

BitTransformation (Thumb, 460 bytes, Stack size unknown bytes, NeutronKernels.c.o(.text.BitTransformation))

[Calls]

- >> EXEC

[Called By]

- >> CastInt16ToInt8
- >> CastInt8ToInt16

CLOCK_AttachClk (Thumb, 118 bytes, Stack size 20 bytes, fsl_clock.o(.text.CLOCK_AttachClk))

[Stack]

- Max Depth = 20
- Call Chain = CLOCK_AttachClk

[Called By]

- >> BOARD_SD_Config
- >> debug_uart_init
- >> BOARD_BootClockPLL150M
- >> ips200_init
- >> sd_card_init
- >> user_uart_init

CLOCK_GetLPFlexCommClkFreq (Thumb, 272 bytes, Stack size 16 bytes, fsl_clock.o(.text.CLOCK_GetLPFlexCommClkFreq))

[Stack]

- Max Depth = 72
- Call Chain = CLOCK_GetLPFlexCommClkFreq ⇒ CLOCK_GetPll1OutFreq ⇒ __aeabi_f2ulz

[Calls]

- >> CLOCK_GetPll1OutFreq
- >> CLOCK_GetPll0OutFreq

[Called By]

- >> debug_uart_init
- >> ips200_init
- >> user_uart_init

CLOCK_GetPll0OutFreq (Thumb, 320 bytes, Stack size 40 bytes, fsl_clock.o(.text.CLOCK_GetPll0OutFreq))

[Stack]

- Max Depth = 56
- Call Chain = CLOCK_GetPll0OutFreq ⇒ __aeabi_f2ulz

[Calls]

- >> __aeabi_f2ulz

[Called By]

- >> CLOCK_GetUsdhcClkFreq
- >> CLOCK_GetLPFlexCommClkFreq
- >> CLOCK_SetPLL0Freq

CLOCK_GetPll1OutFreq (Thumb, 320 bytes, Stack size 40 bytes, fsl_clock.o(.text.CLOCK_GetPll1OutFreq))

[Stack]

- Max Depth = 56
- Call Chain = CLOCK_GetPll1OutFreq ⇒ __aeabi_f2ulz

[Calls]

- >> __aeabi_f2ulz

[Called By]

- >> CLOCK_GetUsdhcClkFreq
- >> CLOCK_GetLPFlexCommClkFreq

CLOCK_GetUsdhcClkFreq (Thumb, 176 bytes, Stack size 8 bytes, fsl_clock.o(.text.CLOCK_GetUsdhcClkFreq))

[Stack]

- Max Depth = 64
- Call Chain = CLOCK_GetUsdhcClkFreq ⇒ CLOCK_GetPll1OutFreq ⇒ __aeabi_f2ulz

[Calls]

- >> CLOCK_GetPll1OutFreq
- >> CLOCK_GetPll0OutFreq

[Called By]

- >> BOARD_SD_Config

CLOCK_SetClkDiv (Thumb, 32 bytes, Stack size 0 bytes, fsl_clock.o(.text.CLOCK_SetClkDiv))

[Called By]

- >> BOARD_SD_Config
- >> debug_uart_init
- >> BOARD_BootClockPLL150M
- >> ips200_init
- >> sd_card_init
- >> user_uart_init

CLOCK_SetFLASHAccessCyclesForFreq (Thumb, 150 bytes, Stack size 0 bytes, fsl_clock.o(.text.CLOCK_SetFLASHAccessCyclesForFreq))

[Called By]

- >> BOARD_BootClockPLL150M

CLOCK_SetPLL0Freq (Thumb, 308 bytes, Stack size 8 bytes, fsl_clock.o(.text.CLOCK_SetPLL0Freq))

[Stack]

- Max Depth = 64
- Call Chain = CLOCK_SetPLL0Freq ⇒ CLOCK_GetPll0OutFreq ⇒ __aeabi_f2ulz

[Calls]

- >> CLOCK_GetPll0OutFreq

[Called By]

- >> BOARD_BootClockPLL150M

CLOCK_SetPll0MonitorMode (Thumb, 20 bytes, Stack size 0 bytes, fsl_clock.o(.text.CLOCK_SetPll0MonitorMode))

[Called By]

- >> BOARD_BootClockPLL150M

CLOCK_SetupClk16KClocking (Thumb, 54 bytes, Stack size 0 bytes, fsl_clock.o(.text.CLOCK_SetupClk16KClocking))

[Called By]

- >> system_delay_init

CLOCK_SetupFROHFClocking (Thumb, 86 bytes, Stack size 0 bytes, fsl_clock.o(.text.CLOCK_SetupFROHFClocking))

[Called By]

- >> BOARD_BootClockPLL150M

CTIMER0_DriverIRQHandler (Thumb, 98 bytes, Stack size 16 bytes, fsl_ctimer.o(.text.CTIMER0_DriverIRQHandler))

[Stack]

- Max Depth = 16
- Call Chain = CTIMER0_DriverIRQHandler

[Address Reference Count : 1]

- startup_mcxn947_cm33_core0.o(.text)

CTIMER1_DriverIRQHandler (Thumb, 98 bytes, Stack size 16 bytes, fsl_ctimer.o(.text.CTIMER1_DriverIRQHandler))

[Stack]

- Max Depth = 16
- Call Chain = CTIMER1_DriverIRQHandler

[Address Reference Count : 1]

- startup_mcxn947_cm33_core0.o(.text)

CTIMER2_DriverIRQHandler (Thumb, 98 bytes, Stack size 16 bytes, fsl_ctimer.o(.text.CTIMER2_DriverIRQHandler))

[Stack]

- Max Depth = 16
- Call Chain = CTIMER2_DriverIRQHandler

[Address Reference Count : 1]

- startup_mcxn947_cm33_core0.o(.text)

CTIMER3_DriverIRQHandler (Thumb, 98 bytes, Stack size 16 bytes, fsl_ctimer.o(.text.CTIMER3_DriverIRQHandler))

[Stack]

- Max Depth = 16
- Call Chain = CTIMER3_DriverIRQHandler

[Address Reference Count : 1]

- startup_mcxn947_cm33_core0.o(.text)

CTIMER4_DriverIRQHandler (Thumb, 94 bytes, Stack size 16 bytes, fsl_ctimer.o(.text.CTIMER4_DriverIRQHandler))

[Stack]

- Max Depth = 16
- Call Chain = CTIMER4_DriverIRQHandler

[Address Reference Count : 1]

- startup_mcxn947_cm33_core0.o(.text)

CallKernel (Thumb, 194 bytes, Stack size unknown bytes, NeutronKernels.c.o(.text.CallKernel))

[Calls]

- >> MirrorPad
- >> Sequence
- >> MemCpy
- >> Slice
- >> Conv2DAtrous
- >> Activation
- >> Abs
- >> Add
- >> Pad
- >> FullyConnected
- >> GlobalAvgPool
- >> GlobalMaxPool
- >> MaxPool
- >> CastInt16ToInt8
- >> CastInt8ToInt16
- >> MulInt16
- >> BatchMulAdd
- >> Upsample2DV1
- >> Conv2DPointwise
- >> Conv1DStandard
- >> Conv2DDepthwiseV2
- >> Conv2DDepthwiseV1
- >> Conv2DDepthwiseNeutron16x16Kernel3x3
- >> Conv2DStandardV3
- >> Conv2DStandardV2
- >> Conv2DStandardV1

[Called By]

- >> CallKernelWrapper

CallKernelWrapper (Thumb, 4 bytes, Stack size unknown bytes, NeutronFirmwarePrivate.c.o(.text.CallKernelWrapper))

[Calls]

- >> CallKernel

[Called By]

- >> neutronFwInterpreter

CastInt16ToInt8 (Thumb, 6 bytes, Stack size unknown bytes, NeutronKernels.c.o(.text.CastInt16ToInt8))

[Calls]

- >> BitTransformation

[Called By]

- >> CallKernel

CastInt8ToInt16 (Thumb, 6 bytes, Stack size unknown bytes, NeutronKernels.c.o(.text.CastInt8ToInt16))

[Calls]

- >> BitTransformation

[Called By]

- >> CallKernel

Conv1DStandard (Thumb, 708 bytes, Stack size unknown bytes, NeutronKernels.c.o(.text.Conv1DStandard))

[Calls]

- >> EXEC

[Called By]

- >> CallKernel

Conv2DAtrous (Thumb, 720 bytes, Stack size unknown bytes, NeutronKernels.c.o(.text.Conv2DAtrous))

[Calls]

- >> EXEC

[Called By]

- >> CallKernel

Conv2DDepthwiseNeutron16x16Kernel3x3 (Thumb, 2358 bytes, Stack size unknown bytes, NeutronKernels.c.o(.text.Conv2DDepthwiseNeutron16x16Kernel3x3))

[Calls]

- >> EXEC

[Called By]

- >> CallKernel

Conv2DDepthwiseV1 (Thumb, 2072 bytes, Stack size unknown bytes, NeutronKernels.c.o(.text.Conv2DDepthwiseV1))

[Calls]

- >> EXEC

[Called By]

- >> CallKernel

Conv2DDepthwiseV2 (Thumb, 816 bytes, Stack size unknown bytes, NeutronKernels.c.o(.text.Conv2DDepthwiseV2))

[Calls]

- >> EXEC

[Called By]

- >> CallKernel

Conv2DPointwise (Thumb, 888 bytes, Stack size unknown bytes, NeutronKernels.c.o(.text.Conv2DPointwise))

[Calls]

- >> EXEC

[Called By]

- >> CallKernel

Conv2DStandardV1 (Thumb, 2192 bytes, Stack size unknown bytes, NeutronKernels.c.o(.text.Conv2DStandardV1))

[Calls]

- >> EXEC

[Called By]

- >> CallKernel

Conv2DStandardV2 (Thumb, 1248 bytes, Stack size unknown bytes, NeutronKernels.c.o(.text.Conv2DStandardV2))

[Calls]

- >> EXEC

[Called By]

- >> CallKernel

Conv2DStandardV3 (Thumb, 2376 bytes, Stack size unknown bytes, NeutronKernels.c.o(.text.Conv2DStandardV3))

[Calls]

- >> EXEC

[Called By]

- >> CallKernel

DbgConsole_Printf (Thumb, 32 bytes, Stack size 24 bytes, fsl_debug_console.o(.text.DbgConsole_Printf))

[Stack]

- Max Depth = 136
- Call Chain = DbgConsole_Printf ⇒ DbgConsole_Vprintf ⇒ memcpy

[Calls]

- >> DbgConsole_Vprintf

[Called By]

- >> __aeabi_assert
- >> MODEL_RunInference
- >> MODEL_Init

DbgConsole_Vprintf (Thumb, 1038 bytes, Stack size 104 bytes, fsl_debug_console.o(.text.DbgConsole_Vprintf))

[Stack]

- Max Depth = 112
- Call Chain = DbgConsole_Vprintf ⇒ memcpy

[Calls]

- >> memcpy
- >> strlen

[Called By]

- >> DbgConsole_Printf

DebugLog (Thumb, 30 bytes, Stack size unknown bytes, debug_log.o(.text.DebugLog))

[Stack]

- Max Depth = 128 + Unknown Stack Size
- Call Chain = DebugLog ⇒ vsnprintf ⇒ _printf_char_common ⇒ __printf

[Calls]

- >> InvokeDebugLogCallback
- >> vsnprintf

[Called By]

- >> (anonymous namespace)::VDebugLog(char const*, ...) (.constprop.0)
- >> VMicroPrintf(char const*, std::__va_list)

EDMA_0_CH0_DriverIRQHandler (Thumb, 8 bytes, Stack size 0 bytes, fsl_edma_soc.o(.text.EDMA_0_CH0_DriverIRQHandler))

[Stack]

- Max Depth = 152
- Call Chain = EDMA_0_CH0_DriverIRQHandler ⇒ EDMA_DriverIRQHandler ⇒ EDMA_HandleIRQ ⇒ __aeabi_assert ⇒ DbgConsole_Printf ⇒ DbgConsole_Vprintf ⇒ memcpy

[Calls]

- >> EDMA_DriverIRQHandler

[Address Reference Count : 1]

- startup_mcxn947_cm33_core0.o(.text)

EDMA_0_CH10_DriverIRQHandler (Thumb, 8 bytes, Stack size 0 bytes, fsl_edma_soc.o(.text.EDMA_0_CH10_DriverIRQHandler))

[Stack]

- Max Depth = 152
- Call Chain = EDMA_0_CH10_DriverIRQHandler ⇒ EDMA_DriverIRQHandler ⇒ EDMA_HandleIRQ ⇒ __aeabi_assert ⇒ DbgConsole_Printf ⇒ DbgConsole_Vprintf ⇒ memcpy

[Calls]

- >> EDMA_DriverIRQHandler

[Address Reference Count : 1]

- startup_mcxn947_cm33_core0.o(.text)

EDMA_0_CH11_DriverIRQHandler (Thumb, 8 bytes, Stack size 0 bytes, fsl_edma_soc.o(.text.EDMA_0_CH11_DriverIRQHandler))

[Stack]

- Max Depth = 152
- Call Chain = EDMA_0_CH11_DriverIRQHandler ⇒ EDMA_DriverIRQHandler ⇒ EDMA_HandleIRQ ⇒ __aeabi_assert ⇒ DbgConsole_Printf ⇒ DbgConsole_Vprintf ⇒ memcpy

[Calls]

- >> EDMA_DriverIRQHandler

[Address Reference Count : 1]

- startup_mcxn947_cm33_core0.o(.text)

EDMA_0_CH12_DriverIRQHandler (Thumb, 8 bytes, Stack size 0 bytes, fsl_edma_soc.o(.text.EDMA_0_CH12_DriverIRQHandler))

[Stack]

- Max Depth = 152
- Call Chain = EDMA_0_CH12_DriverIRQHandler ⇒ EDMA_DriverIRQHandler ⇒ EDMA_HandleIRQ ⇒ __aeabi_assert ⇒ DbgConsole_Printf ⇒ DbgConsole_Vprintf ⇒ memcpy

[Calls]

- >> EDMA_DriverIRQHandler

[Address Reference Count : 1]

- startup_mcxn947_cm33_core0.o(.text)

EDMA_0_CH13_DriverIRQHandler (Thumb, 8 bytes, Stack size 0 bytes, fsl_edma_soc.o(.text.EDMA_0_CH13_DriverIRQHandler))

[Stack]

- Max Depth = 152
- Call Chain = EDMA_0_CH13_DriverIRQHandler ⇒ EDMA_DriverIRQHandler ⇒ EDMA_HandleIRQ ⇒ __aeabi_assert ⇒ DbgConsole_Printf ⇒ DbgConsole_Vprintf ⇒ memcpy

[Calls]

- >> EDMA_DriverIRQHandler

[Address Reference Count : 1]

- startup_mcxn947_cm33_core0.o(.text)

EDMA_0_CH14_DriverIRQHandler (Thumb, 8 bytes, Stack size 0 bytes, fsl_edma_soc.o(.text.EDMA_0_CH14_DriverIRQHandler))

[Stack]

- Max Depth = 152
- Call Chain = EDMA_0_CH14_DriverIRQHandler ⇒ EDMA_DriverIRQHandler ⇒ EDMA_HandleIRQ ⇒ __aeabi_assert ⇒ DbgConsole_Printf ⇒ DbgConsole_Vprintf ⇒ memcpy

[Calls]

- >> EDMA_DriverIRQHandler

[Address Reference Count : 1]

- startup_mcxn947_cm33_core0.o(.text)

EDMA_0_CH15_DriverIRQHandler (Thumb, 8 bytes, Stack size 0 bytes, fsl_edma_soc.o(.text.EDMA_0_CH15_DriverIRQHandler))

[Stack]

- Max Depth = 152
- Call Chain = EDMA_0_CH15_DriverIRQHandler ⇒ EDMA_DriverIRQHandler ⇒ EDMA_HandleIRQ ⇒ __aeabi_assert ⇒ DbgConsole_Printf ⇒ DbgConsole_Vprintf ⇒ memcpy

[Calls]

- >> EDMA_DriverIRQHandler

[Address Reference Count : 1]

- startup_mcxn947_cm33_core0.o(.text)

EDMA_0_CH1_DriverIRQHandler (Thumb, 8 bytes, Stack size 0 bytes, fsl_edma_soc.o(.text.EDMA_0_CH1_DriverIRQHandler))

[Stack]

- Max Depth = 152
- Call Chain = EDMA_0_CH1_DriverIRQHandler ⇒ EDMA_DriverIRQHandler ⇒ EDMA_HandleIRQ ⇒ __aeabi_assert ⇒ DbgConsole_Printf ⇒ DbgConsole_Vprintf ⇒ memcpy

[Calls]

- >> EDMA_DriverIRQHandler

[Address Reference Count : 1]

- startup_mcxn947_cm33_core0.o(.text)

EDMA_0_CH2_DriverIRQHandler (Thumb, 8 bytes, Stack size 0 bytes, fsl_edma_soc.o(.text.EDMA_0_CH2_DriverIRQHandler))

[Stack]

- Max Depth = 152
- Call Chain = EDMA_0_CH2_DriverIRQHandler ⇒ EDMA_DriverIRQHandler ⇒ EDMA_HandleIRQ ⇒ __aeabi_assert ⇒ DbgConsole_Printf ⇒ DbgConsole_Vprintf ⇒ memcpy

[Calls]

- >> EDMA_DriverIRQHandler

[Address Reference Count : 1]

- startup_mcxn947_cm33_core0.o(.text)

EDMA_0_CH3_DriverIRQHandler (Thumb, 8 bytes, Stack size 0 bytes, fsl_edma_soc.o(.text.EDMA_0_CH3_DriverIRQHandler))

[Stack]

- Max Depth = 152
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

EDMA_1_CH5_DriverIRQHandler (Thumb, 8 bytes, Stack size 0 bytes, fsl_edma_soc.o(.text.EDMA_1_CH5_DriverIRQHandler))

[Stack]

- Max Depth = 152
- Call Chain = EDMA_1_CH5_DriverIRQHandler ⇒ EDMA_DriverIRQHandler ⇒ EDMA_HandleIRQ ⇒ __aeabi_assert ⇒ DbgConsole_Printf ⇒ DbgConsole_Vprintf ⇒ memcpy

[Calls]

- >> EDMA_DriverIRQHandler

[Address Reference Count : 1]

- startup_mcxn947_cm33_core0.o(.text)

EDMA_1_CH6_DriverIRQHandler (Thumb, 8 bytes, Stack size 0 bytes, fsl_edma_soc.o(.text.EDMA_1_CH6_DriverIRQHandler))

[Stack]

- Max Depth = 152
- Call Chain = EDMA_1_CH6_DriverIRQHandler ⇒ EDMA_DriverIRQHandler ⇒ EDMA_HandleIRQ ⇒ __aeabi_assert ⇒ DbgConsole_Printf ⇒ DbgConsole_Vprintf ⇒ memcpy

[Calls]

- >> EDMA_DriverIRQHandler

[Address Reference Count : 1]

- startup_mcxn947_cm33_core0.o(.text)

EDMA_1_CH7_DriverIRQHandler (Thumb, 8 bytes, Stack size 0 bytes, fsl_edma_soc.o(.text.EDMA_1_CH7_DriverIRQHandler))

[Stack]

- Max Depth = 152
- Call Chain = EDMA_1_CH7_DriverIRQHandler ⇒ EDMA_DriverIRQHandler ⇒ EDMA_HandleIRQ ⇒ __aeabi_assert ⇒ DbgConsole_Printf ⇒ DbgConsole_Vprintf ⇒ memcpy

[Calls]

- >> EDMA_DriverIRQHandler

[Address Reference Count : 1]

- startup_mcxn947_cm33_core0.o(.text)

EDMA_1_CH8_DriverIRQHandler (Thumb, 8 bytes, Stack size 0 bytes, fsl_edma_soc.o(.text.EDMA_1_CH8_DriverIRQHandler))

[Stack]

- Max Depth = 152
- Call Chain = EDMA_1_CH8_DriverIRQHandler ⇒ EDMA_DriverIRQHandler ⇒ EDMA_HandleIRQ ⇒ __aeabi_assert ⇒ DbgConsole_Printf ⇒ DbgConsole_Vprintf ⇒ memcpy

[Calls]

- >> EDMA_DriverIRQHandler

[Address Reference Count : 1]

- startup_mcxn947_cm33_core0.o(.text)

EDMA_1_CH9_DriverIRQHandler (Thumb, 8 bytes, Stack size 0 bytes, fsl_edma_soc.o(.text.EDMA_1_CH9_DriverIRQHandler))

[Stack]

- Max Depth = 152
- Call Chain = EDMA_1_CH9_DriverIRQHandler ⇒ EDMA_DriverIRQHandler ⇒ EDMA_HandleIRQ ⇒ __aeabi_assert ⇒ DbgConsole_Printf ⇒ DbgConsole_Vprintf ⇒ memcpy

[Calls]

- >> EDMA_DriverIRQHandler

[Address Reference Count : 1]

- startup_mcxn947_cm33_core0.o(.text)

EDMA_ConfigChannelSoftwareTCD (Thumb, 598 bytes, Stack size 32 bytes, fsl_edma.o(.text.EDMA_ConfigChannelSoftwareTCD))

[Stack]

- Max Depth = 168
- Call Chain = EDMA_ConfigChannelSoftwareTCD ⇒ __aeabi_assert ⇒ DbgConsole_Printf ⇒ DbgConsole_Vprintf ⇒ memcpy

[Calls]

- >> __aeabi_assert

[Called By]

- >> EDMA_TcdSetTransferConfig
- >> EDMA_SetTransferConfig

EDMA_CreateHandle (Thumb, 224 bytes, Stack size 24 bytes, fsl_edma.o(.text.EDMA_CreateHandle))

[Stack]

- Max Depth = 160
- Call Chain = EDMA_CreateHandle ⇒ __aeabi_assert ⇒ DbgConsole_Printf ⇒ DbgConsole_Vprintf ⇒ memcpy

[Calls]

- >> __aeabi_assert
- >> memset

[Called By]

- >> ips200_init

EDMA_DriverIRQHandler (Thumb, 48 bytes, Stack size 0 bytes, fsl_edma.o(.text.EDMA_DriverIRQHandler))

[Stack]

- Max Depth = 152
- Call Chain = EDMA_DriverIRQHandler ⇒ EDMA_HandleIRQ ⇒ __aeabi_assert ⇒ DbgConsole_Printf ⇒ DbgConsole_Vprintf ⇒ memcpy

[Calls]

- >> EDMA_HandleIRQ

[Called By]

- >> EDMA_1_CH15_DriverIRQHandler
- >> EDMA_1_CH14_DriverIRQHandler
- >> EDMA_1_CH13_DriverIRQHandler
- >> EDMA_1_CH12_DriverIRQHandler
- >> EDMA_1_CH11_DriverIRQHandler
- >> EDMA_1_CH10_DriverIRQHandler
- >> EDMA_1_CH9_DriverIRQHandler
- >> EDMA_1_CH8_DriverIRQHandler
- >> EDMA_1_CH7_DriverIRQHandler
- >> EDMA_1_CH6_DriverIRQHandler
- >> EDMA_1_CH5_DriverIRQHandler
- >> EDMA_1_CH4_DriverIRQHandler
- >> EDMA_1_CH3_DriverIRQHandler
- >> EDMA_1_CH2_DriverIRQHandler
- >> EDMA_1_CH1_DriverIRQHandler
- >> EDMA_1_CH0_DriverIRQHandler
- >> EDMA_0_CH15_DriverIRQHandler
- >> EDMA_0_CH14_DriverIRQHandler
- >> EDMA_0_CH13_DriverIRQHandler
- >> EDMA_0_CH12_DriverIRQHandler
- >> EDMA_0_CH11_DriverIRQHandler
- >> EDMA_0_CH10_DriverIRQHandler
- >> EDMA_0_CH9_DriverIRQHandler
- >> EDMA_0_CH8_DriverIRQHandler
- >> EDMA_0_CH7_DriverIRQHandler
- >> EDMA_0_CH6_DriverIRQHandler
- >> EDMA_0_CH5_DriverIRQHandler
- >> EDMA_0_CH4_DriverIRQHandler
- >> EDMA_0_CH3_DriverIRQHandler
- >> EDMA_0_CH2_DriverIRQHandler
- >> EDMA_0_CH1_DriverIRQHandler
- >> EDMA_0_CH0_DriverIRQHandler

EDMA_EnableChannelInterrupts (Thumb, 102 bytes, Stack size 8 bytes, fsl_edma.o(.text.EDMA_EnableChannelInterrupts))

[Stack]

- Max Depth = 144
- Call Chain = EDMA_EnableChannelInterrupts ⇒ __aeabi_assert ⇒ DbgConsole_Printf ⇒ DbgConsole_Vprintf ⇒ memcpy

[Calls]

- >> __aeabi_assert

[Called By]

- >> LPSPI_MasterTransferEDMALite

EDMA_GetDefaultConfig (Thumb, 54 bytes, Stack size 16 bytes, fsl_edma.o(.text.EDMA_GetDefaultConfig))

[Stack]

- Max Depth = 152
- Call Chain = EDMA_GetDefaultConfig ⇒ __aeabi_assert ⇒ DbgConsole_Printf ⇒ DbgConsole_Vprintf ⇒ memcpy

[Calls]

- >> __aeabi_assert
- >> memset

[Called By]

- >> ips200_init

EDMA_HandleIRQ (Thumb, 222 bytes, Stack size 16 bytes, fsl_edma.o(.text.EDMA_HandleIRQ))

[Stack]

- Max Depth = 152
- Call Chain = EDMA_HandleIRQ ⇒ __aeabi_assert ⇒ DbgConsole_Printf ⇒ DbgConsole_Vprintf ⇒ memcpy

[Calls]

- >> __aeabi_assert

[Called By]

- >> EDMA_DriverIRQHandler

EDMA_Init (Thumb, 316 bytes, Stack size 16 bytes, fsl_edma.o(.text.EDMA_Init))

[Stack]

- Max Depth = 160
- Call Chain = EDMA_Init ⇒ EDMA_InitChannel ⇒ __aeabi_assert ⇒ DbgConsole_Printf ⇒ DbgConsole_Vprintf ⇒ memcpy

[Calls]

- >> __aeabi_assert
- >> EDMA_InitChannel
- >> RESET_ClearPeripheralReset

[Called By]

- >> ips200_init

EDMA_InitChannel (Thumb, 156 bytes, Stack size 8 bytes, fsl_edma.o(.text.EDMA_InitChannel))

[Stack]

- Max Depth = 144
- Call Chain = EDMA_InitChannel ⇒ __aeabi_assert ⇒ DbgConsole_Printf ⇒ DbgConsole_Vprintf ⇒ memcpy

[Calls]

- >> __aeabi_assert

[Called By]

- >> EDMA_Init

EDMA_ResetChannel (Thumb, 142 bytes, Stack size 0 bytes, fsl_edma.o(.text.EDMA_ResetChannel))

[Stack]

- Max Depth = 136
- Call Chain = EDMA_ResetChannel ⇒ __aeabi_assert ⇒ DbgConsole_Printf ⇒ DbgConsole_Vprintf ⇒ memcpy

[Calls]

- >> __aeabi_assert

[Called By]

- >> LPSPI_MasterTransferEDMALite

EDMA_SetCallback (Thumb, 34 bytes, Stack size 0 bytes, fsl_edma.o(.text.EDMA_SetCallback))

[Stack]

- Max Depth = 136
- Call Chain = EDMA_SetCallback ⇒ __aeabi_assert ⇒ DbgConsole_Printf ⇒ DbgConsole_Vprintf ⇒ memcpy

[Calls]

- >> __aeabi_assert

[Called By]

- >> LPSPI_MasterTransferEDMALite

EDMA_SetTransferConfig (Thumb, 176 bytes, Stack size 16 bytes, fsl_edma.o(.text.EDMA_SetTransferConfig))

[Stack]

- Max Depth = 184
- Call Chain = EDMA_SetTransferConfig ⇒ EDMA_ConfigChannelSoftwareTCD ⇒ __aeabi_assert ⇒ DbgConsole_Printf ⇒ DbgConsole_Vprintf ⇒ memcpy

[Calls]

- >> __aeabi_assert
- >> EDMA_ConfigChannelSoftwareTCD

[Called By]

- >> LPSPI_MasterTransferEDMALite

EDMA_StartTransfer (Thumb, 86 bytes, Stack size 0 bytes, fsl_edma.o(.text.EDMA_StartTransfer))

[Stack]

- Max Depth = 136
- Call Chain = EDMA_StartTransfer ⇒ __aeabi_assert ⇒ DbgConsole_Printf ⇒ DbgConsole_Vprintf ⇒ memcpy

[Calls]

- >> __aeabi_assert

[Called By]

- >> LPSPI_MasterTransferEDMALite

EDMA_TcdReset (Thumb, 82 bytes, Stack size 0 bytes, fsl_edma.o(.text.EDMA_TcdReset))

[Stack]

- Max Depth = 136
- Call Chain = EDMA_TcdReset ⇒ __aeabi_assert ⇒ DbgConsole_Printf ⇒ DbgConsole_Vprintf ⇒ memcpy

[Calls]

- >> __aeabi_assert

[Called By]

- >> LPSPI_MasterTransferEDMALite

EDMA_TcdSetTransferConfig (Thumb, 114 bytes, Stack size 16 bytes, fsl_edma.o(.text.EDMA_TcdSetTransferConfig))

[Stack]

- Max Depth = 184
- Call Chain = EDMA_TcdSetTransferConfig ⇒ EDMA_ConfigChannelSoftwareTCD ⇒ __aeabi_assert ⇒ DbgConsole_Printf ⇒ DbgConsole_Vprintf ⇒ memcpy

[Calls]

- >> __aeabi_assert
- >> EDMA_ConfigChannelSoftwareTCD

[Called By]

- >> LPSPI_MasterTransferEDMALite

EXEC (Thumb, 16 bytes, Stack size unknown bytes, NeutronRuntime.c.o(.text.EXEC))

[Calls]

- >> neutron_exec

[Called By]

- >> MirrorPad
- >> MemCpy
- >> Slice
- >> Conv2DAtrous
- >> Activation
- >> Abs
- >> Add
- >> Pad
- >> FullyConnected
- >> GlobalAvgPool
- >> GlobalMaxPool
- >> MaxPool
- >> BitTransformation
- >> MulInt16
- >> BatchMulAdd
- >> Upsample2DV1
- >> Conv2DPointwise
- >> Conv1DStandard
- >> Conv2DDepthwiseV2
- >> Conv2DDepthwiseV1
- >> Conv2DDepthwiseNeutron16x16Kernel3x3
- >> Conv2DStandardV3
- >> Conv2DStandardV2
- >> Conv2DStandardV1

FLEXIO_DriverIRQHandler (Thumb, 62 bytes, Stack size 24 bytes, fsl_flexio.o(.text.FLEXIO_DriverIRQHandler))

[Stack]

- Max Depth = 24
- Call Chain = FLEXIO_DriverIRQHandler

[Address Reference Count : 1]

- startup_mcxn947_cm33_core0.o(.text)

FullyConnected (Thumb, 528 bytes, Stack size unknown bytes, NeutronKernels.c.o(.text.FullyConnected))

[Calls]

- >> EXEC

[Called By]

- >> CallKernel

GPIO00_IRQHandler (Thumb, 6 bytes, Stack size 0 bytes, fsl_adapter_gpio.o(.text.GPIO00_IRQHandler))

[Stack]

- Max Depth = 24
- Call Chain = GPIO00_IRQHandler ⇒ HAL_GpioInterruptHandle

[Calls]

- >> HAL_GpioInterruptHandle

[Address Reference Count : 1]

- startup_mcxn947_cm33_core0.o(.isr_vector)

GPIO01_IRQHandler (Thumb, 6 bytes, Stack size 0 bytes, fsl_adapter_gpio.o(.text.GPIO01_IRQHandler))

[Stack]

- Max Depth = 24
- Call Chain = GPIO01_IRQHandler ⇒ HAL_GpioInterruptHandle

[Calls]

- >> HAL_GpioInterruptHandle

[Address Reference Count : 1]

- startup_mcxn947_cm33_core0.o(.isr_vector)

GPIO10_IRQHandler (Thumb, 6 bytes, Stack size 0 bytes, fsl_adapter_gpio.o(.text.GPIO10_IRQHandler))

[Stack]

- Max Depth = 24
- Call Chain = GPIO10_IRQHandler ⇒ HAL_GpioInterruptHandle

[Calls]

- >> HAL_GpioInterruptHandle

[Address Reference Count : 1]

- startup_mcxn947_cm33_core0.o(.isr_vector)

GPIO11_IRQHandler (Thumb, 6 bytes, Stack size 0 bytes, fsl_adapter_gpio.o(.text.GPIO11_IRQHandler))

[Stack]

- Max Depth = 24
- Call Chain = GPIO11_IRQHandler ⇒ HAL_GpioInterruptHandle

[Calls]

- >> HAL_GpioInterruptHandle

[Address Reference Count : 1]

- startup_mcxn947_cm33_core0.o(.isr_vector)

GPIO20_IRQHandler (Thumb, 6 bytes, Stack size 0 bytes, fsl_adapter_gpio.o(.text.GPIO20_IRQHandler))

[Stack]

- Max Depth = 24
- Call Chain = GPIO20_IRQHandler ⇒ HAL_GpioInterruptHandle

[Calls]

- >> HAL_GpioInterruptHandle

[Address Reference Count : 1]

- startup_mcxn947_cm33_core0.o(.isr_vector)

GPIO21_IRQHandler (Thumb, 6 bytes, Stack size 0 bytes, fsl_adapter_gpio.o(.text.GPIO21_IRQHandler))

[Stack]

- Max Depth = 24
- Call Chain = GPIO21_IRQHandler ⇒ HAL_GpioInterruptHandle

[Calls]

- >> HAL_GpioInterruptHandle

[Address Reference Count : 1]

- startup_mcxn947_cm33_core0.o(.isr_vector)

GPIO30_IRQHandler (Thumb, 6 bytes, Stack size 0 bytes, fsl_adapter_gpio.o(.text.GPIO30_IRQHandler))

[Stack]

- Max Depth = 24
- Call Chain = GPIO30_IRQHandler ⇒ HAL_GpioInterruptHandle

[Calls]

- >> HAL_GpioInterruptHandle

[Address Reference Count : 1]

- startup_mcxn947_cm33_core0.o(.isr_vector)

GPIO31_IRQHandler (Thumb, 6 bytes, Stack size 0 bytes, fsl_adapter_gpio.o(.text.GPIO31_IRQHandler))

[Stack]

- Max Depth = 24
- Call Chain = GPIO31_IRQHandler ⇒ HAL_GpioInterruptHandle

[Calls]

- >> HAL_GpioInterruptHandle

[Address Reference Count : 1]

- startup_mcxn947_cm33_core0.o(.isr_vector)

GPIO40_IRQHandler (Thumb, 6 bytes, Stack size 0 bytes, fsl_adapter_gpio.o(.text.GPIO40_IRQHandler))

[Stack]

- Max Depth = 24
- Call Chain = GPIO40_IRQHandler ⇒ HAL_GpioInterruptHandle

[Calls]

- >> HAL_GpioInterruptHandle

[Address Reference Count : 1]

- startup_mcxn947_cm33_core0.o(.isr_vector)

GPIO41_IRQHandler (Thumb, 6 bytes, Stack size 0 bytes, fsl_adapter_gpio.o(.text.GPIO41_IRQHandler))

[Stack]

- Max Depth = 24
- Call Chain = GPIO41_IRQHandler ⇒ HAL_GpioInterruptHandle

[Calls]

- >> HAL_GpioInterruptHandle

[Address Reference Count : 1]

- startup_mcxn947_cm33_core0.o(.isr_vector)

GPIO50_IRQHandler (Thumb, 6 bytes, Stack size 0 bytes, fsl_adapter_gpio.o(.text.GPIO50_IRQHandler))

[Stack]

- Max Depth = 24
- Call Chain = GPIO50_IRQHandler ⇒ HAL_GpioInterruptHandle

[Calls]

- >> HAL_GpioInterruptHandle

[Address Reference Count : 1]

- startup_mcxn947_cm33_core0.o(.isr_vector)

GPIO51_IRQHandler (Thumb, 6 bytes, Stack size 0 bytes, fsl_adapter_gpio.o(.text.GPIO51_IRQHandler))

[Stack]

- Max Depth = 24
- Call Chain = GPIO51_IRQHandler ⇒ HAL_GpioInterruptHandle

[Calls]

- >> HAL_GpioInterruptHandle

[Address Reference Count : 1]

- startup_mcxn947_cm33_core0.o(.isr_vector)

GPIO_GpioClearInterruptFlags (Thumb, 6 bytes, Stack size 0 bytes, fsl_gpio.o(.text.GPIO_GpioClearInterruptFlags))

[Called By]

- >> HAL_GpioInterruptHandle

GPIO_GpioGetInterruptFlags (Thumb, 6 bytes, Stack size 0 bytes, fsl_gpio.o(.text.GPIO_GpioGetInterruptFlags))

[Called By]

- >> HAL_GpioInterruptHandle

GPIO_PinInit (Thumb, 64 bytes, Stack size 0 bytes, fsl_gpio.o(.text.GPIO_PinInit))

[Stack]

- Max Depth = 136
- Call Chain = GPIO_PinInit ⇒ __aeabi_assert ⇒ DbgConsole_Printf ⇒ DbgConsole_Vprintf ⇒ memcpy

[Calls]

- >> __aeabi_assert

[Called By]

- >> HAL_GpioInit
- >> gpio_init

GetKernelArgSz (Thumb, 20 bytes, Stack size unknown bytes, NeutronRuntime.c.o(.text.GetKernelArgSz))

[Called By]

- >> GetKernelArgSzWrapper

GetKernelArgSzWrapper (Thumb, 4 bytes, Stack size unknown bytes, NeutronFirmwarePrivate.c.o(.text.GetKernelArgSzWrapper))

[Calls]

- >> GetKernelArgSz

[Called By]

- >> neutronFwInterpreter

GetMaxArgSz (Thumb, 32 bytes, Stack size unknown bytes, NeutronRuntime.c.o(.text.GetMaxArgSz))

[Called By]

- >> validateArgsSz

GlobalAvgPool (Thumb, 360 bytes, Stack size unknown bytes, NeutronKernels.c.o(.text.GlobalAvgPool))

[Calls]

- >> EXEC

[Called By]

- >> CallKernel

GlobalMaxPool (Thumb, 1096 bytes, Stack size unknown bytes, NeutronKernels.c.o(.text.GlobalMaxPool))

[Calls]

- >> EXEC

[Called By]

- >> CallKernel

HAL_GpioGetInput (Thumb, 84 bytes, Stack size 0 bytes, fsl_adapter_gpio.o(.text.HAL_GpioGetInput))

[Stack]

- Max Depth = 136
- Call Chain = HAL_GpioGetInput ⇒ __aeabi_assert ⇒ DbgConsole_Printf ⇒ DbgConsole_Vprintf ⇒ memcpy

[Calls]

- >> __aeabi_assert

[Called By]

- >> BOARD_SD_Config
- >> SDMMC_SD_CD_Callback
- >> BOARD_SDCardGetDetectStatus

HAL_GpioInit (Thumb, 204 bytes, Stack size 16 bytes, fsl_adapter_gpio.o(.text.HAL_GpioInit))

[Stack]

- Max Depth = 152
- Call Chain = HAL_GpioInit ⇒ GPIO_PinInit ⇒ __aeabi_assert ⇒ DbgConsole_Printf ⇒ DbgConsole_Vprintf ⇒ memcpy

[Calls]

- >> GPIO_PinInit
- >> __aeabi_assert
- >> memcpy

[Called By]

- >> BOARD_SD_Config

HAL_GpioInstallCallback (Thumb, 40 bytes, Stack size 0 bytes, fsl_adapter_gpio.o(.text.HAL_GpioInstallCallback))

[Stack]

- Max Depth = 136
- Call Chain = HAL_GpioInstallCallback ⇒ __aeabi_assert ⇒ DbgConsole_Printf ⇒ DbgConsole_Vprintf ⇒ memcpy

[Calls]

- >> __aeabi_assert

[Called By]

- >> BOARD_SD_Config

HAL_GpioSetOutput (Thumb, 66 bytes, Stack size 0 bytes, fsl_adapter_gpio.o(.text.HAL_GpioSetOutput))

[Stack]

- Max Depth = 136
- Call Chain = HAL_GpioSetOutput ⇒ __aeabi_assert ⇒ DbgConsole_Printf ⇒ DbgConsole_Vprintf ⇒ memcpy

[Calls]

- >> __aeabi_assert

[Called By]

- >> BOARD_SDCardPowerControl

HAL_GpioSetTriggerMode (Thumb, 176 bytes, Stack size 8 bytes, fsl_adapter_gpio.o(.text.HAL_GpioSetTriggerMode))

[Stack]

- Max Depth = 144
- Call Chain = HAL_GpioSetTriggerMode ⇒ __aeabi_assert ⇒ DbgConsole_Printf ⇒ DbgConsole_Vprintf ⇒ memcpy

[Calls]

- >> __aeabi_assert

[Called By]

- >> BOARD_SD_Config

HardFault_Handler (Thumb, 24 bytes, Stack size 0 bytes, zf_board_init.o(.text.HardFault_Handler))

[Calls]

- >> gpio_toggle_level
- >> system_delay_ms

[Address Reference Count : 2]

- startup_mcxn947_cm33_core0.o(.isr_vector)
- startup_mcxn947_cm33_core0.o(.text)

INPUTMUX_AttachSignal (Thumb, 14 bytes, Stack size 0 bytes, fsl_inputmux.o(.text.INPUTMUX_AttachSignal))

[Called By]

- >> ezh_start

INPUTMUX_Deinit (Thumb, 16 bytes, Stack size 0 bytes, fsl_inputmux.o(.text.INPUTMUX_Deinit))

[Called By]

- >> ezh_start

INPUTMUX_Init (Thumb, 60 bytes, Stack size 0 bytes, fsl_inputmux.o(.text.INPUTMUX_Init))

[Stack]

- Max Depth = 136
- Call Chain = INPUTMUX_Init ⇒ __aeabi_assert ⇒ DbgConsole_Printf ⇒ DbgConsole_Vprintf ⇒ memcpy

[Calls]

- >> __aeabi_assert
- >> RESET_ClearPeripheralReset

[Called By]

- >> ezh_start

InvokeDebugLogCallback (Thumb, 16 bytes, Stack size unknown bytes, debug_log.o(.text.InvokeDebugLogCallback))

[Called By]

- >> DebugLog

KEY_init (Thumb, 54 bytes, Stack size 16 bytes, zf_model_process.o(.text.KEY_init))

[Stack]

- Max Depth = 184
- Call Chain = KEY_init ⇒ gpio_init ⇒ GPIO_PinInit ⇒ __aeabi_assert ⇒ DbgConsole_Printf ⇒ DbgConsole_Vprintf ⇒ memcpy

[Calls]

- >> gpio_init

[Called By]

- >> main

LED_init (Thumb, 98 bytes, Stack size 16 bytes, zf_model_process.o(.text.LED_init))

[Stack]

- Max Depth = 184
- Call Chain = LED_init ⇒ gpio_init ⇒ GPIO_PinInit ⇒ __aeabi_assert ⇒ DbgConsole_Printf ⇒ DbgConsole_Vprintf ⇒ memcpy

[Calls]

- >> gpio_init

[Called By]

- >> main

LPSPI_CheckTransferArgument (Thumb, 182 bytes, Stack size 16 bytes, fsl_lpspi.o(.text.LPSPI_CheckTransferArgument))

[Stack]

- Max Depth = 152
- Call Chain = LPSPI_CheckTransferArgument ⇒ __aeabi_assert ⇒ DbgConsole_Printf ⇒ DbgConsole_Vprintf ⇒ memcpy

[Calls]

- >> __aeabi_assert

[Called By]

- >> LPSPI_MasterTransferEDMALite

LPSPI_GetInstance (Thumb, 56 bytes, Stack size 0 bytes, fsl_lpspi.o(.text.LPSPI_GetInstance))

[Stack]

- Max Depth = 136
- Call Chain = LPSPI_GetInstance ⇒ __aeabi_assert ⇒ DbgConsole_Printf ⇒ DbgConsole_Vprintf ⇒ memcpy

[Calls]

- >> __aeabi_assert

[Called By]

- >> LPSPI_MasterTransferCreateHandleEDMA
- >> LPSPI_MasterTransferEDMALite
- >> LPSPI_MasterTransferPrepareEDMALite

LPSPI_MasterGetDefaultConfig (Thumb, 74 bytes, Stack size 16 bytes, fsl_lpspi.o(.text.LPSPI_MasterGetDefaultConfig))

[Stack]

- Max Depth = 152
- Call Chain = LPSPI_MasterGetDefaultConfig ⇒ __aeabi_assert ⇒ DbgConsole_Printf ⇒ DbgConsole_Vprintf ⇒ memcpy

[Calls]

- >> __aeabi_assert
- >> memset

[Called By]

- >> ips200_init

LPSPI_MasterInit (Thumb, 844 bytes, Stack size 40 bytes, fsl_lpspi.o(.text.LPSPI_MasterInit))

[Stack]

- Max Depth = 224
- Call Chain = LPSPI_MasterInit ⇒ LPSPI_MasterSetDelayTimes ⇒ __aeabi_assert ⇒ DbgConsole_Printf ⇒ DbgConsole_Vprintf ⇒ memcpy

[Calls]

- >> __aeabi_assert
- >> LPSPI_MasterSetDelayTimes
- >> LP_FLEXCOMM_Init
- >> LP_FLEXCOMM_GetBaseAddress
- >> __aeabi_uldivmod

[Called By]

- >> ips200_init

LPSPI_MasterSetDelayTimes (Thumb, 416 bytes, Stack size 48 bytes, fsl_lpspi.o(.text.LPSPI_MasterSetDelayTimes))

[Stack]

- Max Depth = 184
- Call Chain = LPSPI_MasterSetDelayTimes ⇒ __aeabi_assert ⇒ DbgConsole_Printf ⇒ DbgConsole_Vprintf ⇒ memcpy

[Calls]

- >> __aeabi_assert
- >> __aeabi_uldivmod

[Called By]

- >> LPSPI_MasterInit

LPSPI_MasterTransferCreateHandleEDMA (Thumb, 150 bytes, Stack size 32 bytes, fsl_lpspi_edma.o(.text.LPSPI_MasterTransferCreateHandleEDMA))

[Stack]

- Max Depth = 168
- Call Chain = LPSPI_MasterTransferCreateHandleEDMA ⇒ __aeabi_assert ⇒ DbgConsole_Printf ⇒ DbgConsole_Vprintf ⇒ memcpy

[Calls]

- >> __aeabi_assert
- >> LPSPI_GetInstance
- >> memset

[Called By]

- >> ips200_init

LPSPI_MasterTransferEDMA (Thumb, 34 bytes, Stack size 16 bytes, fsl_lpspi_edma.o(.text.LPSPI_MasterTransferEDMA))

[Stack]

- Max Depth = 376 + Unknown Stack Size
- Call Chain = LPSPI_MasterTransferEDMA ⇒ LPSPI_MasterTransferEDMALite ⇒ EDMA_TcdSetTransferConfig ⇒ EDMA_ConfigChannelSoftwareTCD ⇒ __aeabi_assert ⇒ DbgConsole_Printf ⇒ DbgConsole_Vprintf ⇒ memcpy

[Calls]

- >> LPSPI_MasterTransferEDMALite
- >> LPSPI_MasterTransferPrepareEDMALite

[Called By]

- >> ips200_show_char
- >> ips200_set_region
- >> ips200_show_scc8660
- >> ips200_draw_line
- >> ips200_init

LPSPI_MasterTransferEDMALite (Thumb, 914 bytes, Stack size 176 bytes, fsl_lpspi_edma.o(.text.LPSPI_MasterTransferEDMALite))

[Stack]

- Max Depth = 360 + Unknown Stack Size
- Call Chain = LPSPI_MasterTransferEDMALite ⇒ EDMA_TcdSetTransferConfig ⇒ EDMA_ConfigChannelSoftwareTCD ⇒ __aeabi_assert ⇒ DbgConsole_Printf ⇒ DbgConsole_Vprintf ⇒ memcpy

[Calls]

- >> __aeabi_assert
- >> LPSPI_CheckTransferArgument
- >> LPSPI_GetInstance
- >> EDMA_StartTransfer
- >> EDMA_SetCallback
- >> EDMA_EnableChannelInterrupts
- >> EDMA_TcdSetTransferConfig
- >> EDMA_SetTransferConfig
- >> EDMA_TcdReset
- >> EDMA_ResetChannel
- >> __aeabi_memclr4

[Called By]

- >> LPSPI_MasterTransferEDMA

LPSPI_MasterTransferPrepareEDMALite (Thumb, 236 bytes, Stack size 32 bytes, fsl_lpspi_edma.o(.text.LPSPI_MasterTransferPrepareEDMALite))

[Stack]

- Max Depth = 168
- Call Chain = LPSPI_MasterTransferPrepareEDMALite ⇒ __aeabi_assert ⇒ DbgConsole_Printf ⇒ DbgConsole_Vprintf ⇒ memcpy

[Calls]

- >> __aeabi_assert
- >> LPSPI_GetInstance

[Called By]

- >> LPSPI_MasterTransferEDMA

LPSPI_MasterUserCallback (Thumb, 14 bytes, Stack size 0 bytes, zf_device_ips200.o(.text.LPSPI_MasterUserCallback))
[Address Reference Count : 1]

- zf_device_ips200.o(.text.ips200_init)

LPTMR_Deinit (Thumb, 10 bytes, Stack size 0 bytes, fsl_lptmr.o(.text.LPTMR_Deinit))

[Called By]

- >> system_delay_init

LPTMR_GetDefaultConfig (Thumb, 50 bytes, Stack size 16 bytes, fsl_lptmr.o(.text.LPTMR_GetDefaultConfig))

[Stack]

- Max Depth = 152
- Call Chain = LPTMR_GetDefaultConfig ⇒ __aeabi_assert ⇒ DbgConsole_Printf ⇒ DbgConsole_Vprintf ⇒ memcpy

[Calls]

- >> __aeabi_assert
- >> memset

[Called By]

- >> system_delay_init

LPTMR_Init (Thumb, 88 bytes, Stack size 8 bytes, fsl_lptmr.o(.text.LPTMR_Init))

[Stack]

- Max Depth = 144
- Call Chain = LPTMR_Init ⇒ __aeabi_assert ⇒ DbgConsole_Printf ⇒ DbgConsole_Vprintf ⇒ memcpy

[Calls]

- >> __aeabi_assert

[Called By]

- >> system_delay_init

LPUART_ClearStatusFlags (Thumb, 92 bytes, Stack size 8 bytes, fsl_lpuart.o(.text.LPUART_ClearStatusFlags))

[Stack]

- Max Depth = 8
- Call Chain = LPUART_ClearStatusFlags

[Called By]

- >> LP_FLEXCOMM5_IRQHandler
- >> LP_FLEXCOMM4_IRQHandler

LPUART_Deinit (Thumb, 82 bytes, Stack size 0 bytes, fsl_lpuart.o(.text.LPUART_Deinit))

[Stack]

- Max Depth = 136 + In Cycle
- Call Chain = LPUART_Deinit ⇒ LPUART_Deinit (Cycle)

[Calls]

- >> __aeabi_assert
- >> LPUART_Deinit
- >> LP_FLEXCOMM_Deinit

[Called By]

- >> LPUART_Deinit
- >> debug_uart_init
- >> user_uart_init

LPUART_EnableInterrupts (Thumb, 102 bytes, Stack size 0 bytes, fsl_lpuart.o(.text.LPUART_EnableInterrupts))

[Called By]

- >> debug_uart_init
- >> user_uart_init

LPUART_GetDefaultConfig (Thumb, 56 bytes, Stack size 16 bytes, fsl_lpuart.o(.text.LPUART_GetDefaultConfig))

[Stack]

- Max Depth = 152
- Call Chain = LPUART_GetDefaultConfig ⇒ __aeabi_assert ⇒ DbgConsole_Printf ⇒ DbgConsole_Vprintf ⇒ memcpy

[Calls]

- >> __aeabi_assert
- >> memset

[Called By]

- >> debug_uart_init
- >> user_uart_init

LPUART_GetStatusFlags (Thumb, 32 bytes, Stack size 0 bytes, fsl_lpuart.o(.text.LPUART_GetStatusFlags))

[Called By]

- >> LP_FLEXCOMM5_IRQHandler
- >> LP_FLEXCOMM4_IRQHandler

LPUART_Init (Thumb, 796 bytes, Stack size 40 bytes, fsl_lpuart.o(.text.LPUART_Init))

[Stack]

- Max Depth = 192
- Call Chain = LPUART_Init ⇒ LP_FLEXCOMM_Init ⇒ __aeabi_assert ⇒ DbgConsole_Printf ⇒ DbgConsole_Vprintf ⇒ memcpy

[Calls]

- >> __aeabi_assert
- >> LP_FLEXCOMM_Init

[Called By]

- >> debug_uart_init
- >> user_uart_init

LPUART_WriteBlocking (Thumb, 54 bytes, Stack size 0 bytes, fsl_lpuart.o(.text.LPUART_WriteBlocking))

[Stack]

- Max Depth = 136
- Call Chain = LPUART_WriteBlocking ⇒ __aeabi_assert ⇒ DbgConsole_Printf ⇒ DbgConsole_Vprintf ⇒ memcpy

[Calls]

- >> __aeabi_assert

[Called By]

- >> user_uart_write_buffer
- >> zf_user_printf
- >> zf_debug_printf

LP_FLEXCOMM0_DriverIRQHandler (Thumb, 96 bytes, Stack size 16 bytes, fsl_lpflexcomm.o(.text.LP_FLEXCOMM0_DriverIRQHandler))

[Stack]

- Max Depth = 16
- Call Chain = LP_FLEXCOMM0_DriverIRQHandler

[Address Reference Count : 1]

- startup_mcxn947_cm33_core0.o(.text)

LP_FLEXCOMM1_DriverIRQHandler (Thumb, 96 bytes, Stack size 16 bytes, fsl_lpflexcomm.o(.text.LP_FLEXCOMM1_DriverIRQHandler))

[Stack]

- Max Depth = 16
- Call Chain = LP_FLEXCOMM1_DriverIRQHandler

[Address Reference Count : 1]

- startup_mcxn947_cm33_core0.o(.text)

LP_FLEXCOMM2_DriverIRQHandler (Thumb, 100 bytes, Stack size 16 bytes, fsl_lpflexcomm.o(.text.LP_FLEXCOMM2_DriverIRQHandler))

[Stack]

- Max Depth = 16
- Call Chain = LP_FLEXCOMM2_DriverIRQHandler

[Address Reference Count : 1]

- startup_mcxn947_cm33_core0.o(.text)

LP_FLEXCOMM3_DriverIRQHandler (Thumb, 100 bytes, Stack size 16 bytes, fsl_lpflexcomm.o(.text.LP_FLEXCOMM3_DriverIRQHandler))

[Stack]

- Max Depth = 16
- Call Chain = LP_FLEXCOMM3_DriverIRQHandler

[Address Reference Count : 1]

- startup_mcxn947_cm33_core0.o(.text)

LP_FLEXCOMM4_DriverIRQHandler (Thumb, 100 bytes, Stack size 16 bytes, fsl_lpflexcomm.o(.text.LP_FLEXCOMM4_DriverIRQHandler))

[Stack]

- Max Depth = 16
- Call Chain = LP_FLEXCOMM4_DriverIRQHandler

[Address Reference Count : 1]

- startup_mcxn947_cm33_core0.o(.text)

LP_FLEXCOMM4_IRQHandler (Thumb, 38 bytes, Stack size 8 bytes, zf_board_init.o(.text.LP_FLEXCOMM4_IRQHandler))

[Stack]

- Max Depth = 16
- Call Chain = LP_FLEXCOMM4_IRQHandler ⇒ LPUART_ClearStatusFlags

[Calls]

- >> LPUART_ClearStatusFlags
- >> LPUART_GetStatusFlags

[Address Reference Count : 1]

- startup_mcxn947_cm33_core0.o(.isr_vector)

LP_FLEXCOMM5_DriverIRQHandler (Thumb, 100 bytes, Stack size 16 bytes, fsl_lpflexcomm.o(.text.LP_FLEXCOMM5_DriverIRQHandler))

[Stack]

- Max Depth = 16
- Call Chain = LP_FLEXCOMM5_DriverIRQHandler

[Address Reference Count : 1]

- startup_mcxn947_cm33_core0.o(.text)

LP_FLEXCOMM5_IRQHandler (Thumb, 74 bytes, Stack size 8 bytes, zf_driver_uart.o(.text.LP_FLEXCOMM5_IRQHandler))

[Stack]

- Max Depth = 16
- Call Chain = LP_FLEXCOMM5_IRQHandler ⇒ LPUART_ClearStatusFlags

[Calls]

- >> LPUART_ClearStatusFlags
- >> LPUART_GetStatusFlags
- >> UART5_IRQHandler

[Address Reference Count : 1]

- startup_mcxn947_cm33_core0.o(.isr_vector)

LP_FLEXCOMM6_DriverIRQHandler (Thumb, 100 bytes, Stack size 16 bytes, fsl_lpflexcomm.o(.text.LP_FLEXCOMM6_DriverIRQHandler))

[Stack]

- Max Depth = 16
- Call Chain = LP_FLEXCOMM6_DriverIRQHandler

[Address Reference Count : 1]

- startup_mcxn947_cm33_core0.o(.text)

LP_FLEXCOMM7_DriverIRQHandler (Thumb, 100 bytes, Stack size 16 bytes, fsl_lpflexcomm.o(.text.LP_FLEXCOMM7_DriverIRQHandler))

[Stack]

- Max Depth = 16
- Call Chain = LP_FLEXCOMM7_DriverIRQHandler

[Address Reference Count : 1]

- startup_mcxn947_cm33_core0.o(.text)

LP_FLEXCOMM8_DriverIRQHandler (Thumb, 100 bytes, Stack size 16 bytes, fsl_lpflexcomm.o(.text.LP_FLEXCOMM8_DriverIRQHandler))

[Stack]

- Max Depth = 16
- Call Chain = LP_FLEXCOMM8_DriverIRQHandler

[Address Reference Count : 1]

- startup_mcxn947_cm33_core0.o(.text)

LP_FLEXCOMM9_DriverIRQHandler (Thumb, 100 bytes, Stack size 16 bytes, fsl_lpflexcomm.o(.text.LP_FLEXCOMM9_DriverIRQHandler))

[Stack]

- Max Depth = 16
- Call Chain = LP_FLEXCOMM9_DriverIRQHandler

[Address Reference Count : 1]

- startup_mcxn947_cm33_core0.o(.text)

LP_FLEXCOMM_Deinit (Thumb, 170 bytes, Stack size 0 bytes, fsl_lpflexcomm.o(.text.LP_FLEXCOMM_Deinit))

[Stack]

- Max Depth = 136
- Call Chain = LP_FLEXCOMM_Deinit ⇒ __aeabi_assert ⇒ DbgConsole_Printf ⇒ DbgConsole_Vprintf ⇒ memcpy

[Calls]

- >> __aeabi_assert
- >> RESET_SetPeripheralReset

[Called By]

- >> LPUART_Deinit

LP_FLEXCOMM_GetBaseAddress (Thumb, 20 bytes, Stack size 0 bytes, fsl_lpflexcomm.o(.text.LP_FLEXCOMM_GetBaseAddress))

[Called By]

- >> LPSPI_MasterInit

LP_FLEXCOMM_Init (Thumb, 260 bytes, Stack size 16 bytes, fsl_lpflexcomm.o(.text.LP_FLEXCOMM_Init))

[Stack]

- Max Depth = 152
- Call Chain = LP_FLEXCOMM_Init ⇒ __aeabi_assert ⇒ DbgConsole_Printf ⇒ DbgConsole_Vprintf ⇒ memcpy

[Calls]

- >> __aeabi_assert
- >> RESET_ClearPeripheralReset

[Called By]

- >> LPSPI_MasterInit
- >> LPUART_Init

MODEL_GetAnchors (Thumb, 10 bytes, Stack size 0 bytes, model.o(.text.MODEL_GetAnchors))

[Called By]

- >> zf_model_init

MODEL_GetArenaUsedBytes (Thumb, 24 bytes, Stack size 0 bytes, model.o(.text.MODEL_GetArenaUsedBytes))

[Calls]

- >> tflite::MicroAllocator::used_bytes() const

[Called By]

- >> zf_model_init

MODEL_GetInputTensorData (Thumb, 112 bytes, Stack size 16 bytes, model.o(.text.MODEL_GetInputTensorData))

[Stack]

- Max Depth = 152 + Unknown Stack Size
- Call Chain = MODEL_GetInputTensorData ⇒ __aeabi_assert ⇒ DbgConsole_Printf ⇒ DbgConsole_Vprintf ⇒ memcpy

[Calls]

- >> __aeabi_assert
- >> tflite::MicroInterpreter::input(unsigned int)

[Called By]

- >> zf_model_init

MODEL_GetOutputSize (Thumb, 84 bytes, Stack size 0 bytes, model.o(.text.MODEL_GetOutputSize))

[Stack]

- Max Depth = 136
- Call Chain = MODEL_GetOutputSize ⇒ __aeabi_assert ⇒ DbgConsole_Printf ⇒ DbgConsole_Vprintf ⇒ memcpy

[Calls]

- >> __aeabi_assert

[Called By]

- >> zf_model_init

MODEL_GetOutputTensor (Thumb, 20 bytes, Stack size 0 bytes, model.o(.text.MODEL_GetOutputTensor))

[Stack]

- Max Depth = 128 + Unknown Stack Size
- Call Chain = MODEL_GetOutputTensor ⇒ tflite::MicroInterpreter::output(unsigned int) ⇒ MicroPrintf(char const*, ...) ⇒ VMicroPrintf(char const*, std::__va_list) ⇒ (anonymous namespace)::VDebugLog(char const*, ...) (.constprop.0) ⇒ DebugLog ⇒ vsnprintf ⇒ _printf_char_common ⇒ __printf

[Calls]

- >> tflite::MicroInterpreter::output(unsigned int)

[Called By]

- >> zf_model_init

MODEL_GetOutputTensorData (Thumb, 112 bytes, Stack size 16 bytes, model.o(.text.MODEL_GetOutputTensorData))

[Stack]

- Max Depth = 152 + Unknown Stack Size
- Call Chain = MODEL_GetOutputTensorData ⇒ __aeabi_assert ⇒ DbgConsole_Printf ⇒ DbgConsole_Vprintf ⇒ memcpy

[Calls]

- >> __aeabi_assert
- >> tflite::MicroInterpreter::output(unsigned int)

[Called By]

- >> zf_model_init

MODEL_Init (Thumb, 236 bytes, Stack size 32 bytes, model.o(.text.MODEL_Init))

[Stack]

- Max Depth = 240 + Unknown Stack Size
- Call Chain = MODEL_Init ⇒ MODEL_GetOpsResolver() ⇒ tflite::MicroMutableOpResolver⟨12u⟩::AddBuiltin(tflite::BuiltinOperator, TFLMRegistration const&, TfLiteStatus (*)(tflite::Operator const*, tflite::ErrorReporter*, tflite::BuiltinDataAllocator*, void**)) ⇒ MicroPrintf(char const*, ...) ⇒ VMicroPrintf(char const*, std::__va_list) ⇒ (anonymous namespace)::VDebugLog(char const*, ...) (.constprop.0) ⇒ DebugLog ⇒ vsnprintf ⇒ _printf_char_common ⇒ __printf

[Calls]

- >> DbgConsole_Printf
- >> __cxa_guard_release
- >> tflite::MicroInterpreter::MicroInterpreter(tflite::Model const*, tflite::MicroOpResolver const&, unsigned char*, unsigned int, tflite::MicroResourceVariables*, tflite::MicroProfilerInterface*, bool)
- >> __cxa_guard_acquire
- >> tflite::MicroInterpreter::AllocateTensors()
- >> MODEL_GetOpsResolver()
- >> __cxa_atexit

[Called By]

- >> zf_model_init

MODEL_RunInference (Thumb, 36 bytes, Stack size 8 bytes, model.o(.text.MODEL_RunInference))

[Stack]

- Max Depth = 144 + Unknown Stack Size
- Call Chain = MODEL_RunInference ⇒ DbgConsole_Printf ⇒ DbgConsole_Vprintf ⇒ memcpy

[Calls]

- >> DbgConsole_Printf
- >> tflite::MicroInterpreter::Invoke()

[Called By]

- >> zf_model_run

MaxPool (Thumb, 1288 bytes, Stack size unknown bytes, NeutronKernels.c.o(.text.MaxPool))

[Calls]

- >> EXEC

[Called By]

- >> CallKernel

MemCpy (Thumb, 956 bytes, Stack size unknown bytes, NeutronKernels.c.o(.text.MemCpy))

[Calls]

- >> EXEC
- >> neutron_done

[Called By]

- >> CallKernel

MirrorPad (Thumb, 496 bytes, Stack size unknown bytes, NeutronKernels.c.o(.text.MirrorPad))

[Calls]

- >> EXEC

[Called By]

- >> CallKernel

MulInt16 (Thumb, 400 bytes, Stack size unknown bytes, NeutronKernels.c.o(.text.MulInt16))

[Calls]

- >> EXEC

[Called By]

- >> CallKernel

NeutronFirmwareTraceInit (Thumb, 28 bytes, Stack size unknown bytes, NeutronFirmwareTrace.c.o(.text.NeutronFirmwareTraceInit))

[Called By]

- >> privateNeutronRunBlocking

NeutronMicroInstrPost (Thumb, 6 bytes, Stack size unknown bytes, NeutronFirmwarePrivate.c.o(.text.NeutronMicroInstrPost))

[Calls]

- >> traceEvent

[Called By]

- >> neutronFwInterpreter

NeutronMicroInstrPre (Thumb, 6 bytes, Stack size unknown bytes, NeutronFirmwarePrivate.c.o(.text.NeutronMicroInstrPre))

[Calls]

- >> traceEvent

[Called By]

- >> neutronFwInterpreter

OSA_MutexCreate (Thumb, 38 bytes, Stack size 0 bytes, fsl_os_abstraction_bm.o(.text.OSA_MutexCreate))

[Stack]

- Max Depth = 136
- Call Chain = OSA_MutexCreate ⇒ __aeabi_assert ⇒ DbgConsole_Printf ⇒ DbgConsole_Vprintf ⇒ memcpy

[Calls]

- >> __aeabi_assert

[Called By]

- >> SDMMC_OSAMutexCreate

OSA_MutexLock (Thumb, 44 bytes, Stack size 0 bytes, fsl_os_abstraction_bm.o(.text.OSA_MutexLock))

[Called By]

- >> SDMMC_OSAMutexLock

OSA_MutexUnlock (Thumb, 48 bytes, Stack size 0 bytes, fsl_os_abstraction_bm.o(.text.OSA_MutexUnlock))

[Stack]

- Max Depth = 136
- Call Chain = OSA_MutexUnlock ⇒ __aeabi_assert ⇒ DbgConsole_Printf ⇒ DbgConsole_Vprintf ⇒ memcpy

[Calls]

- >> __aeabi_assert

[Called By]

- >> SDMMC_OSAMutexUnlock

PARAM_init (Thumb, 142 bytes, Stack size 8 bytes, zf_driver_sd.o(.text.PARAM_init))

[Stack]

- Max Depth = 616 + Unknown Stack Size
- Call Chain = PARAM_init ⇒ sd_read_data ⇒ SD_ReadBlocks ⇒ SD_Transfer ⇒ SDMMCHOST_ExecuteTuning ⇒ SDMMCHOST_TransferFunction ⇒ USDHC_TransferBlocking ⇒ USDHC_SetAdmaTableConfig ⇒ USDHC_SetADMA2Descriptor ⇒ __aeabi_assert ⇒ DbgConsole_Printf ⇒ DbgConsole_Vprintf ⇒ memcpy

[Calls]

- >> sd_read_data
- >> memset

[Called By]

- >> main

PLU_DriverIRQHandler (Thumb, 4 bytes, Stack size 0 bytes, zf_driver_ezh.o(.text.PLU_DriverIRQHandler))

[Stack]

- Max Depth = 144
- Call Chain = PLU_DriverIRQHandler ⇒ ezh_camera_display_callback ⇒ ezh_copy_slice_to_model_input ⇒ rgb565stridedtorgb888(unsigned short const*, int, int, int, int, int, unsigned char*, int, unsigned char) ⇒ memcpy

[Calls]

- >> ezh_camera_display_callback

[Address Reference Count : 1]

- startup_mcxn947_cm33_core0.o(.text)

Pad (Thumb, 288 bytes, Stack size unknown bytes, NeutronKernels.c.o(.text.Pad))

[Calls]

- >> EXEC

[Called By]

- >> CallKernel

RESET_ClearPeripheralReset (Thumb, 66 bytes, Stack size 0 bytes, fsl_reset.o(.text.RESET_ClearPeripheralReset))

[Stack]

- Max Depth = 136
- Call Chain = RESET_ClearPeripheralReset ⇒ __aeabi_assert ⇒ DbgConsole_Printf ⇒ DbgConsole_Vprintf ⇒ memcpy

[Calls]

- >> __aeabi_assert

[Called By]

- >> EDMA_Init
- >> LP_FLEXCOMM_Init
- >> INPUTMUX_Init

RESET_PeripheralReset (Thumb, 82 bytes, Stack size 8 bytes, fsl_reset.o(.text.RESET_PeripheralReset))

[Stack]

- Max Depth = 144
- Call Chain = RESET_PeripheralReset ⇒ __aeabi_assert ⇒ DbgConsole_Printf ⇒ DbgConsole_Vprintf ⇒ memcpy

[Calls]

- >> __aeabi_assert

[Called By]

- >> ezh_start
- >> SMARTDMA_Init

RESET_SetPeripheralReset (Thumb, 64 bytes, Stack size 0 bytes, fsl_reset.o(.text.RESET_SetPeripheralReset))

[Stack]

- Max Depth = 136
- Call Chain = RESET_SetPeripheralReset ⇒ __aeabi_assert ⇒ DbgConsole_Printf ⇒ DbgConsole_Vprintf ⇒ memcpy

[Calls]

- >> __aeabi_assert

[Called By]

- >> LP_FLEXCOMM_Deinit

SDK_DelayAtLeastUs (Thumb, 64 bytes, Stack size 8 bytes, fsl_common_arm.o(.text.SDK_DelayAtLeastUs))

[Stack]

- Max Depth = 144
- Call Chain = SDK_DelayAtLeastUs ⇒ __aeabi_assert ⇒ DbgConsole_Printf ⇒ DbgConsole_Vprintf ⇒ memcpy

[Calls]

- >> __aeabi_assert
- >> __aeabi_uldivmod

[Called By]

- >> SDMMC_OSADelayUs
- >> SDMMC_OSADelay

SDMMCHOST_CardDetectInit (Thumb, 38 bytes, Stack size 0 bytes, fsl_sdmmc_host.o(.text.SDMMCHOST_CardDetectInit))

[Called By]

- >> SD_HostInit

SDMMCHOST_ConvertDataToLittleEndian (Thumb, 86 bytes, Stack size 0 bytes, fsl_sdmmc_host.o(.text.SDMMCHOST_ConvertDataToLittleEndian))

[Called By]

- >> SD_ReadStatus
- >> SD_SendScr
- >> SD_SelectFunction

SDMMCHOST_ExecuteTuning (Thumb, 616 bytes, Stack size 120 bytes, fsl_sdmmc_host.o(.text.SDMMCHOST_ExecuteTuning))

[Stack]

- Max Depth = 384 + Unknown Stack Size
- Call Chain = SDMMCHOST_ExecuteTuning ⇒ SDMMCHOST_TransferFunction ⇒ USDHC_TransferBlocking ⇒ USDHC_SetAdmaTableConfig ⇒ USDHC_SetADMA2Descriptor ⇒ __aeabi_assert ⇒ DbgConsole_Printf ⇒ DbgConsole_Vprintf ⇒ memcpy

[Calls]

- >> USDHC_EnableStandardTuning
- >> USDHC_SetTuningDelay
- >> USDHC_AdjustDelayForManualTuning
- >> USDHC_EnableManualTuning
- >> USDHC_Reset
- >> SDMMCHOST_TransferFunction
- >> SDMMC_OSADelay
- >> __aeabi_memclr4
- >> memset

[Called By]

- >> SD_SelectBusTiming
- >> SD_Transfer

SDMMCHOST_Init (Thumb, 80 bytes, Stack size 8 bytes, fsl_sdmmc_host.o(.text.SDMMCHOST_Init))

[Stack]

- Max Depth = 168
- Call Chain = SDMMCHOST_Init ⇒ USDHC_Init ⇒ __aeabi_assert ⇒ DbgConsole_Printf ⇒ DbgConsole_Vprintf ⇒ memcpy

[Calls]

- >> __aeabi_assert
- >> USDHC_Init

[Called By]

- >> SD_HostInit

SDMMCHOST_PollingCardDetectStatus (Thumb, 276 bytes, Stack size 32 bytes, fsl_sdmmc_host.o(.text.SDMMCHOST_PollingCardDetectStatus))

[Stack]

- Max Depth = 176
- Call Chain = SDMMCHOST_PollingCardDetectStatus ⇒ SDMMC_OSADelay ⇒ SDK_DelayAtLeastUs ⇒ __aeabi_assert ⇒ DbgConsole_Printf ⇒ DbgConsole_Vprintf ⇒ memcpy

[Calls]

- >> __aeabi_assert
- >> SDMMC_OSADelay

[Called By]

- >> SD_PollingCardInsert

SDMMCHOST_SetCardBusWidth (Thumb, 26 bytes, Stack size 0 bytes, fsl_sdmmc_host.o(.text.SDMMCHOST_SetCardBusWidth))

[Called By]

- >> SD_CardInit

SDMMCHOST_SetCardPower (Thumb, 2 bytes, Stack size 0 bytes, fsl_sdmmc_host.o(.text.SDMMCHOST_SetCardPower))

[Called By]

- >> SD_CardInit
- >> SD_SetCardPower

SDMMCHOST_TransferFunction (Thumb, 100 bytes, Stack size 32 bytes, fsl_sdmmc_host.o(.text.SDMMCHOST_TransferFunction))

[Stack]

- Max Depth = 264
- Call Chain = SDMMCHOST_TransferFunction ⇒ USDHC_TransferBlocking ⇒ USDHC_SetAdmaTableConfig ⇒ USDHC_SetADMA2Descriptor ⇒ __aeabi_assert ⇒ DbgConsole_Printf ⇒ DbgConsole_Vprintf ⇒ memcpy

[Calls]

- >> USDHC_TransferBlocking
- >> USDHC_Reset
- >> memset

[Called By]

- >> SD_CardInit
- >> SD_WriteBlocks
- >> SDMMC_SetBlockSize
- >> SDMMC_GoIdle
- >> SDMMC_SelectCard
- >> SDMMC_SendApplicationCommand
- >> SD_PollingCardStatusBusy
- >> SD_SetDataBusWidth
- >> SD_SendScr
- >> SD_SelectFunction
- >> SD_Transfer
- >> SDMMCHOST_ExecuteTuning

SDMMC_GoIdle (Thumb, 46 bytes, Stack size 64 bytes, fsl_sdmmc_common.o(.text.SDMMC_GoIdle))

[Stack]

- Max Depth = 328 + Unknown Stack Size
- Call Chain = SDMMC_GoIdle ⇒ SDMMCHOST_TransferFunction ⇒ USDHC_TransferBlocking ⇒ USDHC_SetAdmaTableConfig ⇒ USDHC_SetADMA2Descriptor ⇒ __aeabi_assert ⇒ DbgConsole_Printf ⇒ DbgConsole_Vprintf ⇒ memcpy

[Calls]

- >> SDMMCHOST_TransferFunction
- >> __aeabi_memclr4

[Called By]

- >> SD_CardInit

SDMMC_OSADelay (Thumb, 20 bytes, Stack size 0 bytes, fsl_sdmmc_osa.o(.text.SDMMC_OSADelay))

[Stack]

- Max Depth = 144
- Call Chain = SDMMC_OSADelay ⇒ SDK_DelayAtLeastUs ⇒ __aeabi_assert ⇒ DbgConsole_Printf ⇒ DbgConsole_Vprintf ⇒ memcpy

[Calls]

- >> SDK_DelayAtLeastUs

[Called By]

- >> SD_CardInit
- >> SD_SetCardPower
- >> SD_PollingCardInsert
- >> SDMMCHOST_ExecuteTuning
- >> SDMMCHOST_PollingCardDetectStatus

SDMMC_OSADelayUs (Thumb, 20 bytes, Stack size 8 bytes, fsl_sdmmc_osa.o(.text.SDMMC_OSADelayUs))

[Stack]

- Max Depth = 152
- Call Chain = SDMMC_OSADelayUs ⇒ SDK_DelayAtLeastUs ⇒ __aeabi_assert ⇒ DbgConsole_Printf ⇒ DbgConsole_Vprintf ⇒ memcpy

[Calls]

- >> SDK_DelayAtLeastUs

[Called By]

- >> SD_PollingCardStatusBusy

SDMMC_OSAMutexCreate (Thumb, 34 bytes, Stack size 8 bytes, fsl_sdmmc_osa.o(.text.SDMMC_OSAMutexCreate))

[Stack]

- Max Depth = 144
- Call Chain = SDMMC_OSAMutexCreate ⇒ __aeabi_assert ⇒ DbgConsole_Printf ⇒ DbgConsole_Vprintf ⇒ memcpy

[Calls]

- >> __aeabi_assert
- >> OSA_MutexCreate

[Called By]

- >> SD_CardInit

SDMMC_OSAMutexLock (Thumb, 34 bytes, Stack size 8 bytes, fsl_sdmmc_osa.o(.text.SDMMC_OSAMutexLock))

[Stack]

- Max Depth = 144
- Call Chain = SDMMC_OSAMutexLock ⇒ __aeabi_assert ⇒ DbgConsole_Printf ⇒ DbgConsole_Vprintf ⇒ memcpy

[Calls]

- >> __aeabi_assert
- >> OSA_MutexLock

[Called By]

- >> SD_CardInit
- >> SD_ReadBlocks
- >> SD_WriteBlocks

SDMMC_OSAMutexUnlock (Thumb, 34 bytes, Stack size 8 bytes, fsl_sdmmc_osa.o(.text.SDMMC_OSAMutexUnlock))

[Stack]

- Max Depth = 144
- Call Chain = SDMMC_OSAMutexUnlock ⇒ __aeabi_assert ⇒ DbgConsole_Printf ⇒ DbgConsole_Vprintf ⇒ memcpy

[Calls]

- >> __aeabi_assert
- >> OSA_MutexUnlock

[Called By]

- >> SD_CardInit
- >> SD_ReadBlocks
- >> SD_WriteBlocks

SDMMC_SD_CD_Callback (Thumb, 52 bytes, Stack size 24 bytes, sdmmc_config.o(.text.SDMMC_SD_CD_Callback))

[Stack]

- Max Depth = 160
- Call Chain = SDMMC_SD_CD_Callback ⇒ HAL_GpioGetInput ⇒ __aeabi_assert ⇒ DbgConsole_Printf ⇒ DbgConsole_Vprintf ⇒ memcpy

[Calls]

- >> HAL_GpioGetInput

[Address Reference Count : 1]

- sdmmc_config.o(.text.BOARD_SD_Config)

SDMMC_SelectCard (Thumb, 96 bytes, Stack size 72 bytes, fsl_sdmmc_common.o(.text.SDMMC_SelectCard))

[Stack]

- Max Depth = 336 + Unknown Stack Size
- Call Chain = SDMMC_SelectCard ⇒ SDMMCHOST_TransferFunction ⇒ USDHC_TransferBlocking ⇒ USDHC_SetAdmaTableConfig ⇒ USDHC_SetADMA2Descriptor ⇒ __aeabi_assert ⇒ DbgConsole_Printf ⇒ DbgConsole_Vprintf ⇒ memcpy

[Calls]

- >> SDMMCHOST_TransferFunction
- >> __aeabi_memclr4

[Called By]

- >> SD_CardInit

SDMMC_SendApplicationCommand (Thumb, 88 bytes, Stack size 72 bytes, fsl_sdmmc_common.o(.text.SDMMC_SendApplicationCommand))

[Stack]

- Max Depth = 336 + Unknown Stack Size
- Call Chain = SDMMC_SendApplicationCommand ⇒ SDMMCHOST_TransferFunction ⇒ USDHC_TransferBlocking ⇒ USDHC_SetAdmaTableConfig ⇒ USDHC_SetADMA2Descriptor ⇒ __aeabi_assert ⇒ DbgConsole_Printf ⇒ DbgConsole_Vprintf ⇒ memcpy

[Calls]

- >> SDMMCHOST_TransferFunction
- >> __aeabi_memclr4

[Called By]

- >> SD_CardInit
- >> SD_WriteBlocks
- >> SD_ReadStatus
- >> SD_SetDataBusWidth
- >> SD_SendScr

SDMMC_SetBlockSize (Thumb, 80 bytes, Stack size 72 bytes, fsl_sdmmc_common.o(.text.SDMMC_SetBlockSize))

[Stack]

- Max Depth = 336 + Unknown Stack Size
- Call Chain = SDMMC_SetBlockSize ⇒ SDMMCHOST_TransferFunction ⇒ USDHC_TransferBlocking ⇒ USDHC_SetAdmaTableConfig ⇒ USDHC_SetADMA2Descriptor ⇒ __aeabi_assert ⇒ DbgConsole_Printf ⇒ DbgConsole_Vprintf ⇒ memcpy

[Calls]

- >> SDMMCHOST_TransferFunction
- >> __aeabi_memclr4

[Called By]

- >> SD_CardInit

SD_CardInit (Thumb, 1712 bytes, Stack size 88 bytes, fsl_sd.o(.text.SD_CardInit))

[Stack]

- Max Depth = 640 + Unknown Stack Size
- Call Chain = SD_CardInit ⇒ SD_ReadStatus ⇒ SD_Transfer ⇒ SDMMCHOST_ExecuteTuning ⇒ SDMMCHOST_TransferFunction ⇒ USDHC_TransferBlocking ⇒ USDHC_SetAdmaTableConfig ⇒ USDHC_SetADMA2Descriptor ⇒ __aeabi_assert ⇒ DbgConsole_Printf ⇒ DbgConsole_Vprintf ⇒ memcpy

[Calls]

- >> __aeabi_assert
- >> USDHC_SetCardActive
- >> USDHC_SetSdClock
- >> SDMMC_SetBlockSize
- >> SDMMC_GoIdle
- >> SDMMC_SelectCard
- >> SDMMC_SendApplicationCommand
- >> SD_ReadStatus
- >> SD_SelectBusTiming
- >> SD_SetDataBusWidth
- >> SD_SendScr
- >> SDMMC_OSAMutexUnlock
- >> SDMMC_OSAMutexLock
- >> SDMMC_OSAMutexCreate
- >> SDMMCHOST_SetCardBusWidth
- >> SDMMCHOST_SetCardPower
- >> SDMMCHOST_TransferFunction
- >> SDMMC_OSADelay
- >> __aeabi_memclr4
- >> memcpy

[Called By]

- >> sd_card_init

SD_HostInit (Thumb, 104 bytes, Stack size 8 bytes, fsl_sd.o(.text.SD_HostInit))

[Stack]

- Max Depth = 176
- Call Chain = SD_HostInit ⇒ SDMMCHOST_Init ⇒ USDHC_Init ⇒ __aeabi_assert ⇒ DbgConsole_Printf ⇒ DbgConsole_Vprintf ⇒ memcpy

[Calls]

- >> __aeabi_assert
- >> SDMMCHOST_Init
- >> SDMMCHOST_CardDetectInit

[Called By]

- >> sd_card_init

SD_PollingCardInsert (Thumb, 150 bytes, Stack size 16 bytes, fsl_sd.o(.text.SD_PollingCardInsert))

[Stack]

- Max Depth = 192
- Call Chain = SD_PollingCardInsert ⇒ SDMMCHOST_PollingCardDetectStatus ⇒ SDMMC_OSADelay ⇒ SDK_DelayAtLeastUs ⇒ __aeabi_assert ⇒ DbgConsole_Printf ⇒ DbgConsole_Vprintf ⇒ memcpy

[Calls]

- >> __aeabi_assert
- >> SDMMCHOST_PollingCardDetectStatus
- >> SDMMC_OSADelay

[Called By]

- >> sd_card_init

SD_PollingCardStatusBusy (Thumb, 194 bytes, Stack size 88 bytes, fsl_sd.o(.text.SD_PollingCardStatusBusy))

[Stack]

- Max Depth = 352 + Unknown Stack Size
- Call Chain = SD_PollingCardStatusBusy ⇒ SDMMCHOST_TransferFunction ⇒ USDHC_TransferBlocking ⇒ USDHC_SetAdmaTableConfig ⇒ USDHC_SetADMA2Descriptor ⇒ __aeabi_assert ⇒ DbgConsole_Printf ⇒ DbgConsole_Vprintf ⇒ memcpy

[Calls]

- >> __aeabi_assert
- >> SDMMC_OSADelayUs
- >> SDMMCHOST_TransferFunction
- >> __aeabi_memclr4

[Called By]

- >> SD_ReadBlocks
- >> SD_WriteBlocks
- >> SD_ReadStatus
- >> SD_Transfer

SD_ReadBlocks (Thumb, 540 bytes, Stack size 120 bytes, fsl_sd.o(.text.SD_ReadBlocks))

[Stack]

- Max Depth = 592 + Unknown Stack Size
- Call Chain = SD_ReadBlocks ⇒ SD_Transfer ⇒ SDMMCHOST_ExecuteTuning ⇒ SDMMCHOST_TransferFunction ⇒ USDHC_TransferBlocking ⇒ USDHC_SetAdmaTableConfig ⇒ USDHC_SetADMA2Descriptor ⇒ __aeabi_assert ⇒ DbgConsole_Printf ⇒ DbgConsole_Vprintf ⇒ memcpy

[Calls]

- >> __aeabi_assert
- >> SD_PollingCardStatusBusy
- >> SD_Transfer
- >> SDMMC_OSAMutexUnlock
- >> SDMMC_OSAMutexLock
- >> __aeabi_memclr4
- >> memset
- >> memcpy

[Called By]

- >> sd_read_data

SD_ReadStatus (Thumb, 316 bytes, Stack size 80 bytes, fsl_sd.o(.text.SD_ReadStatus))

[Stack]

- Max Depth = 552 + Unknown Stack Size
- Call Chain = SD_ReadStatus ⇒ SD_Transfer ⇒ SDMMCHOST_ExecuteTuning ⇒ SDMMCHOST_TransferFunction ⇒ USDHC_TransferBlocking ⇒ USDHC_SetAdmaTableConfig ⇒ USDHC_SetADMA2Descriptor ⇒ __aeabi_assert ⇒ DbgConsole_Printf ⇒ DbgConsole_Vprintf ⇒ memcpy

[Calls]

- >> __aeabi_assert
- >> SDMMC_SendApplicationCommand
- >> SD_PollingCardStatusBusy
- >> SD_Transfer
- >> SDMMCHOST_ConvertDataToLittleEndian
- >> __aeabi_memclr4
- >> memset

[Called By]

- >> SD_CardInit

SD_SetCardPower (Thumb, 88 bytes, Stack size 16 bytes, fsl_sd.o(.text.SD_SetCardPower))

[Stack]

- Max Depth = 160
- Call Chain = SD_SetCardPower ⇒ SDMMC_OSADelay ⇒ SDK_DelayAtLeastUs ⇒ __aeabi_assert ⇒ DbgConsole_Printf ⇒ DbgConsole_Vprintf ⇒ memcpy

[Calls]

- >> __aeabi_assert
- >> SDMMCHOST_SetCardPower
- >> SDMMC_OSADelay

[Called By]

- >> sd_card_init

SD_WriteBlocks (Thumb, 700 bytes, Stack size 192 bytes, fsl_sd.o(.text.SD_WriteBlocks))

[Stack]

- Max Depth = 664 + Unknown Stack Size
- Call Chain = SD_WriteBlocks ⇒ SD_Transfer ⇒ SDMMCHOST_ExecuteTuning ⇒ SDMMCHOST_TransferFunction ⇒ USDHC_TransferBlocking ⇒ USDHC_SetAdmaTableConfig ⇒ USDHC_SetADMA2Descriptor ⇒ __aeabi_assert ⇒ DbgConsole_Printf ⇒ DbgConsole_Vprintf ⇒ memcpy

[Calls]

- >> __aeabi_assert
- >> SDMMC_SendApplicationCommand
- >> SD_PollingCardStatusBusy
- >> SD_Transfer
- >> SDMMC_OSAMutexUnlock
- >> SDMMC_OSAMutexLock
- >> SDMMCHOST_TransferFunction
- >> __aeabi_memclr4
- >> memset
- >> memcpy

[Called By]

- >> sd_write_data

SMARTDMA_Boot (Thumb, 38 bytes, Stack size 0 bytes, fsl_smartdma.o(.text.SMARTDMA_Boot))

[Called By]

- >> ezh_start
- >> ezh_camera_display_callback

SMARTDMA_HandleIRQ (Thumb, 28 bytes, Stack size 0 bytes, fsl_smartdma.o(.text.SMARTDMA_HandleIRQ))

[Called By]

- >> SMARTDMA_IRQHandler

SMARTDMA_IRQHandler (Thumb, 4 bytes, Stack size 0 bytes, fsl_smartdma_mcxn.o(.text.SMARTDMA_IRQHandler))

[Calls]

- >> SMARTDMA_HandleIRQ

[Address Reference Count : 1]

- startup_mcxn947_cm33_core0.o(.isr_vector)

SMARTDMA_Init (Thumb, 70 bytes, Stack size 16 bytes, fsl_smartdma.o(.text.SMARTDMA_Init))

[Stack]

- Max Depth = 160
- Call Chain = SMARTDMA_Init ⇒ RESET_PeripheralReset ⇒ __aeabi_assert ⇒ DbgConsole_Printf ⇒ DbgConsole_Vprintf ⇒ memcpy

[Calls]

- >> RESET_PeripheralReset
- >> memcpy

[Called By]

- >> ezh_start

SMARTDMA_InstallCallback (Thumb, 22 bytes, Stack size 0 bytes, fsl_smartdma.o(.text.SMARTDMA_InstallCallback))

[Called By]

- >> ezh_start

SPC_SetActiveModeCoreLDORegulatorConfig (Thumb, 190 bytes, Stack size 0 bytes, fsl_spc.o(.text.SPC_SetActiveModeCoreLDORegulatorConfig))

[Stack]

- Max Depth = 136
- Call Chain = SPC_SetActiveModeCoreLDORegulatorConfig ⇒ __aeabi_assert ⇒ DbgConsole_Printf ⇒ DbgConsole_Vprintf ⇒ memcpy

[Calls]

- >> __aeabi_assert

[Called By]

- >> BOARD_BootClockPLL150M

SPC_SetActiveModeDCDCRegulatorConfig (Thumb, 130 bytes, Stack size 0 bytes, fsl_spc.o(.text.SPC_SetActiveModeDCDCRegulatorConfig))

[Stack]

- Max Depth = 136
- Call Chain = SPC_SetActiveModeDCDCRegulatorConfig ⇒ __aeabi_assert ⇒ DbgConsole_Printf ⇒ DbgConsole_Vprintf ⇒ memcpy

[Calls]

- >> __aeabi_assert

[Called By]

- >> BOARD_BootClockPLL150M
- >> BOARD_PowerMode_OD

SPC_SetSRAMOperateVoltage (Thumb, 68 bytes, Stack size 0 bytes, fsl_spc.o(.text.SPC_SetSRAMOperateVoltage))

[Stack]

- Max Depth = 136
- Call Chain = SPC_SetSRAMOperateVoltage ⇒ __aeabi_assert ⇒ DbgConsole_Printf ⇒ DbgConsole_Vprintf ⇒ memcpy

[Calls]

- >> __aeabi_assert

[Called By]

- >> BOARD_BootClockPLL150M
- >> BOARD_PowerMode_OD

Sequence (Thumb, 108 bytes, Stack size unknown bytes, NeutronKernels.c.o(.text.Sequence))

[Calls]

- >> __wfe
- >> relocateData

[Called By]

- >> CallKernel

Slice (Thumb, 1368 bytes, Stack size unknown bytes, NeutronKernels.c.o(.text.Slice))

[Calls]

- >> EXEC
- >> neutron_done

[Called By]

- >> CallKernel

SystemInit (Thumb, 196 bytes, Stack size 0 bytes, system_mcxn947_cm33_core0.o(.text.SystemInit))
[Address Reference Count : 1]

- startup_mcxn947_cm33_core0.o(.text)

SystemInitHook (Thumb, 2 bytes, Stack size 0 bytes, system_mcxn947_cm33_core0.o(.text.SystemInitHook), UNUSED)

TfLiteIntArrayEqual (Thumb, 44 bytes, Stack size unknown bytes, common.o(.text.TfLiteIntArrayEqual))

[Stack]

- Max Depth = 8 + Unknown Stack Size
- Call Chain = TfLiteIntArrayEqual ⇒ memcmp

[Calls]

- >> memcmp

[Called By]

- >> tflite::HaveSameShapes(TfLiteTensor const*, TfLiteTensor const*)

TfLiteIntArrayGetSizeInBytes (Thumb, 6 bytes, Stack size unknown bytes, common.o(.text.TfLiteIntArrayGetSizeInBytes))

[Called By]

- >> tflite::internal::InitializeTfLiteTensorFromFlatbuffer(tflite::IPersistentBufferAllocator*, tflite::INonPersistentBufferAllocator*, bool, tflite::Tensor const&, flatbuffers::Vector⟨flatbuffers::Offset⟨tflite::Buffer⟩⟩ const*, TfLiteTensor*)

TfLiteTypeGetName (Thumb, 24 bytes, Stack size unknown bytes, common.o(.text.TfLiteTypeGetName))

[Called By]

- >> tflite::(anonymous namespace)::SoftmaxEval(TfLiteContext*, TfLiteNode*)
- >> tflite::(anonymous namespace)::Eval(TfLiteContext*, TfLiteNode*)
- >> tflite::(anonymous namespace)::Eval(TfLiteContext*, TfLiteNode*)
- >> tflite::EvalQuantizeReference(TfLiteContext*, TfLiteNode*)
- >> tflite::PoolingPrepare(TfLiteContext*, TfLiteNode*)
- >> tflite::(anonymous namespace)::MaxEval(TfLiteContext*, TfLiteNode*)
- >> tflite::(anonymous namespace)::Eval(TfLiteContext*, TfLiteNode*)
- >> tflite::DequantizeEval(TfLiteContext*, TfLiteNode*)
- >> tflite::(anonymous namespace)::Eval(TfLiteContext*, TfLiteNode*)
- >> tflite::(anonymous namespace)::Eval(TfLiteContext*, TfLiteNode*)
- >> tflite::(anonymous namespace)::Eval(TfLiteContext*, TfLiteNode*)
- >> tflite::(anonymous namespace)::Prepare(TfLiteContext*, TfLiteNode*)
- >> tflite::EvalAdd(TfLiteContext*, TfLiteNode*)
- >> tflite::(anonymous namespace)::EvalAdd(TfLiteContext*, TfLiteNode*, TfLiteAddParams*, tflite::(anonymous namespace)::OpData const*, TfLiteEvalTensor const*, TfLiteEvalTensor const*, TfLiteEvalTensor*) (.constprop.0)
- >> tflite::CalculateSoftmaxParams(TfLiteContext*, TfLiteTensor const*, TfLiteTensor*, TfLiteSoftmaxParams const*, tflite::SoftmaxParams*) (.part.0)

UART5_IRQHandler (Thumb, 212 bytes, Stack size 0 bytes, main.o(.text.UART5_IRQHandler))

[Called By]

- >> LP_FLEXCOMM5_IRQHandler

USDHC0_DriverIRQHandler (Thumb, 30 bytes, Stack size 0 bytes, fsl_usdhc.o(.text.USDHC0_DriverIRQHandler))
[Address Reference Count : 1]

- startup_mcxn947_cm33_core0.o(.text)

USDHC_AdjustDelayForManualTuning (Thumb, 20 bytes, Stack size 0 bytes, fsl_usdhc.o(.text.USDHC_AdjustDelayForManualTuning))

[Called By]

- >> SDMMCHOST_ExecuteTuning

USDHC_EnableDDRMode (Thumb, 66 bytes, Stack size 0 bytes, fsl_usdhc.o(.text.USDHC_EnableDDRMode))

[Called By]

- >> SD_SelectBusTiming

USDHC_EnableManualTuning (Thumb, 42 bytes, Stack size 0 bytes, fsl_usdhc.o(.text.USDHC_EnableManualTuning))

[Called By]

- >> SDMMCHOST_ExecuteTuning

USDHC_EnableStandardTuning (Thumb, 80 bytes, Stack size 0 bytes, fsl_usdhc.o(.text.USDHC_EnableStandardTuning))

[Called By]

- >> SDMMCHOST_ExecuteTuning

USDHC_Init (Thumb, 292 bytes, Stack size 24 bytes, fsl_usdhc.o(.text.USDHC_Init))

[Stack]

- Max Depth = 160
- Call Chain = USDHC_Init ⇒ __aeabi_assert ⇒ DbgConsole_Printf ⇒ DbgConsole_Vprintf ⇒ memcpy

[Calls]

- >> __aeabi_assert

[Called By]

- >> SDMMCHOST_Init

USDHC_Reset (Thumb, 42 bytes, Stack size 0 bytes, fsl_usdhc.o(.text.USDHC_Reset))

[Called By]

- >> SDMMCHOST_ExecuteTuning
- >> SDMMCHOST_TransferFunction

USDHC_SendCommand (Thumb, 160 bytes, Stack size 8 bytes, fsl_usdhc.o(.text.USDHC_SendCommand))

[Stack]

- Max Depth = 144
- Call Chain = USDHC_SendCommand ⇒ __aeabi_assert ⇒ DbgConsole_Printf ⇒ DbgConsole_Vprintf ⇒ memcpy

[Calls]

- >> __aeabi_assert

[Called By]

- >> USDHC_TransferBlocking

USDHC_SetADMA1Descriptor (Thumb, 232 bytes, Stack size 16 bytes, fsl_usdhc.o(.text.USDHC_SetADMA1Descriptor))

[Stack]

- Max Depth = 152
- Call Chain = USDHC_SetADMA1Descriptor ⇒ __aeabi_assert ⇒ DbgConsole_Printf ⇒ DbgConsole_Vprintf ⇒ memcpy

[Calls]

- >> __aeabi_assert

[Called By]

- >> USDHC_SetAdmaTableConfig

USDHC_SetADMA2Descriptor (Thumb, 302 bytes, Stack size 32 bytes, fsl_usdhc.o(.text.USDHC_SetADMA2Descriptor))

[Stack]

- Max Depth = 168
- Call Chain = USDHC_SetADMA2Descriptor ⇒ __aeabi_assert ⇒ DbgConsole_Printf ⇒ DbgConsole_Vprintf ⇒ memcpy

[Calls]

- >> __aeabi_assert

[Called By]

- >> USDHC_SetAdmaTableConfig

USDHC_SetAdmaTableConfig (Thumb, 352 bytes, Stack size 32 bytes, fsl_usdhc.o(.text.USDHC_SetAdmaTableConfig))

[Stack]

- Max Depth = 200
- Call Chain = USDHC_SetAdmaTableConfig ⇒ USDHC_SetADMA2Descriptor ⇒ __aeabi_assert ⇒ DbgConsole_Printf ⇒ DbgConsole_Vprintf ⇒ memcpy

[Calls]

- >> __aeabi_assert
- >> USDHC_SetADMA2Descriptor
- >> USDHC_SetADMA1Descriptor

[Called By]

- >> USDHC_TransferBlocking

USDHC_SetCardActive (Thumb, 34 bytes, Stack size 0 bytes, fsl_usdhc.o(.text.USDHC_SetCardActive))

[Called By]

- >> SD_CardInit

USDHC_SetSdClock (Thumb, 240 bytes, Stack size 16 bytes, fsl_usdhc.o(.text.USDHC_SetSdClock))

[Stack]

- Max Depth = 152
- Call Chain = USDHC_SetSdClock ⇒ __aeabi_assert ⇒ DbgConsole_Printf ⇒ DbgConsole_Vprintf ⇒ memcpy

[Calls]

- >> __aeabi_assert

[Called By]

- >> SD_CardInit
- >> SD_SelectBusTiming

USDHC_SetTuningDelay (Thumb, 132 bytes, Stack size 8 bytes, fsl_usdhc.o(.text.USDHC_SetTuningDelay))

[Stack]

- Max Depth = 144
- Call Chain = USDHC_SetTuningDelay ⇒ __aeabi_assert ⇒ DbgConsole_Printf ⇒ DbgConsole_Vprintf ⇒ memcpy

[Calls]

- >> __aeabi_assert

[Called By]

- >> SDMMCHOST_ExecuteTuning

USDHC_TransferBlocking (Thumb, 1036 bytes, Stack size 32 bytes, fsl_usdhc.o(.text.USDHC_TransferBlocking))

[Stack]

- Max Depth = 232
- Call Chain = USDHC_TransferBlocking ⇒ USDHC_SetAdmaTableConfig ⇒ USDHC_SetADMA2Descriptor ⇒ __aeabi_assert ⇒ DbgConsole_Printf ⇒ DbgConsole_Vprintf ⇒ memcpy

[Calls]

- >> __aeabi_assert
- >> USDHC_SetAdmaTableConfig
- >> USDHC_SendCommand
- >> USDHC_SetTransferConfig

[Called By]

- >> SDMMCHOST_TransferFunction

Upsample2DV1 (Thumb, 1264 bytes, Stack size unknown bytes, NeutronKernels.c.o(.text.Upsample2DV1))

[Calls]

- >> EXEC

[Called By]

- >> CallKernel

MicroPrintf(char const*, ...) (Thumb, 26 bytes, Stack size unknown bytes, micro_log.o(.text._Z11MicroPrintfPKcz))

[Stack]

- Max Depth = 128 + Unknown Stack Size
- Call Chain = MicroPrintf(char const*, ...) ⇒ VMicroPrintf(char const*, std::__va_list) ⇒ (anonymous namespace)::VDebugLog(char const*, ...) (.constprop.0) ⇒ DebugLog ⇒ vsnprintf ⇒ _printf_char_common ⇒ __printf

[Calls]

- >> VMicroPrintf(char const*, std::__va_list)

[Called By]

- >> tflite::MicroInterpreterContext::set_external_context(void*)
- >> tflite::MicroInterpreterGraph::InvokeSubgraph(int)
- >> tflite::MicroInterpreterGraph::PrepareSubgraphs()
- >> tflite::GetRegistrationFromOpCode(tflite::OperatorCode const*, tflite::MicroOpResolver const&, TFLMRegistration const**)
- >> tflite::MicroInterpreter::PrepareNodeAndRegistrationDataFromFlatbuffer()
- >> tflite::AllocationInfoBuilder::GetOfflinePlannedOffsets(long const**)
- >> tflite::AllocationInfoBuilder::CreateAllocationInfo(int)
- >> tflite::MicroAllocator::RequestScratchBufferInArena(unsigned int, int, int*)
- >> tflite::MicroAllocator::StartModelAllocation(tflite::Model const*)
- >> tflite::MicroAllocator::FinishModelAllocation(tflite::Model const*, tflite::SubgraphAllocations*, tflite::ScratchBufferHandle**)
- >> tflite::MicroAllocator::AllocateTfLiteEvalTensors(tflite::Model const*, tflite::SubgraphAllocations*)
- >> tflite::internal::InitializeTfLiteTensorFromFlatbuffer(tflite::IPersistentBufferAllocator*, tflite::INonPersistentBufferAllocator*, bool, tflite::Tensor const&, flatbuffers::Vector⟨flatbuffers::Offset⟨tflite::Buffer⟩⟩ const*, TfLiteTensor*)
- >> tflite::MicroAllocator::AllocateNodeAndRegistrations(tflite::Model const*, tflite::SubgraphAllocations*)
- >> tflite::MicroAllocator::AllocateVariables(tflite::SubGraph const*, TfLiteEvalTensor*, long const*)
- >> tflite::MicroAllocator::AllocateTempTfLiteTensor(tflite::Model const*, tflite::SubgraphAllocations const*, int, int)
- >> tflite::MicroAllocator::AllocatePersistentTfLiteTensor(tflite::Model const*, tflite::SubgraphAllocations const*, int, int)
- >> tflite::(anonymous namespace)::Eval(TfLiteContext*, TfLiteNode*)
- >> tflite::(anonymous namespace)::Prepare(TfLiteContext*, TfLiteNode*)
- >> tflite::(anonymous namespace)::Init(TfLiteContext*, char const*, unsigned int)
- >> tflite::(anonymous namespace)::Free(TfLiteContext*, void*)
- >> tflite::MicroMutableOpResolver⟨12u⟩::AddBuiltin(tflite::BuiltinOperator, TFLMRegistration const&, TfLiteStatus (*)(tflite::Operator const*, tflite::ErrorReporter*, tflite::BuiltinDataAllocator*, void**))
- >> tflite::MicroInterpreter::output(unsigned int)
- >> tflite::MicroInterpreter::input(unsigned int)
- >> tflite::MicroInterpreter::Invoke()
- >> tflite::MicroInterpreter::AllocateTensors()
- >> MODEL_GetOpsResolver()
- >> tflite::GreedyMemoryPlanner::GetOffsetForBuffer(int, int*)
- >> tflite::GreedyMemoryPlanner::PrintMemoryPlan()
- >> tflite::GreedyMemoryPlanner::AddBuffer(int, int, int)
- >> tflite::LinearMemoryPlanner::GetOffsetForBuffer(int, int*)
- >> tflite::LinearMemoryPlanner::AddBuffer(int, int, int)
- >> tflite::SingleArenaBufferAllocator::ResizeBuffer(unsigned char*, unsigned int, unsigned int)
- >> tflite::SingleArenaBufferAllocator::AllocatePersistentBuffer(unsigned int, unsigned int)
- >> tflite::SingleArenaBufferAllocator::ResetTempAllocations()
- >> tflite::SingleArenaBufferAllocator::IsAllTempDeallocated()
- >> tflite::SingleArenaBufferAllocator::AllocateTemp(unsigned int, unsigned int)
- >> tflite::AllocationInfoBuilder::ValidateSubgraph(tflite::SubGraph const*, TfLiteEvalTensor*)
- >> tflite::(anonymous namespace)::SoftmaxEval(TfLiteContext*, TfLiteNode*)
- >> tflite::(anonymous namespace)::Eval(TfLiteContext*, TfLiteNode*)
- >> tflite::(anonymous namespace)::Eval(TfLiteContext*, TfLiteNode*)
- >> tflite::(anonymous namespace)::Prepare(TfLiteContext*, TfLiteNode*)
- >> tflite::EvalQuantizeReference(TfLiteContext*, TfLiteNode*)
- >> tflite::PoolingPrepare(TfLiteContext*, TfLiteNode*)
- >> tflite::(anonymous namespace)::MaxEval(TfLiteContext*, TfLiteNode*)
- >> void tflite::reference_ops::PadImpl⟨short, short⟩(tflite::PadParams const&, tflite::RuntimeShape const&, short const*, short const*, tflite::RuntimeShape const&, short*)
- >> void tflite::reference_ops::PadImpl⟨signed char, signed char⟩(tflite::PadParams const&, tflite::RuntimeShape const&, signed char const*, signed char const*, tflite::RuntimeShape const&, signed char*)
- >> void tflite::reference_ops::PadImpl⟨float, float⟩(tflite::PadParams const&, tflite::RuntimeShape const&, float const*, float const*, tflite::RuntimeShape const&, float*)
- >> void tflite::reference_ops::PadImpl⟨long, long⟩(tflite::PadParams const&, tflite::RuntimeShape const&, long const*, long const*, tflite::RuntimeShape const&, long*)
- >> tflite::(anonymous namespace)::Eval(TfLiteContext*, TfLiteNode*)
- >> tflite::DequantizeEval(TfLiteContext*, TfLiteNode*)
- >> tflite::(anonymous namespace)::Eval(TfLiteContext*, TfLiteNode*)
- >> tflite::(anonymous namespace)::Eval(TfLiteContext*, TfLiteNode*)
- >> tflite::(anonymous namespace)::Eval(TfLiteContext*, TfLiteNode*)
- >> tflite::(anonymous namespace)::Prepare(TfLiteContext*, TfLiteNode*)
- >> tflite::EvalAdd(TfLiteContext*, TfLiteNode*)
- >> AbortImpl()
- >> tflite::(anonymous namespace)::EvalAdd(TfLiteContext*, TfLiteNode*, TfLiteAddParams*, tflite::(anonymous namespace)::OpData const*, TfLiteEvalTensor const*, TfLiteEvalTensor const*, TfLiteEvalTensor*) (.constprop.0)

VMicroPrintf(char const*, std::__va_list) (Thumb, 20 bytes, Stack size unknown bytes, micro_log.o(.text._Z12VMicroPrintfPKcSt9__va_list))

[Stack]

- Max Depth = 128 + Unknown Stack Size
- Call Chain = VMicroPrintf(char const*, std::__va_list) ⇒ (anonymous namespace)::VDebugLog(char const*, ...) (.constprop.0) ⇒ DebugLog ⇒ vsnprintf ⇒ _printf_char_common ⇒ __printf

[Calls]

- >> (anonymous namespace)::VDebugLog(char const*, ...) (.constprop.0)
- >> DebugLog

[Called By]

- >> tflite::MicroContextReportOpError(TfLiteContext*, char const*, ...)
- >> MicroPrintf(char const*, ...)
- >> tflite::MicroErrorReporter::Report(char const*, std::__va_list)

UPDATE_SETMODE(SetMode_t*) (Thumb, 704 bytes, Stack size 32 bytes, zf_model_process.o(.text._Z14UPDATE_SETMODEP9SetMode_t))

[Stack]

- Max Depth = 784 + Unknown Stack Size
- Call Chain = UPDATE_SETMODE(SetMode_t*) ⇒ MENU_SHOW(SetMode_t*, unsigned short, bool) ⇒ ips200_show_int ⇒ ips200_show_char ⇒ ips200_set_region ⇒ LPSPI_MasterTransferEDMA ⇒ LPSPI_MasterTransferEDMALite ⇒ EDMA_TcdSetTransferConfig ⇒ EDMA_ConfigChannelSoftwareTCD ⇒ __aeabi_assert ⇒ DbgConsole_Printf ⇒ DbgConsole_Vprintf ⇒ memcpy

[Calls]

- >> sd_write_data
- >> MENU_SHOW(SetMode_t*, unsigned short, bool)
- >> KEY_SCAN(Press_t*, Press_t*)
- >> scc8660_set_brightness

[Called By]

- >> zf_model_run

MODEL_GetOpsResolver() (Thumb, 504 bytes, Stack size 48 bytes, model_ops_npu.o(.text._Z20MODEL_GetOpsResolverv))

[Stack]

- Max Depth = 208 + Unknown Stack Size
- Call Chain = MODEL_GetOpsResolver() ⇒ tflite::MicroMutableOpResolver⟨12u⟩::AddBuiltin(tflite::BuiltinOperator, TFLMRegistration const&, TfLiteStatus (*)(tflite::Operator const*, tflite::ErrorReporter*, tflite::BuiltinDataAllocator*, void**)) ⇒ MicroPrintf(char const*, ...) ⇒ VMicroPrintf(char const*, std::__va_list) ⇒ (anonymous namespace)::VDebugLog(char const*, ...) (.constprop.0) ⇒ DebugLog ⇒ vsnprintf ⇒ _printf_char_common ⇒ __printf

[Calls]

- >> MicroPrintf(char const*, ...)
- >> tflite::Register_NEUTRON_GRAPH()
- >> tflite::GetString_NEUTRON_GRAPH()
- >> tflite::Register_DEQUANTIZE()
- >> tflite::Register_SOFTMAX()
- >> tflite::Register_ADD()
- >> tflite::Register_MAX_POOL_2D()
- >> tflite::Register_DEPTHWISE_CONV_2D()
- >> tflite::Register_CONV_2D()
- >> tflite::Register_RESIZE_NEAREST_NEIGHBOR()
- >> tflite::Register_QUANTIZE()
- >> tflite::Register_SLICE()
- >> tflite::Register_CONCATENATION()
- >> tflite::MicroMutableOpResolver⟨12u⟩::AddBuiltin(tflite::BuiltinOperator, TFLMRegistration const&, TfLiteStatus (*)(tflite::Operator const*, tflite::ErrorReporter*, tflite::BuiltinDataAllocator*, void**))
- >> tflite::Register_PAD()
- >> __cxa_guard_release
- >> __cxa_guard_acquire
- >> __cxa_atexit

[Called By]

- >> MODEL_Init

rgb565stridedtorgb888(unsigned short const*, int, int, int, int, int, unsigned char*, int, unsigned char) (Thumb, 268 bytes, Stack size 72 bytes, zf_model_process.o(.text._Z21rgb565stridedtorgb888PKtiiiiiPhih))

[Stack]

- Max Depth = 80
- Call Chain = rgb565stridedtorgb888(unsigned short const*, int, int, int, int, int, unsigned char*, int, unsigned char) ⇒ memcpy

[Calls]

- >> memcpy

[Called By]

- >> ezh_copy_slice_to_model_input

draw_rect_on_slice_buffer(unsigned short*, int, int, int, tagodresult_t*, int, int) (Thumb, 284 bytes, Stack size 48 bytes, zf_model_process.o(.text._Z25draw_rect_on_slice_bufferPtiiiP13tagodresult_tii))

[Stack]

- Max Depth = 60
- Call Chain = draw_rect_on_slice_buffer(unsigned short*, int, int, int, tagodresult_t*, int, int) ⇒ memset ⇒ _memset ⇒ _memset_w

[Calls]

- >> memset

[Called By]

- >> zf_model_run

KEY_SCAN(Press_t*, Press_t*) (Thumb, 184 bytes, Stack size 24 bytes, zf_model_process.o(.text._Z8KEY_SCANP7Press_tS0_))

[Stack]

- Max Depth = 24
- Call Chain = KEY_SCAN(Press_t*, Press_t*)

[Calls]

- >> gpio_get_level
- >> system_delay_ms

[Called By]

- >> UPDATE_SETMODE(SetMode_t*)

AbortImpl() (Thumb, 16 bytes, Stack size unknown bytes, add.o(.text._Z9AbortImplv))

[Stack]

- Max Depth = 128 + Unknown Stack Size
- Call Chain = AbortImpl() ⇒ MicroPrintf(char const*, ...) ⇒ VMicroPrintf(char const*, std::__va_list) ⇒ (anonymous namespace)::VDebugLog(char const*, ...) (.constprop.0) ⇒ DebugLog ⇒ vsnprintf ⇒ _printf_char_common ⇒ __printf

[Calls]

- >> MicroPrintf(char const*, ...)

[Called By]

- >> tflite::QuantizeMultiplier(double, long*, int*)
- >> tflite::reference_ops::ProcessBroadcastShapes(tflite::RuntimeShape const&, tflite::RuntimeShape const&, tflite::ArithmeticParams*)
- >> tflite::QuantizeMultiplierSmallerThanOneExp(double, long*, int*)
- >> tflite::(anonymous namespace)::EvalAdd(TfLiteContext*, TfLiteNode*, TfLiteAddParams*, tflite::(anonymous namespace)::OpData const*, TfLiteEvalTensor const*, TfLiteEvalTensor const*, TfLiteEvalTensor*) (.constprop.0)
- >> tflite::(anonymous namespace)::EvalAddQuantizedInt16(TfLiteContext*, TfLiteNode*, TfLiteAddParams*, tflite::(anonymous namespace)::OpData const*, TfLiteEvalTensor const*, TfLiteEvalTensor const*, TfLiteEvalTensor*) (.constprop.0)
- >> tflite::(anonymous namespace)::EvalAddQuantizedInt8(TfLiteContext*, TfLiteNode*, TfLiteAddParams*, tflite::(anonymous namespace)::OpData const*, TfLiteEvalTensor const*, TfLiteEvalTensor const*, TfLiteEvalTensor*) (.constprop.0)
- >> tflite::QuantizeMultiplierGreaterThanOne(double, long*, int*)

MENU_SHOW(SetMode_t*, unsigned short, bool) (Thumb, 592 bytes, Stack size 24 bytes, zf_model_process.o(.text._Z9MENU_SHOWP9SetMode_ttb))

[Stack]

- Max Depth = 752 + Unknown Stack Size
- Call Chain = MENU_SHOW(SetMode_t*, unsigned short, bool) ⇒ ips200_show_int ⇒ ips200_show_char ⇒ ips200_set_region ⇒ LPSPI_MasterTransferEDMA ⇒ LPSPI_MasterTransferEDMALite ⇒ EDMA_TcdSetTransferConfig ⇒ EDMA_ConfigChannelSoftwareTCD ⇒ __aeabi_assert ⇒ DbgConsole_Printf ⇒ DbgConsole_Vprintf ⇒ memcpy

[Calls]

- >> ips200_draw_line
- >> ips200_show_int
- >> ips200_show_string

[Called By]

- >> UPDATE_SETMODE(SetMode_t*)

flatbuffers::Vector⟨long⟩ const* flatbuffers::Table::GetPointer⟨flatbuffers::Vector⟨long⟩ const*⟩(unsigned short) (Thumb, 18 bytes, Stack size unknown bytes, micro_interpreter.o(.text._ZN11flatbuffers5Table10GetPointerIPKNS_6VectorIlEEEET_t))

[Calls]

- >> flatbuffers::Table::GetOptionalFieldOffset(unsigned short) const

[Called By]

- >> tflite::MicroInterpreter::PrepareNodeAndRegistrationDataFromFlatbuffer()
- >> tflite::MicroInterpreter::outputs_size() const (.isra.0)
- >> tflite::MicroInterpreter::inputs_size() const (.isra.0)
- >> tflite::AllocationInfoBuilder::MarkAllocationLifetimes(int, tflite::internal::ScratchBufferRequest*, tflite::ScratchBufferHandle*, tflite::SubgraphAllocations*)
- >> tflite::MicroInterpreter::AllocateTensors()
- >> tflite::AllocationInfoBuilder::ValidateSubgraph(tflite::SubGraph const*, TfLiteEvalTensor*)
- >> tflite::MicroInterpreterGraph::NumSubgraphOutputs(int)
- >> tflite::MicroInterpreterGraph::NumSubgraphInputs(int)
- >> tflite::MicroInterpreterGraph::GetSubgraphOutput(int, int)
- >> tflite::MicroInterpreterGraph::GetSubgraphInput(int, int)

yolo::DetectorPostProcess::DoPostProcess() (Thumb, 496 bytes, Stack size 120 bytes, yolo_post_processing.o(.text._ZN4yolo19DetectorPostProcess13DoPostProcessEv))

[Stack]

- Max Depth = 352 + Unknown Stack Size
- Call Chain = yolo::DetectorPostProcess::DoPostProcess() ⇒ yolo::DetectorPostProcess::GetNetworkBoxes(yolo::object_detection::Network&, int, int, float, std::__2::forward_list⟨yolo::image::Detection, std::__2::allocator⟨yolo::image::Detection⟩⟩&) ⇒ operator new(unsigned int) ⇒ malloc ⇒ __Heap_Full ⇒ __Heap_ProvideMemory ⇒ free

[Calls]

- >> operator delete(void*)
- >> yolo::DetectorPostProcess::GetNetworkBoxes(yolo::object_detection::Network&, int, int, float, std::__2::forward_list⟨yolo::image::Detection, std::__2::allocator⟨yolo::image::Detection⟩⟩&)
- >> std::__throw_bad_array_new_length[abi:v16000]()
- >> operator new(unsigned int)
- >> yolo::image::CalculateNMS(std::__2::forward_list⟨yolo::image::Detection, std::__2::allocator⟨yolo::image::Detection⟩⟩&, int, float)
- >> __aeabi_memmove8
- >> abort
- >> __aeabi_f2d

[Called By]

- >> zf_model_run

[Address Reference Count : 1]

- yolo_post_processing.o(.rodata._ZTVN4yolo19DetectorPostProcessE)

yolo::DetectorPostProcess::GetNetworkBoxes(yolo::object_detection::Network&, int, int, float, std::__2::forward_list⟨yolo::image::Detection, std::__2::allocator⟨yolo::image::Detection⟩⟩&) (Thumb, 1674 bytes, Stack size 176 bytes, yolo_post_processing.o(.text._ZN4yolo19DetectorPostProcess15GetNetworkBoxesERNS_16object_detection7NetworkEiifRNSt3__212forward_listINS_5image9DetectionENS4_9allocatorIS7_EEEE))

[Stack]

- Max Depth = 232 + Unknown Stack Size
- Call Chain = yolo::DetectorPostProcess::GetNetworkBoxes(yolo::object_detection::Network&, int, int, float, std::__2::forward_list⟨yolo::image::Detection, std::__2::allocator⟨yolo::image::Detection⟩⟩&) ⇒ operator new(unsigned int) ⇒ malloc ⇒ __Heap_Full ⇒ __Heap_ProvideMemory ⇒ free

[Calls]

- >> operator delete(void*)
- >> std::__throw_bad_array_new_length[abi:v16000]()
- >> operator new(unsigned int)
- >> std::__2::__forward_list_node⟨yolo::image::Detection, void*⟩* std::__2::forward_list⟨yolo::image::Detection, std::__2::allocator⟨yolo::image::Detection⟩⟩::__sort⟨yolo::DetectorPostProcess::GetNetworkBoxes(yolo::object_detection::Network&, int, int, float, std::__2::forward_list⟨yolo::image::Detection, std::__2::allocator⟨yolo::image::Detection⟩⟩&)::$_1⟩(std::__2::__forward_list_node⟨yolo::image::Detection, void*⟩*, int, yolo::DetectorPostProcess::GetNetworkBoxes(yolo::object_detection::Network&, int, int, float, std::__2::forward_list⟨yolo::image::Detection, std::__2::allocator⟨yolo::image::Detection⟩⟩&)::$_1&)
- >> __aeabi_memmove4
- >> abort
- >> __hardfp_expf

[Called By]

- >> yolo::DetectorPostProcess::DoPostProcess()

yolo::DetectorPostProcess::DetectorPostProcess(TfLiteTensor const**, std::__2::vector⟨yolo::object_detection::DetectionResult, std::__2::allocator⟨yolo::object_detection::DetectionResult⟩⟩&, yolo::object_detection::PostProcessParams const&) (Thumb, 564 bytes, Stack size 120 bytes, yolo_post_processing.o(.text._ZN4yolo19DetectorPostProcessC2EPPK12TfLiteTensorRNSt3__26vectorINS_16object_detection15DetectionResultENS5_9allocatorIS8_EEEERKNS7_17PostProcessParamsE))

[Stack]

- Max Depth = 216 + Unknown Stack Size
- Call Chain = yolo::DetectorPostProcess::DetectorPostProcess(TfLiteTensor const**, std::__2::vector⟨yolo::object_detection::DetectionResult, std::__2::allocator⟨yolo::object_detection::DetectionResult⟩⟩&, yolo::object_detection::PostProcessParams const&) ⇒ std::__2::enable_if⟨__is_cpp17_forward_iterator⟨yolo::object_detection::Branch*⟩::value && is_constructible⟨yolo::object_detection::Branch, std::__2::iterator_traits⟨yolo::object_detection::Branch*⟩::reference⟩::value, void⟩::type std::__2::vector⟨yolo::object_detection::Branch, std::__2::allocator⟨yolo::object_detection::Branch⟩⟩::assign⟨yolo::object_detection::Branch*⟩(yolo::object_detection::Branch*, yolo::object_detection::Branch*) ⇒ operator new(unsigned int) ⇒ malloc ⇒ __Heap_Full ⇒ __Heap_ProvideMemory ⇒ free

[Calls]

- >> operator delete(void*)
- >> std::__throw_bad_array_new_length[abi:v16000]()
- >> std::__2::enable_if⟨__is_cpp17_forward_iterator⟨yolo::object_detection::Branch*⟩::value && is_constructible⟨yolo::object_detection::Branch, std::__2::iterator_traits⟨yolo::object_detection::Branch*⟩::reference⟩::value, void⟩::type std::__2::vector⟨yolo::object_detection::Branch, std::__2::allocator⟨yolo::object_detection::Branch⟩⟩::assign⟨yolo::object_detection::Branch*⟩(yolo::object_detection::Branch*, yolo::object_detection::Branch*)
- >> operator new(unsigned int)
- >> __aeabi_memmove4
- >> abort

[Called By]

- >> zf_model_run

yolo::DetectorPostProcess::DetectorPostProcess__sub_object(TfLiteTensor const**, std::__2::vector⟨yolo::object_detection::DetectionResult, std::__2::allocator⟨yolo::object_detection::DetectionResult⟩⟩&, yolo::object_detection::PostProcessParams const&) (Thumb, 564 bytes, Stack size 120 bytes, yolo_post_processing.o(.text._ZN4yolo19DetectorPostProcessC2EPPK12TfLiteTensorRNSt3__26vectorINS_16object_detection15DetectionResultENS5_9allocatorIS8_EEEERKNS7_17PostProcessParamsE), UNUSED)

yolo::DetectorPostProcess::~DetectorPostProcess__deallocating() (Thumb, 36 bytes, Stack size 8 bytes, yolo_post_processing.o(.text._ZN4yolo19DetectorPostProcessD0Ev))

[Stack]

- Max Depth = 24
- Call Chain = yolo::DetectorPostProcess::~DetectorPostProcess__deallocating() ⇒ operator delete(void*) ⇒ free

[Calls]

- >> operator delete(void*)

[Address Reference Count : 1]

- yolo_post_processing.o(.rodata._ZTVN4yolo19DetectorPostProcessE)

yolo::DetectorPostProcess::~DetectorPostProcess__sub_object() (Thumb, 30 bytes, Stack size 8 bytes, yolo_post_processing.o(.text._ZN4yolo19DetectorPostProcessD2Ev))

[Stack]

- Max Depth = 24
- Call Chain = yolo::DetectorPostProcess::~DetectorPostProcess__sub_object() ⇒ operator delete(void*) ⇒ free

[Calls]

- >> operator delete(void*)

[Address Reference Count : 1]

- yolo_post_processing.o(.rodata._ZTVN4yolo19DetectorPostProcessE)

yolo::image::CalculateNMS(std::__2::forward_list⟨yolo::image::Detection, std::__2::allocator⟨yolo::image::Detection⟩⟩&, int, float) (Thumb, 174 bytes, Stack size 56 bytes, yolo_post_processing.o(.text._ZN4yolo5image12CalculateNMSERNSt3__212forward_listINS0_9DetectionENS1_9allocatorIS3_EEEEif))

[Stack]

- Max Depth = 80
- Call Chain = yolo::image::CalculateNMS(std::__2::forward_list⟨yolo::image::Detection, std::__2::allocator⟨yolo::image::Detection⟩⟩&, int, float) ⇒ std::__2::__forward_list_node⟨yolo::image::Detection, void*⟩* std::__2::forward_list⟨yolo::image::Detection, std::__2::allocator⟨yolo::image::Detection⟩⟩::__sort⟨yolo::image::CalculateNMS(std::__2::forward_list⟨yolo::image::Detection, std::__2::allocator⟨yolo::image::Detection⟩⟩&, int, float)::$_0⟩(std::__2::__forward_list_node⟨yolo::image::Detection, void*⟩*, int, yolo::image::CalculateNMS(std::__2::forward_list⟨yolo::image::Detection, std::__2::allocator⟨yolo::image::Detection⟩⟩&, int, float)::$_0&) ⇒ std::__2::__forward_list_node⟨yolo::image::Detection, void*⟩* std::__2::forward_list⟨yolo::image::Detection, std::__2::allocator⟨yolo::image::Detection⟩⟩::__sort⟨yolo::image::CalculateNMS(std::__2::forward_list⟨yolo::image::Detection, std::__2::allocator⟨yolo::image::Detection⟩⟩&, int, float)::$_0⟩(std::__2::__forward_list_node⟨yolo::image::Detection, void*⟩*, int, yolo::image::CalculateNMS(std::__2::forward_list⟨yolo::image::Detection, std::__2::allocator⟨yolo::image::Detection⟩⟩&, int, float)::$_0&) (Cycle)

[Calls]

- >> yolo::image::CalculateBoxIOU(yolo::image::Box&, yolo::image::Box&)
- >> std::__2::__forward_list_node⟨yolo::image::Detection, void*⟩* std::__2::forward_list⟨yolo::image::Detection, std::__2::allocator⟨yolo::image::Detection⟩⟩::__sort⟨yolo::image::CalculateNMS(std::__2::forward_list⟨yolo::image::Detection, std::__2::allocator⟨yolo::image::Detection⟩⟩&, int, float)::$_0⟩(std::__2::__forward_list_node⟨yolo::image::Detection, void*⟩*, int, yolo::image::CalculateNMS(std::__2::forward_list⟨yolo::image::Detection, std::__2::allocator⟨yolo::image::Detection⟩⟩&, int, float)::$_0&)

[Called By]

- >> yolo::DetectorPostProcess::DoPostProcess()

yolo::image::CalculateBoxIOU(yolo::image::Box&, yolo::image::Box&) (Thumb, 300 bytes, Stack size 0 bytes, yolo_post_processing.o(.text._ZN4yolo5image15CalculateBoxIOUERNS0_3BoxES2_))

[Called By]

- >> yolo::image::CalculateNMS(std::__2::forward_list⟨yolo::image::Detection, std::__2::allocator⟨yolo::image::Detection⟩⟩&, int, float)

tflite::PadPrepare(TfLiteContext*, TfLiteNode*) (Thumb, 1100 bytes, Stack size unknown bytes, pad.o(.text._ZN6tflite10PadPrepareEP13TfLiteContextP10TfLiteNode))

[Stack]

- Max Depth = 16 + Unknown Stack Size
- Call Chain = tflite::PadPrepare(TfLiteContext*, TfLiteNode*) ⇒ __aeabi_f2d

[Calls]

- >> tflite::MicroContext::AllocateTempOutputTensor(TfLiteNode const*, int)
- >> tflite::MicroContext::AllocateTempInputTensor(TfLiteNode const*, int)
- >> tflite::GetTensorShape(TfLiteTensor const*)
- >> __aeabi_f2d

[Address Reference Count : 1]

- pad.o(.text._ZN6tflite12Register_PADEv)

tflite::ParseSlice(tflite::Operator const*, tflite::ErrorReporter*, tflite::BuiltinDataAllocator*, void**) (Thumb, 4 bytes, Stack size unknown bytes, flatbuffer_conversions.o(.text._ZN6tflite10ParseSliceEPKNS_8OperatorEPNS_13ErrorReporterEPNS_20BuiltinDataAllocatorEPPv))
[Address Reference Count : 1]

- model_ops_npu.o(.text._Z20MODEL_GetOpsResolverv)

tflite::PrepareAdd(TfLiteContext*, TfLiteNode*) (Thumb, 800 bytes, Stack size unknown bytes, add.o(.text._ZN6tflite10PrepareAddEP13TfLiteContextP10TfLiteNode))

[Stack]

- Max Depth = 208 + Unknown Stack Size
- Call Chain = tflite::PrepareAdd(TfLiteContext*, TfLiteNode*) ⇒ tflite::QuantizeMultiplierSmallerThanOneExp(double, long*, int*) ⇒ tflite::QuantizeMultiplier(double, long*, int*) ⇒ round ⇒ _drnd ⇒ __fpl_dnaninf ⇒ __dunder_d ⇒ _fp_trapveneer ⇒ _fp_trap ⇒ __rt_SIGFPE ⇒ __rt_SIGFPE_inner ⇒ __default_signal_display ⇒ _ttywrch

[Calls]

- >> tflite::MicroContext::AllocateTempOutputTensor(TfLiteNode const*, int)
- >> tflite::MicroContext::AllocateTempInputTensor(TfLiteNode const*, int)
- >> tflite::CalculateActivationRangeQuantized(TfLiteContext*, TfLiteFusedActivation, TfLiteTensor*, long*, long*)
- >> tflite::QuantizeMultiplierSmallerThanOneExp(double, long*, int*)
- >> tflite::HaveSameShapes(TfLiteTensor const*, TfLiteTensor const*)
- >> __aeabi_ddiv
- >> __aeabi_dadd
- >> __aeabi_f2d
- >> __aeabi_dmul

[Address Reference Count : 1]

- add.o(.text._ZN6tflite12Register_ADDEv)

tflite::AlignSizeUp(unsigned int, unsigned int) (Thumb, 12 bytes, Stack size unknown bytes, memory_helpers.o(.text._ZN6tflite11AlignSizeUpEjj))

[Called By]

- >> tflite::MicroAllocator::CommitStaticMemoryPlan(tflite::Model const*, tflite::SubgraphAllocations*, tflite::ScratchBufferHandle*)

tflite::ParseConv2D(tflite::Operator const*, tflite::ErrorReporter*, tflite::BuiltinDataAllocator*, void**) (Thumb, 190 bytes, Stack size unknown bytes, flatbuffer_conversions.o(.text._ZN6tflite11ParseConv2DEPKNS_8OperatorEPNS_13ErrorReporterEPNS_20BuiltinDataAllocatorEPPv))

[Stack]

- Max Depth = 12 + Unknown Stack Size
- Call Chain = tflite::ParseConv2D(tflite::Operator const*, tflite::ErrorReporter*, tflite::BuiltinDataAllocator*, void**) ⇒ memset ⇒ _memset ⇒ _memset_w

[Calls]

- >> signed char flatbuffers::Table::GetField⟨signed char⟩(unsigned short, signed char) const
- >> long flatbuffers::Table::GetField⟨long⟩(unsigned short, long) const
- >> tflite::Operator::builtin_options_type() const
- >> tflite::ConvertTensorType(tflite::TensorType, TfLiteType*, tflite::ErrorReporter*)
- >> tflite::Operator::builtin_options() const
- >> tflite::(anonymous namespace)::SafeBuiltinDataAllocator::BuiltinDataDeleter::operator()(void*) (.isra.0)
- >> tflite::(anonymous namespace)::ConvertPadding(tflite::Padding)
- >> memset

[Address Reference Count : 1]

- model_ops_npu.o(.text._Z20MODEL_GetOpsResolverv)

tflite::ElementCount(TfLiteIntArray const&) (Thumb, 28 bytes, Stack size unknown bytes, micro_utils.o(.text._ZN6tflite12ElementCountERK14TfLiteIntArray))

[Called By]

- >> tflite::EvalQuantizeReference(TfLiteContext*, TfLiteNode*)

tflite::MicroContext::AllocateTempInputTensor(TfLiteNode const*, int) (Thumb, 42 bytes, Stack size unknown bytes, micro_context.o(.text._ZN6tflite12MicroContext23AllocateTempInputTensorEPK10TfLiteNodei))

[Called By]

- >> tflite::(anonymous namespace)::Prepare(TfLiteContext*, TfLiteNode*)
- >> tflite::(anonymous namespace)::Prepare(TfLiteContext*, TfLiteNode*)
- >> tflite::(anonymous namespace)::Prepare(TfLiteContext*, TfLiteNode*)
- >> tflite::(anonymous namespace)::Prepare(TfLiteContext*, TfLiteNode*)
- >> tflite::PrepareQuantizeReference(TfLiteContext*, TfLiteNode*)
- >> tflite::PoolingPrepare(TfLiteContext*, TfLiteNode*)
- >> tflite::PadPrepare(TfLiteContext*, TfLiteNode*)
- >> tflite::DequantizePrepare(TfLiteContext*, TfLiteNode*)
- >> tflite::CalculateOpDataDepthwiseConv(TfLiteContext*, TfLiteNode*, TfLiteDepthwiseConvParams const&, int, int, int, int, int, int, TfLiteType, tflite::OpDataConv*)
- >> tflite::(anonymous namespace)::Prepare(TfLiteContext*, TfLiteNode*)
- >> tflite::CalculateOpDataConv(TfLiteContext*, TfLiteNode*, TfLiteConvParams const&, int, int, int, int, int, int, TfLiteType, tflite::OpDataConv*)
- >> tflite::(anonymous namespace)::Prepare(TfLiteContext*, TfLiteNode*)
- >> tflite::(anonymous namespace)::Prepare(TfLiteContext*, TfLiteNode*)
- >> tflite::PrepareAdd(TfLiteContext*, TfLiteNode*)

tflite::MicroContext::AllocateTempOutputTensor(TfLiteNode const*, int) (Thumb, 42 bytes, Stack size unknown bytes, micro_context.o(.text._ZN6tflite12MicroContext24AllocateTempOutputTensorEPK10TfLiteNodei))

[Called By]

- >> tflite::(anonymous namespace)::Prepare(TfLiteContext*, TfLiteNode*)
- >> tflite::(anonymous namespace)::Prepare(TfLiteContext*, TfLiteNode*)
- >> tflite::(anonymous namespace)::Prepare(TfLiteContext*, TfLiteNode*)
- >> tflite::PrepareQuantizeReference(TfLiteContext*, TfLiteNode*)
- >> tflite::PoolingPrepare(TfLiteContext*, TfLiteNode*)
- >> tflite::PadPrepare(TfLiteContext*, TfLiteNode*)
- >> tflite::DequantizePrepare(TfLiteContext*, TfLiteNode*)
- >> tflite::CalculateOpDataDepthwiseConv(TfLiteContext*, TfLiteNode*, TfLiteDepthwiseConvParams const&, int, int, int, int, int, int, TfLiteType, tflite::OpDataConv*)
- >> tflite::(anonymous namespace)::Prepare(TfLiteContext*, TfLiteNode*)
- >> tflite::CalculateOpDataConv(TfLiteContext*, TfLiteNode*, TfLiteConvParams const&, int, int, int, int, int, int, TfLiteType, tflite::OpDataConv*)
- >> tflite::(anonymous namespace)::Prepare(TfLiteContext*, TfLiteNode*)
- >> tflite::(anonymous namespace)::Prepare(TfLiteContext*, TfLiteNode*)
- >> tflite::PrepareAdd(TfLiteContext*, TfLiteNode*)

tflite::ParseSoftmax(tflite::Operator const*, tflite::ErrorReporter*, tflite::BuiltinDataAllocator*, void**) (Thumb, 80 bytes, Stack size unknown bytes, flatbuffer_conversions.o(.text._ZN6tflite12ParseSoftmaxEPKNS_8OperatorEPNS_13ErrorReporterEPNS_20BuiltinDataAllocatorEPPv))

[Calls]

- >> float flatbuffers::Table::GetField⟨float⟩(unsigned short, float) const
- >> tflite::Operator::builtin_options_type() const
- >> tflite::Operator::builtin_options() const

[Address Reference Count : 1]

- model_ops_npu.o(.text._Z20MODEL_GetOpsResolverv)

tflite::Register_ADD() (Thumb, 40 bytes, Stack size unknown bytes, add.o(.text._ZN6tflite12Register_ADDEv))

[Calls]

- >> tflite::micro::RegisterOp(void* (*)(TfLiteContext*, char const*, unsigned int), TfLiteStatus (*)(TfLiteContext*, TfLiteNode*), TfLiteStatus (*)(TfLiteContext*, TfLiteNode*), void (*)(TfLiteContext*, void*), void (*)(TfLiteContext*, void*))

[Called By]

- >> MODEL_GetOpsResolver()

tflite::Register_PAD() (Thumb, 40 bytes, Stack size unknown bytes, pad.o(.text._ZN6tflite12Register_PADEv))

[Calls]

- >> tflite::micro::RegisterOp(void* (*)(TfLiteContext*, char const*, unsigned int), TfLiteStatus (*)(TfLiteContext*, TfLiteNode*), TfLiteStatus (*)(TfLiteContext*, TfLiteNode*), void (*)(TfLiteContext*, void*), void (*)(TfLiteContext*, void*))

[Called By]

- >> MODEL_GetOpsResolver()

tflite::tensor_utils::UnpackDenseInt4IntoInt8(signed char const*, int, signed char*) (Thumb, 54 bytes, Stack size unknown bytes, portable_tensor_utils.o(.text._ZN6tflite12tensor_utils23UnpackDenseInt4IntoInt8EPKaiPa))

[Called By]

- >> tflite::micro::MakeUnpackedInt4Tensor(TfLiteContext*, int, TfLiteEvalTensor const*)

tflite::ErrorReporter::Report(char const*, ...) (Thumb, 28 bytes, Stack size unknown bytes, error_reporter.o(.text._ZN6tflite13ErrorReporter6ReportEPKcz))

[Called By]

- >> tflite::ConvertTensorType(tflite::TensorType, TfLiteType*, tflite::ErrorReporter*)

tflite::ParseQuantize(tflite::Operator const*, tflite::ErrorReporter*, tflite::BuiltinDataAllocator*, void**) (Thumb, 4 bytes, Stack size unknown bytes, flatbuffer_conversions.o(.text._ZN6tflite13ParseQuantizeEPKNS_8OperatorEPNS_13ErrorReporterEPNS_20BuiltinDataAllocatorEPPv))
[Address Reference Count : 1]

- model_ops_npu.o(.text._Z20MODEL_GetOpsResolverv)

tflite::reference_ops::ProcessBroadcastShapes(tflite::RuntimeShape const&, tflite::RuntimeShape const&, tflite::ArithmeticParams*) (Thumb, 442 bytes, Stack size unknown bytes, add.o(.text._ZN6tflite13reference_ops22ProcessBroadcastShapesERKNS_12RuntimeShapeES3_PNS_16ArithmeticParamsE))

[Stack]

- Max Depth = 128 + Unknown Stack Size
- Call Chain = tflite::reference_ops::ProcessBroadcastShapes(tflite::RuntimeShape const&, tflite::RuntimeShape const&, tflite::ArithmeticParams*) ⇒ AbortImpl() ⇒ MicroPrintf(char const*, ...) ⇒ VMicroPrintf(char const*, std::__va_list) ⇒ (anonymous namespace)::VDebugLog(char const*, ...) (.constprop.0) ⇒ DebugLog ⇒ vsnprintf ⇒ _printf_char_common ⇒ __printf

[Calls]

- >> AbortImpl()
- >> memcpy
- >> memcmp

[Called By]
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
