EveAaA/DEBUG_SmartCar_main/(list of files, drawings)

Other design files:
DEBUG_SmartCar_PCB/DEBUG_DRV8701_MotorDriver/DRV8701E双驱.eprj
DEBUG_SmartCar_PCB/DEBUG_SmartCar_MotherBoard_V3/OpenArt拓展板.eprj
DEBUG_SmartCar_PCB/DEBUG_SmartCar_MotherBoard_V3/OpenArt拓展板v1.4.eprj
DEBUG_SmartCar_PCB/DEBUG_SmartCar_MotherBoard_V3/智能母版V3.eprj
DEBUG_SmartCar_PCB/DEBUG_SmartCar_MotherBoard_V3/调参板V2.eprj
DEBUG_SmartCar_PCB/DEBUG_SmartCar_MotherBoard_V4/OpenArtV3改.eprj
DEBUG_SmartCar_PCB/DEBUG_SmartCar_MotherBoard_V4/灯板.eprj
DEBUG_SmartCar_PCB/DEBUG_SmartCar_MotherBoard_V4/调参板V3.eprj
