EveAaA/DEBUG_SmartCar_main/DEBUG_SmartCar_main/project/code/MyDrivers/Src/Uart.c

/**
  ******************************************************************************
  * @file    Uart.c
  * @author  戴骐阳
  * @brief   串口通讯
  *
    @verbatim

    @endverbatim
  * @{
**/

/*****************include**********************************************************/
#include "Uart.h"

/*************************************************************************************/

/*****************define*********************************************************/
UART _UART_FINDBORDER;
UART _UART_FINE_TUNING;
UART _UART_RECOGNIZE_PLACE;
const MainType_t  MAIN_TABLE[5]    = {None, WEAPONS, MATERIAL, TRANSPORTATION};
const char*     PLACE_TABLE_STR[16] = {"A", "B", "C", "D", "E", "F", "G", "H", "I", "J", "K", "L", "M", "N", "O"};
const char*     HUGE_PLACE_STR[3]  =  {"1", "2", "3"};
const Place_t     PLACE_TABLE[16]  = {nil, A, B, C, D, E, F, G, H, I, J, K, L, M, N, O};
CLASSIFYtypeDef   CLASSIFY_DATA    = {false, nil, None};
PLACEtypeDef      SMALL_PLACE_DATA = {false, nil, None};
PLACEtypeDef      BIG_PLACE_DATA   = {false, nil, None};
FINETUNINGtypeDef FINETUNING_DATA  = {0, false, 0.0f, 0.0f, 0.0f};
FINDBORDERtypeDef FINDBORDER_DATA  = {false, 0.0f, STRAIGHT};
FINDBORDERtypeDef HARDBORDER_DATA  = {false, 0.0f, STRAIGHT};
UnpackDataTypeDef UnpackFlag       = {false, false, false}; // 判断帧头帧尾是否到达
VOLUMEUPTypeDef   VOLUMEUP_DATA    = {0.0f, 0.0f};

/**@brief    初始化串口(外部调用)
-- @param    None
-- @return   None
-- @auther   戴骐阳
-- @date     2023/12/23
**/
void UART_Init(void)
{
    UART_init(&_UART_FINDBORDER, UART_FINDBORDER_CREW, UART_FINDBORDER);
    UART_init(&_UART_FINE_TUNING, UART_FINE_TUNING_CREW, UART_FINE_TUNING);
    UART_init(&_UART_RECOGNIZE_PLACE, UART_RECOGNIZE_PLACE_CREW, UART_RECOGNIZE_PLACE);
}

/**@brief    初始化串口(内部调用)
-- @param    传入结构体地址, 传入中断组
-- @return   None
-- @auther   戴骐阳
-- @date     2023/12/23
**/
void UART_init(UART *uart, IRQn_Type UART_PRIORITY, uart_index_enum UART_INDEX)
{
    uart->UART_INDEX = UART_INDEX;
	uart->index = 0;
	fifo_init(&uart->uart_data_fifo, FIFO_DATA_8BIT, uart->uart_get_data, 1024); // 初始化 fifo 挂载缓冲区
    switch (UART_INDEX)
    {
    case UART_FINDBORDER:
        uart_init(UART_INDEX, UART_BAUDRATE, UART1_TX_B12, UART1_RX_B13); // 初始化串口引脚
		interrupt_set_priority(UART_PRIORITY, 1); // 设置对应 UART_INDEX 的中断优先级为 0
		uart_rx_interrupt(UART_INDEX, ZF_ENABLE); // 开启 UART_INDEX 的接收中断
        break;
    case UART_FINE_TUNING:
        uart_init(UART_INDEX, UART_BAUDRATE, UART2_TX_B18, UART2_RX_B19);
		interrupt_set_priority(UART_PRIORITY, 2); // 设置对应 UART_INDEX 的中断优先级为 0
		uart_rx_interrupt(UART_INDEX, ZF_ENABLE); // 开启 UART_INDEX 的接收中断        
		break;
    case UART_RECOGNIZE_PLACE:
        uart_init(UART_INDEX, UART_BAUDRATE, UART4_TX_C16, UART4_RX_C17);
        interrupt_set_priority(UART_PRIORITY, 3); // 设置对应 UART_INDEX 的中断优先级为 0
		uart_rx_interrupt(UART_INDEX, ZF_ENABLE); // 开启 UART_INDEX 的接收中断   
        break;
    default:
        break;
    }
	
    uart_write_byte(UART_INDEX, '\r');        // 输出回车
    uart_write_byte(UART_INDEX, '\n');        // 输出换行
}

/**@brief    读取缓存当中的数据
-- @param    传入想要获取数据的结构体地址
-- @return   返回double类型数据
-- @auther   戴骐阳
-- @date     2023/12/23
**/
double UART_ReadBuffer(UART *uart)
{
    uart->fifo_data_count = fifo_used(&uart->uart_data_fifo);
    if (uart->fifo_data_count != 0)
    {
        fifo_read_buffer(&uart->uart_data_fifo, uart->fifo_get_data, &uart->fifo_data_count, FIFO_READ_AND_CLEAN);
        #if DEBUG_UART
            uart_write_buffer(uart->UART_INDEX, uart->fifo_get_data, uart->fifo_data_count);
        #endif
        // 因为从串口读取的数据为十六进制，所以可以直接强转double(带符号不影响)
        return (double)uart->fifo_get_data[0];
    }
    else
    {
        return NULL;
    }
}

/**
 * @brief: 对数据解包 (调用方法放在定时器中断函数当中)
 * @param: 串口结构体, 串口数据解包结构体
 * @return: 是否完成数据解包
 *
 */
void UART_UnpackData(UART *uart)
{

    uart->fifo_data_count = fifo_used(&uart->uart_data_fifo);
    if (uart->fifo_data_count != 0)
    {
        fifo_read_buffer(&uart->uart_data_fifo, uart->fifo_get_data, &uart->fifo_data_count, FIFO_READ_AND_CLEAN);    
		// 通过串口特殊编号判断是解包到哪个变量当中
        switch (uart->UART_INDEX)
        {
        case UART_FINDBORDER: // 找到目标板时的判断
		     if (uart->fifo_get_data[0] == 0x01)
			 {
				FINDBORDER_DATA.FINDBORDER_FLAG = true;
			 }
             else if (uart->fifo_get_data[0] == 0x00)
             {
                FINDBORDER_DATA.FINDBORDER_FLAG = false;
             }
             FINDBORDER_DATA.dx = (float)uart->fifo_get_data[1];
             if (uart->fifo_get_data[2] == 0x10)
             {
                FINDBORDER_DATA.dir = LEFT;
             }
             else if(uart->fifo_get_data[2] == 0x11)
             {
                FINDBORDER_DATA.dir = RIGHT;
             }
             else if(uart->fifo_get_data[2] == 0x12)
             {
                FINDBORDER_DATA.dir = STRAIGHT;
             }
             break;
             

        case UART_FINE_TUNING:
            FINETUNING_DATA.dx = (float)uart->fifo_get_data[0];
            FINETUNING_DATA.dy = (float)uart->fifo_get_data[1];
            FINETUNING_DATA.dz = (float)uart->fifo_get_data[2];
            if (uart->fifo_get_data[3] == 0x01)
            {
                FINETUNING_DATA.FINETUNING_FINISH_FLAG = false;
				FINETUNING_DATA.IS_BORDER_ALIVE = true;
            }
            else if (uart->fifo_get_data[3] == 0x00)
            {
                FINETUNING_DATA.FINETUNING_FINISH_FLAG = true;
				FINETUNING_DATA.IS_BORDER_ALIVE = true;
            }
			else
			{
				FINETUNING_DATA.IS_BORDER_ALIVE = false;
			}
			break;
        default:
             break;
        }
		// memset(uart->fifo_get_data, 0, sizeof(uart->fifo_get_data));
    }
}

/**
 * @brief : 新版本并行解包方案
 * @param : 传入传输数据结构体
 * @return : None
 * 
 */
void UART_UnpackDataV2(UnpackDataTypeDef* UnpackFlag)
{
    if(UnpackFlag->FINDBORDER_DATA_FLAG)
    {
        UART_UnpackData(&_UART_FINDBORDER);
    }
    // if(UnpackFlag->FINETUNING_DATA_FLAG)
    // {
    //     UART_UnpackData(&_UART_FINE_TUNING);
    // } 
}

/**
 * @brief : 重设解包标志位
 * @param : 解包标志位结构体
 * @return : None
 * 
 */
void UART_ResetUnpackFlag(UnpackDataTypeDef *UnpackFlag)
{
    UnpackFlag->FINDBORDER_DATA_FLAG = false;
    UnpackFlag->FINETUNING_DATA_FLAG = false;
	UnpackFlag->FINETUNING_DATA_START_FLAG = false;
}

/**
 * @brief: 串口发送一个字节 
 * @param: 串口索引, 发送的字节
 * @param: #define UART_CLASSIFY_PIC (0x06) // 开始识别分类的图像
   @param: #define UART_CLASSIFY_SMALLPLACE (0x07) // 开始识别小类放置区域
   @param: #define UART_CLASSIFY_BIGPLACE  (0x08)  // 开始识别大类放置区域
 * @return： None
 */
void UART_SendByte(UART* uart, uint8_t data)
{
    uart_write_byte(uart->UART_INDEX, data);
}
