EveAaA/DEBUG_SmartCar_main/DEBUG_SmartCar_main/project/code/MyDrivers/Inc/Beep.h

#ifndef _BEEP_H
#define _BEEP_H

#include "zf_common_headfile.h"

typedef enum
{
    On,//常开
    Off,//常关
}Beep_Handle;
extern uint8 Beep_Count;
extern uint16 Beep_Cnt;
void Beep_Init();
void Beep(Beep_Handle Mode);
void Beep_On();
void Set_Beeptime(uint16 Set_Time);
void Beep_Freq();
void Set_Beepfreq(uint8 Count);

#endif
