EveAaA/DEBUG_SmartCar_main/DEBUG_SmartCar_main/project/code/MyDrivers/Inc/FSM.h

#ifndef FSM_H_
#define FSM_H_

#include "zf_common_headfile.h"

typedef void (*EventAction_t)(void);  //当前状态执行函数的指针
typedef bool (*EventJumpCondition_t)(void);   //跳转事件条件函数的指针（函数只能返回1或0）

typedef struct FSMTable  //状态表
{
	uint8 CurState;  //当前状态（枚举类型从0开始）
	EventAction_t EventAction;  //当前状态执行函数的指针
	EventJumpCondition_t EventJumpCondition;   //跳转事件条件函数的指针
	uint8_t NextState;  //下一个状态
}FSMTable_t;

typedef struct FSM  //状态机
{
	uint8 CurState;  //当前状态（枚举类型从0开始）
	uint8 Fsm_Number;//状态机编号
	FSMTable_t *FsmTable;  //状态表
}FSM_t;


void FSMInit(FSM_t *fsm, uint8 state, FSMTable_t *fsmtable,uint8 Number);
void FSMRun(FSM_t *fsm);

#endif
