EveAaA/DEBUG_SmartCar_main/DEBUG_SmartCar_main/project/code/MyMiddleware/Inc/Meau.h

#ifndef MEAU_H_
#define MEAU_H_

#include "UserMain.h"

void Arrow_Display(int Line);
void Get_Page();
void Meau_Display();
//�еĺ궨��
#define Line_0 (16*0)
#define Line_1 (16*1)
#define Line_2 (16*2)
#define Line_3 (16*3)
#define Line_4 (16*4)
#define Line_5 (16*5)
#define Line_6 (16*6)
#define Line_7 (16*7)

//�еĺ궨��
#define Row_0 (8*0)
#define Row_1 (8*1)
#define Row_2 (8*2)
#define Row_3 (8*3)
#define Row_4 (8*4)
#define Row_5 (8*5)
#define Row_6 (8*6)
#define Row_7 (8*7)
#define Row_8 (8*8)
#define Row_9 (8*9)
#define Row_10 (8*10)
#define Row_11 (8*11)
#define Row_12 (8*12)
#define Row_13 (8*13)
#define Row_14 (8*14)
#define Row_15 (8*15)
#define Row_16 (8*16)
#define Row_17 (8*17)
#define Row_18 (8*18)
#define Row_19 (8*19)
#define Row_20 (8*20)

extern int Set_Line;

#endif /* MYMIDDLEWARE_INC_MEAU_H_ */
