EveAaA/DEBUG_SmartCar_main/(commit log)

2023-10-24 工程框架上传
2023-10-26 母版硬件第一版本
    [BOM_Board1_PCB1_2023-10-26.xlsx]
2023-11-01 上传电机驱动
2023-11-02 电机驱动PCB
    [2020智能车.PrjPcb, 2020智能车.SchDoc, 2020智能车.xlsx, Altium 普通库.PcbLib, DRV8701_DualMotorDriver V1.1.PcbLib, DRV8701_DualMotorDriver.SCHLIB, HIP4082-DualMotorDriver.PcbLib, HIP4082-DualMotorDriver.SCHLIB]
2023-11-03 加入蓝牙与上位机通讯
2023-11-03 PID算法上传
2023-11-03 修正了一些注释
2023-11-04 上传了编码器驱动、陀螺仪姿态解算、速度闭环（初步）
    注意所有初始化内容写在User_Init函数里面
2023-11-04 上传按键驱动
2023-11-05 添加上位机调参协议
    未测试版（不影响前版本功能）
2023-11-05 上传机械臂驱动
2023-11-05 补充上次上传
2023-11-05 上传正确版本
2023-11-05 完成测试1
2023-11-07 上位机调参(速度环)+增加输出通道至CH15+添加速度环每个轮子存放PID参数的数组
    通过上位机输入标识符+数值例如输入lfp12.05即可对LF轮Kp值修改为12.05
    同理标志符有
    lfi, rfp, rfi, lbp, lbi, rbp, rbi
2023-11-11 更改了电机驱动，完成了初步的速度闭环（有待调整）
2023-11-16 上传了菜单显示（未完善）
2023-11-17 更新 keil-assistant.log
2023-11-24 更新 c_cpp_properties.json
2023-11-25 修改按键的驱动，改为了用定时器的状态机读取
2023-11-25 创建 DC电路板.eprj
    [DC电路板.eprj]
2023-12-14 图像处理、惯性导航初步完成
2023-12-24 目标板检测
    1.添加简单决策,寻找最近目标板
    2.串口通讯返回目标板误差值
    3.主控代码添加串口通讯文件，解析数据,
    4.添加转向函数(车头转向目标板), 调用Pid接口
    [DC电路板.eprj]
2023-12-24 修改了一下PCB文件
    [2020智能车.PrjPcb, 2020智能车.SchDoc, 2020智能车.xlsx, Altium 普通库.PcbLib, BOM_Board1_PCB1_2023-10-26.xlsx, DC电路板.eprj, DRV8701_DualMotorDriver V1.1.PcbLib, DRV8701_DualMotorDriver.SCHLIB]
2024-02-04 总钻风方案+三摄像头方案
    总钻风识别角点基本完成, 算法未优化融合
    三摄像头搭建基本识别思路
2024-02-04 模型分为yolo和classify文件
    不同模型分类存放
2024-02-08 添加FAST角点检测
    算法未融合
2024-02-08 添加新模型数字+分类+字母
    添加日志文档
2024-02-15 增加自动阈值追踪色块
2024-02-16 修改了一些常用算法的数据类型，建议非必要不要定义为double类型
2024-02-18 旋转编码器驱动完成，菜单和调参功能基本完成
2024-02-20 经测试识别放置区域准确率为98以上
2024-02-22 一维OTSU优化版python脚本实现版本
    None
2024-02-22 OTSU测试
2024-02-24 OTSU改
2024-02-25 版本3母版原理图完成
    [引脚分配v1.3.xlsx, 智能母版V3.eprj, 智能视觉母版_V2.eprj, 智能视觉调参板.eprj]
2024-02-26 自适应阈值B通道自动分割最终版(未场地测试)
    不需要手动调节阈值
    开机自动调节
2024-02-29 版本3母版和调参板完成
    [引脚分配v1.3.xlsx, 智能视觉母版_V2.eprj, 调参板V2.eprj]
2024-03-11 适配了新硬件的程序
    [OpenArt拓展板.eprj, OpenArt拓展板v1.4.eprj, 调参板V2.eprj]
2024-03-11 串口收发解包
2024-03-11 找卡片板
2024-03-12 走赛道+找卡片 (未测试)
2024-03-13 状态机更新
2024-03-24 十字补线基本完成，转动指定角度函数基本完成
2024-03-30 串口中断+串口并行解包
2024-03-30 提升了巡线速度
2024-04-01 串口添加角度
2024-04-01 转动角度动作完善、状态机完善
2024-04-04 微调串口改
2024-04-16 近期调试结果，初步完成赛道两旁卡片的状态机，完善了各类驱动，加入了上位机调参功能
2024-04-26 母版V4
    [引脚分配v1.3.xlsx]
2024-04-26 适配了一下新的硬件，控制部分减少了代码的耦合度
2024-04-26 圆环代码调试后更新
2024-04-27 新版状态机
2024-05-03 机械臂动作完善，横向循迹加入（未测试）
2024-05-04 调试后上传
2024-05-05 左圆环完善
2024-05-06 右侧圆环(未测试，未加陀螺仪辅助)
2024-05-07 主控获取openart识别种类
2024-05-07 识别openart根目录文件夹
    [cmm_cfg.csv]
2024-05-10 机械臂、圆环完善
2024-05-31 赛道旁状态机基本完善，加入了很多东西，机械臂的动作似乎有bug
2024-05-31 调试后上传，修改了速度环的控制周期
2024-06-01 修改了状态机
2024-06-01 更新微调标志位
    0x00 未完成标志位
    0x01 完成微调标志位
    0x02 完成X轴微调标志位
2024-06-01 调试后上传，把微调的X轴和Y轴完全分开
2024-06-01 解决串口丢包 数据异常的问题
2024-06-02 加入了转盘的速度控制
2024-06-02 上次传的有BUG，重新传一下
2024-06-05 终点前数字板寻找
    #define UART_FINDBORDER_GETBORDER (0x21) // 开始获取道路边缘的目标板
    #define UART_STARTFINETUNING_PLACE (0x10) // 开始对数字版微调整
    使用UART_SendByte函数发送指令
2024-06-07 图像代码有大更新，圆环基本完成
2024-06-12 大类放置区域串口信息获取修复
    BIG_PLACE_DATA.Big_Place 获取串口发送的数字板信息
2024-06-12 终点前卸货状态机完善
2024-06-12 终点前状态机调试后上传
2024-06-13 卸货状态机完善
2024-06-14 状态机修改
2024-06-14 调试 后上传
2024-06-15 图像代码十字部分更新，修改了寻找拐点的方法，加入了多种情况的判断
2024-06-16 十字状态机初步
2024-06-16 OpenArt+纵向循迹
2024-06-16 微调摄像头main.py
2024-06-17 十字状态机
2024-06-17 十字圆环测试后上传
2024-06-18 修改了一下十字状态机的BUG
2024-06-18 十字状态机调试后基本完成
2024-06-20 适配了新结构
2024-06-20 十字、终点前卸货状态机调试后更新
2024-06-28 十字状态机改
2024-06-29 加入圆环状态机(初步)
2024-06-30 十字状态机修改
    [OpenArtV3改.eprj]
2024-06-30 十字调整，仓库未完善
2024-06-30 小类存入仓库(未实地测试)
2024-07-01 菜单修改，十字仓库修改
2024-07-01 补充上传
2024-07-01 十字状态机调试后上传
2024-07-03 圆环状态机完善（未测试）
2024-07-03 修改了一些调试的时候遇到的bug
2024-07-03 十字环岛功能基本实现
2024-07-04 状态机基本完成
2024-07-05 修改了一些发现的bug
2024-07-05 调试后上传，有bug
2024-07-06 修改了圆环和十字的状态机
2024-07-06 版本回退
2024-07-07 状态机完善，尝试加入开门动作
2024-07-07 开门动作
2024-07-08 修改了圆环的判定
2024-07-08 右圆环更新
2024-07-09 加入图传
2024-07-13 较为稳定版本
2024-07-14 针对S弯目标板串口
2024-07-14 终点前不同方向放置区域判断
2024-07-14 Uart4 道路边目标板
2024-07-14 整合了前面摄像头
2024-07-15 较为稳定能够完善版本
2024-07-16 比赛版本
2024-07-17 赛后上传
2024-07-27 摄像头下移串口修改
2024-07-27 摄像头下移方案
2024-08-05 MCX方案
    1.移植openart所有状态机
    2.添加调参菜单
    3.添加sd卡掉电锁存
2024-08-07 适配新的屏幕，修改了图像大小
2024-08-08 适配了新的调参版的菜单
2024-08-08 MCX完整测试版，添加自训练模型， 多个调参界面
2024-08-09 DEBUG智能视觉技术报告
2024-08-11 技术报告初步整合
2024-08-13 所有模型(识别模型EfficientNet -> MobileNet)
2024-08-13 往菜单里加了一下参数，预防决赛不能下代码
2024-08-13 修改了障碍
2024-08-13 调整目标板中心位置细分降低
2024-08-13 技术报告差不多完成，上传了一些调试视频
2024-08-13 字母板模型迭代(EfficientNet -> MobileNet) 4倍识别速度
2024-08-13 2024-8-14调试后Openart SD卡文件
    [cmm_cfg.csv]
2024-08-15 修改了终点前卸货状态机
2024-08-15 MCX终点前
2024-08-15 MCX调试时间2024-8-16
2024-08-15 2024_8_16前摄像头SD文件夹
    [cmm_cfg.csv]
2024-08-16 部署在服务器上训练的炼丹炉
    Tensorflow框架
2024-08-16 目标检测数据增强代码&&多进程图像分类数据增强代码
2024-08-16 比赛版本代码上传
2024-08-22 全国总决赛版本
2024-08-22 MCX全国总决赛版本
2024-08-22 上传两个国赛视频
2024-08-24 硬件补充上传
    [DC电路板.eprj, DRV8701E双驱.eprj, HIP4082电机驱动.eprj, 智能视觉母版_V2.eprj, 智能视觉调参板.eprj, 灯板.eprj, 调参板V2.eprj]
