EveAaA/DEBUG_SmartCar_main/(notices)

Notices in the files:
DEBUG_SmartCar_Vision/MCX_DEBUG/project/user/zf_model_process.cpp:
Copyright (c) 2024 SEEKFREE Öð·É¿Æ¼¼
DEBUG_SmartCar_main/project/user/src/isr.c:
Copyright (c) 2022 SEEKFREE Öð·É¿Æ¼¼
